Lenti84/VdMot_Controller/hardware/c3_housing_above.png

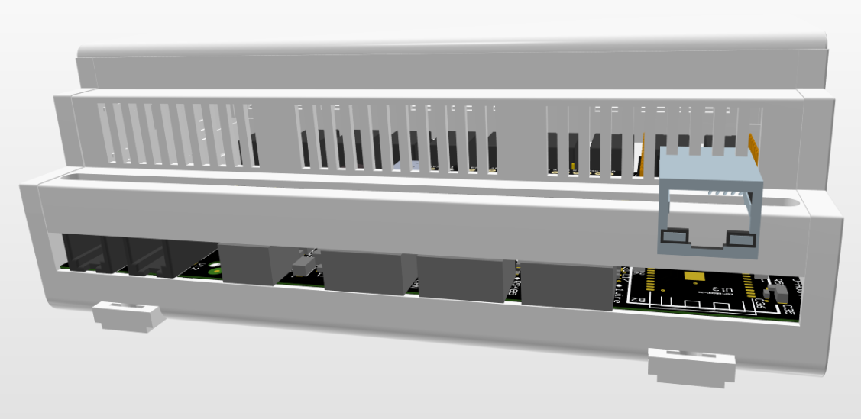
hardware/c3_housing_above.png
