Lenti84/VdMot_Controller/hardware/c3_housing_bottom.png

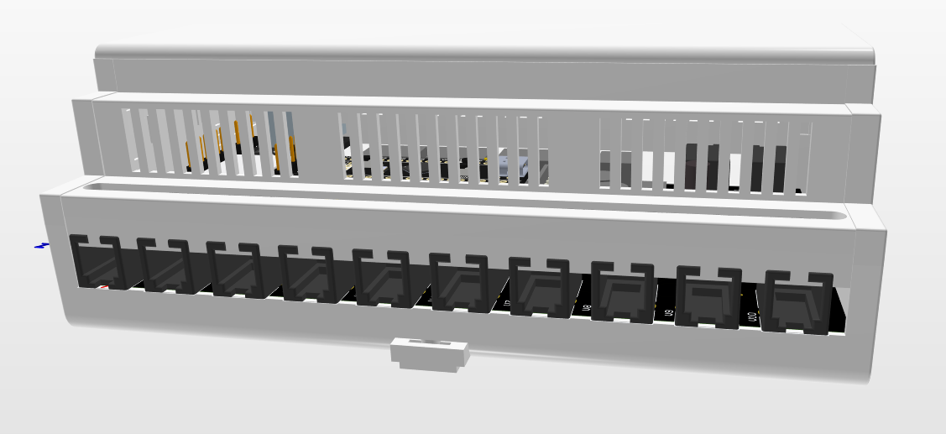
hardware/c3_housing_bottom.png
