Lenti84/VdMot_Controller/software_esp32/media/main.png

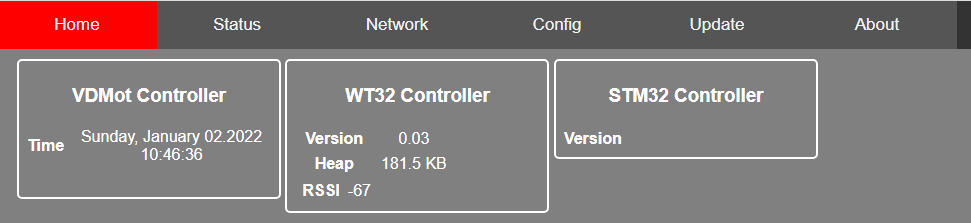
software_esp32/media/main.png
