Lenti84/VdMot_Controller/software_esp32/web_pages_source/h/window_close.png

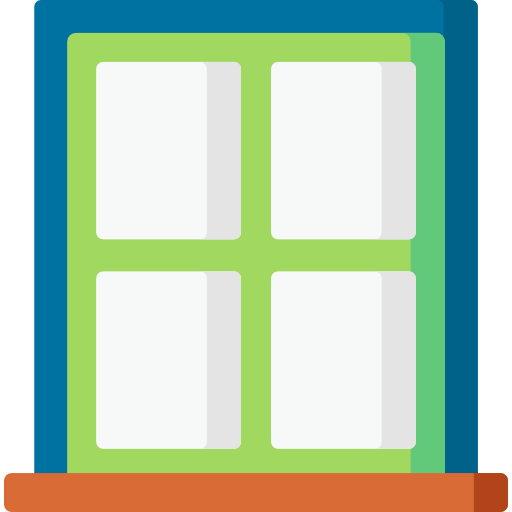
software_esp32/web_pages_source/h/window_close.png
