Lenti84/VdMot_Controller/software_stm32/ChangeLog.md

# Changelog
All notable changes to this project will be documented in this file.

## [Unreleased] - Development

### Breaking Changed

### Changed

### Fixed

### Removed

## [1.3.7]
### Fixed
- Config :      fix bug valve 12 set tIdx1 and tIdx2 was not saved

## [1.3.6]
### Changed
- rework motor end detection (filtering of motor current, no soft PWM for motor turn on anymore)

## [1.3.4]
### Changed
- faster motor end detection
### Added
- min. counts in eeprom
- calibration retries if counts less than min. counts in config

## [1.3.3]
### Added
- get chip id

## [1.3.2]
### Changed
- led heartbeat : change frequency 3s off / 100ms on

## [1.3.1]
### fixed
- next calibration : movements set to min. 50

## [1.3.0]
### Fixed
- calibration move numbers was not set from eeprom
- calibration function was not correct
### Added
- send calibration state to WTH32

## [1.2.2]
### Add
- send valve movements, open counts, close counts, dead counts with cmd APP_PRE_GETVLVDATA

## [1.1.0]
### Changed
- new command : APP_PRE_EEPSTATE : gets the state of eeprom (1 = ready, 0 = write pending)
- disable motDebug also in DEV to prevent handling UART in interrupt routines
- set default motor low / high to 17 (1.7) 

## [1.0.9]
### Fixed
- UART : max read length for UART buffer is limited to 990 now, not unlimited anymore
- valves : valve_loop() is now called via timer interrupt, this hopefully ensures correct motor drive and stopping during high system loads

## [1.0.8]
### Changed
- Softreset timing changed

## [1.0.7] 
### Added
- new STM32 commands

### Fixed
- fixed problems with configuration of 1-wire sensors (matching to valves)
