Lenti84/VdMot_Controller/(threads)

Thread 1 (2021-04-09):

Great Project

xal88, 2021-04-09:
Hallo,
habe  von deinem  Projekt im FHEM Forum gelesen.
Das wäre genau, was ich mir für meine Deckenklimatisierung als Steuerung wünsche.
Die ist nicht so träge wie eine Fußbodenheizung und braucht ordentliche Regelung, nicht nur 0/1.
Daten der Wärmepumpe, VL/RL und Thermostate habe ich schon in MQTT.
I2C fur HTU21D ( Humidity/Temperature -> Taupunkt im Verteiler )  würd ich am ESP dazubauen... ( die Onewire DHT22 sind Mist bei 100% Feuchte )...
Wenn du Prototypen/Kleinserie machst,  beteilige ich mich gerne an den Kosten und würd 1 zum testen  und ggf. 3 Stk für Echt nehmen
danke+lg
Alf

Lenti84, 2022-01-04:
Info: hinsichtlich Bausatz bitte immer mal wieder im FHEM Forum vorbeisehen: https://forum.fhem.de/index.php/topic,103699.0.html

xal88, 2022-01-07:
Hallo,
wegen Bausatz hab ich dir eine PM im FHEM Forum gesendt.
Wie sieht es aus mit feature requests für die nächste Serie? Mich würde ein Anschluss für einen Durchflussmesser ( interrupt/Hall ) interessieren, weiterverarbeitung dann über MQTT :-)
lg Alf

Lenti84, 2022-01-11:
Ziel für die nächste Revision ist quasi nichts zu ändern. Kann dir deshalb leider nichts versprechen.

Im aktuellen Release gibt es aber sogar noch ungenutzte Pins, die auf eine Stiftleiste herausgeführt sind.
Über X15:Pin7 (INT) lässt sich sicher ein externer Schalter anschließen. PullUp wäre auch vorhanden.
Softwareseitig müsste geklärt werden, ob der Pin PB8 für externe Interrupts genutzt werden kann.

Beste Grüße
Andreas

xal88, 2022-01-12:
Danke, alles klar. Ich glaub da nehm ich lieber einen IO vom ESP32 - ist auch einfacher für die SW-Erweiterung.
Mit dem STM32 kenn ich mich nicht aus...

Closed 2022-01-12.

Thread 2 (2021-09-06):

C-sample Hardware Issues and Change Requests

Lenti84, 2021-09-06:
I'm planning to design an updated version of the hardware. Next step of hardware will be called C-sample.
Therefore i want to collect known issues and possible change requests.

**currently known issues**
- B4: footprint for dc-dc converter: crossed secondary side pinout for gnd and vout
- V3: false assembly of NPN bipolar instead of PNP type
- X15, 21: hole diameter to small
- X1...X12: connection to MEBP_4-4S wrong: interchange pin 1 with pin 2
- no holes for case screws

**change requests**
- current consumption of L293 is 50 mA each, should be lowered, maybe U1, U3, U8 should be shut down during idle
- voltage devider at net "Sense" to match voltage levels better from opamp to STM32
- bypass capacitor for ESP8266
- replace relay K1 by analog switch
- support STM32F401 blackpill boards instead of STM32F103 bluepill
- maybe switch from ESP8266 to ESP32 or WT32-ETH01
- ....

Please feel free to comment your suggestions so maybe i can consider implementing them.

nstadigs, 2021-10-12:
Hi! Thanks for this great project!

I have 13 valves to control. Would it be possible to squeeze in control for an extra connector (or two, to make the number even)? Or maybe add support for an extension board? :grimacing:
I know this might be a big request, but I had to ask :)

Lenti84, 2022-01-04:
c-sample revision of hardware implemented --> closed

Closed 2022-01-04.

Thread 3 (2021-10-15):

Increase number of valves to control

Lenti84, 2021-10-15:
Hi! Thanks for this great project!

I have 13 valves to control. Would it be possible to squeeze in control for an extra connector (or two, to make the number even)? Or maybe add support for an extension board? :grimacing:
I know this might be a big request, but I had to ask :)

_Originally posted by @nstadigs in https://github.com/Lenti84/VdMot_Controller/issues/2#issuecomment-940762894_

Closed 2022-01-04.

Thread 4 (2021-10-15):

Correction function for DS18B20 temperature sensors

Lenti84, 2021-10-15:
Great to see some updates :-)
What I would like to have is an option to enter calibration values for the Onewire temperature sensors.
My temperature range is 15-32 deg Celsius ( cooling/heating )
If I have a bunch of DS18B20, I can see values +/- 1,5K. No need to meet the exact temparature, but all sensors should have the same base temperature, even when a little bit wrong.
Simple linear regression formula ( y= kx+d) with a way to enter the k,d values per sensor would help - otherwise I  would do that in the MQTT server.
Gold star solution to have an auto-calibration mode. Run once when the whole system is OFF and its cold ( e.g. 15°C), store the values), same when distribution cabinet is hot ( 35°, and all OFF for a while ). Then do the mean values and calc the regresssion.
Cheers Alf

_Originally posted by @xal88 in https://github.com/Lenti84/VdMot_Controller/issues/2#issuecomment-940857581_

Lenti84, 2022-01-04:
Will be implemented in next versions

Closed 2022-01-04.

Thread 5 (2021-10-21):

RJ45 Network

SurfGargano, 2021-10-21:
Is there a RJ45 Network available ?

Lenti84, 2021-10-21:
Next hardware revision (C-sample) will have a WT32-ETH01 board for communication with wifi and ethernet. So yes.

Lenti84, 2022-01-02:
Ethernet via RJ45 is available since c-sample revision.

Closed 2022-01-02.

Thread 9 (2021-12-31):

Why are there 2 MCUs?

unaiur, 2021-12-31:
Great project! It is something I has need searching for a while but I have one question... why is the second MCU required?

ESP32 is quite capable, has 2 "high" speed cores plus a low power coprocessor and plenty of peripherals, like a Hall effect sensor and an   opamp to measure current and a ADC that is fast enough to count revolutions by software.

I am sure you have some reason to use the STM mcu as the core instead. I just would like to know.

Thank you very much!

Lenti84, 2022-01-04:
I wanted to make the VdMot Controller a kind of modular.
STM32 is the core of the system for motor control, valve managing, RS485, 1-wire and optional CAN.
Wifi / Ethernet is only an option and realised via the ESP32 (older hw revision ESP8266).

If you look the other way round the STM32 is a cheap and intelligent port extension for the ESP ;-)
Meanwhile the STM32 it is fully flashable via ESP32 web interface...

unaiur, 2022-01-06:
Ummm, I would like to use the low power RiscV core inside Esp32s2 instead, to reduce the component count and make it simpler (I am a software guy).

Also, I will try to use the 13bit/6Khz ADC in that core to measure the active motor current across a 1ohm resistance and try to identify the back EMF using software implemented low/high pass filters.

xal88, 2022-01-07:
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

Hi,
I think that the project has a good modular HW design for now, with the ESP32 a very common, good available cheap chip.
And you can flash the STM32 from webserver on ESP...
The ESP2S has only 2 13 bit ADCs, so this is no option. And it is a single Core CPU, and the old ESP single cores had problems with interrupts when using WiFi....
But in the end its Andreas design, and he has put a lot of effort into the current design.

Lenti84, 2022-01-11:
I think to remember the motors do approx 8000 counted revolutions in 60s running time. So this should be slow enough for a software appraoch then.

Please keep in mind that with actual hardware concept you will need more pins than the usual ESP32 can offer. Thus you will need a port expander oder something similar.

But at the actual state of the project i cant justify such fundamental changes...

unaiur, 2022-01-12:
The Esp32s2 chip has two cores; a fast core and an ultra low power core
that is always on. Nonetheless, the ultra low power core has more than
enough power to control the motors.

I only plan to drive one motor at a time. I will select the active L298
chip using 8 pins and all 8 L298 will share the same 4 input lines. I will
use another pin to read the motor current: 13 pins in total to manage 16
motors.

The Esp32s2 has more than 20 available pins, so I have plenty of IO
available in case I need an external ADC or the hardware spin counter you
have.

I will keep you updated about my experiment.
I already ordered the pieces. If it works, I would try to build a single
board with all the components instead of 10 different interconnected boards.

Thank you very much!

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

Lenti84, 2022-01-26:
I wish you success! Keep us updated.

Closed 2022-01-26.

Thread 16 (2022-01-19):

ESP32 User Interface - More temperature sensors than valves

xal88, 2022-01-19:
Hello,
Usecase:  8 Valves, 10x Onewire sensor  ( one for each valve, plus one for manifold input and output )

* How will this look like in the status page ?

* Config page needs a mapping from Onewire_ID to Name and valve
   STM32 command list ist talking of 36 possible Temperature sensors
  ``` stsnx x y:    |   set first 1-wire sensor index y to valve x    |     x=0...11, y=0...35```

   And why are there 2 commands [ stsnx | stsny ], as there is only one 1-wire bus?

Thanks, and keep up your great work
regards

Lenti84, 2022-01-26:
Hi xal88,

this can look like following picture, but with more entries for each item:
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

Config page can now connect sensors to valves and sensor count was corrected.

There are two commands. One for first temp sensor assigned to valve x and one for second temp sensor assigned to valve x. Temp sensors are all connected to the same 1-wire bus.

Closed 2022-02-08.

Thread 23 (2022-02-12):

Information how to order

wendy2702, 2022-02-12:
Hi,

can you provide some information on how to order and costs?

Lenti84, 2022-02-13:
I recently put the board on tindie:
https://www.tindie.com/products/lenti/vdmot_controller/

Please have a view for scope of delivery, order information and costs.

Lenti84, 2022-04-15:
Hello everybody! Boards are now available via Tindie.

dreitakter, 2022-11-27:
The THT Parts are Not available in the Store.
I want to buy two complete Kits. Will this be possible soon or are These the Last parts that you sell?

Lenti84, 2022-11-27:
New/more THT parts will be available at the end of next week.

dreitakter, 2022-11-27:
Nice. Remind me when the parts are available. Thank you :)

Lenti84, 2022-12-07:
Last few parts for 2022 available at Tindie.
New parts will probably be available from january 23.

uplight-dev, 2023-01-06:
I'm not sure but is Tindie the only option to build this board(i.e. closed source)?
Or can I print this board myself to pcbway.com or similar?

Thanks!

Lenti84, 2023-01-07:
At the moment there are non plans to fully publish hardware sources (Gerber...).
But the full schematic, some description and BOM you can already find in GitHub.
As the project was not created in EasyEda, I will not port it.
Kind regards

Lenti84, 2023-01-20:
New boards, THT parts, BlackPill Boards and some WT32-ETH01 boards are back in stock at Tindie.

Check out https://www.tindie.com/products/lenti/vdmot_controller/
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

Lenti84, 2023-03-20:
Moved information to: https://github.com/Lenti84/VdMot_Controller/wiki/FAQ/

Closed 2023-03-20.

Thread 31 (2022-06-07):

ESP32 compile fails, please provide all BINs

xal88, 2022-06-07:
Hello,
asembled the kits last weekend, but could not compile via VSC Platformio. (C++ errors )

Could you please add the additional needed BIN-files for flashing the ESP32, so that I can use esptool.py without compiling?
(or did you pack all the files into your firmware.bin, so I could upload to address 0x1000 ?)

e.g.
```
esptool.py --chip esp32 --port COM4 --before default_reset --after hard_reset write_flash -z --flash_mode dio --flash_freq 40m /
            --flash_size detect /
            0x1000 bootloader_dio_40m.bin  /
            0x8000 partitions.bin /
            0xe000 boot_app0.bin /
            0x10000 firmware.bin
```

Erasing is working so far, so the system looks OK..
```
esptool.py --port COM4 erase_flash
    esptool.py v2.8
    Serial port COM4
    Connecting......
    Detecting chip type... ESP32
    Chip is ESP32D0WDQ5 (revision 1)
    Features: WiFi, BT, Dual Core, 240MHz, VRef calibration in efuse, Coding Scheme None
    Crystal is 40MHz
    MAC: 8c:ce:4e:94:82:dc
    Uploading stub...
    Running stub...
    Stub running...
    Erasing flash (this may take a while)...
    Chip erase completed successfully in 14.0s
```

Thanks for your help
Alfred

[202206071941_VSCcompile.log](https://github.com/Lenti84/VdMot_Controller/files/8855383/202206071941_VSCcompile.log)

xal88, 2022-06-07:
fixing resolution to int in helper.cpp at least makes it to compile and run...
```
String ConvBinUnits(size_t bytes, byte resolution)
{
  if  (bytes < 1024) {
    return String(bytes) + " B";
  }
  else if (bytes < 1024 * 1024) {
    return String(bytes / 1024.0,  int(resolution)) + " KB";
  }
  else if (bytes < (1024 * 1024 * 1024)) {
    return String(bytes / 1024.0 / 1024.0, int(resolution)) + " MB";
  }
  else return "";
}
```

Lenti84, 2022-06-07:
I added information for flashing ESP32 to https://github.com/Lenti84/VdMot_Controller/blob/master/assembly_kit/installation.md.
Bin files can be found at https://github.com/Lenti84/VdMot_Controller/tree/master/software_esp32

Firmware fix will be added soon to developer branch.

xal88, 2022-06-08:
could upload the provided .bin-files with ESP_Tools. VdMot is working now.
Would be great if you place **partitions.bin** in the same location ( had to take it from my VSC Platformio files )

The STm upload instructions should close with something like
* 11 Wait for upload finishes
* 12 remove X20 connection
* 13 ( reboot?)

Closed 2022-06-08.

Thread 32 (2022-06-07):

Webpage STM firmware - empty list after upload

xal88, 2022-06-07:
Hello,
when using the /stmupdate webpage, I can upload the file from my Computer.
File "STM32_C2_firmware.bin" is uploaded:
```
file has arguments : 1
file has argument stm
filename : /stm/STM32_C2_firmware.bin
upload finished
```
When trying to delete the file, the webpage is accessing
```
"remove(): /STM32_C2_firmware.bin"
```
and fails. The list ***Please select one file:*** stays empty, and no update for the STM32 can be selected.

Kind regards
Alfred
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

xal88, 2022-06-08:
this is working now with the new uploded binary 1.02

Closed 2022-06-08.

Thread 35 (2022-06-08):

How to set valve position target from remote

xal88, 2022-06-08:
Hello,
have 1 valve and 12 DS18B20 running now.
Data is forwarded to MQTT, and json can be queried by http get.

### How do I set the target valve position from remote?

* json command
how to  execute "/cmd"  with the stm *stgtp x y* ?
* MQTT changing the value setting /VdMot/valves/F01/target to 60 on the mosquitto server:
This crashes the MQTT client, temperatures are continuing updating, valve does not.
````
[E][WiFiClient.cpp:395] write(): fail on fd 54, errno: 104, "Connection reset by peer"
Reconnecting MQTT...
[E][WiFiClient.cpp:485] flush(): fail on fd 55, errno: 104, "Connection reset by peer"
Reconnecting MQTT...
[E][WiFiClient.cpp:395] write(): fail on fd 56, errno: 104, "Connection reset by peer"
Reconnecting MQTT...
[E][WiFiClient.cpp:485] flush(): fail on fd 57, errno: 104, "Connection reset by peer"
Reconnecting MQTT...
[E][WiFiClient.cpp:395] write(): fail on fd 58, errno: 104, "Connection reset by peer"
Reconnecting MQTT...
[E][WiFiClient.cpp:395] write(): fail on fd 59, errno: 104, "Connection reset by peer"
Reconnecting MQTT...
[E][WiFiClient.cpp:395] write(): fail on fd 60, errno: 104, "Connection reset by peer"
valve position has changed : 0 = 50
Reconnecting MQTT...
[E][WiFiClient.cpp:395] write(): fail on fd 61, errno: 104, "Connection reset by peer"
Reconnecting MQTT...
````

kind regards
Alfred

xal88, 2022-06-08:
and could you please remove the leading ***/*** in the mqtt path?
Gives an ugly empty structure...

thanks
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

xal88, 2022-06-09:
for MQTT I disabled the checkbox "Publish Target", but this did not change behavior.
After a "/config/Restore FactoryDefault settings" and giving different names for valve and sensor now this is working. I can set the target via MQTT.

For JSON I did a detailed reading of software.md (again), but the examples and instructions for JSON are only about reading values, and saving configs.  "/cmd2 is about triggering actions.
Could you provide an example how to set a target value?

xal88, 2022-06-09:
Update MQTT:
When setting /config/MQTT interval(ms) to a larger value ( tried 60000 for updates every minute ), looks like the subscribe times out, and gives the "104" error
Have not seen any keepalive setting in the code.
10000 ( =10s) works fine.

Closed 2022-10-14.

Thread 36 (2022-06-10):

Temperatur data of sensors with No. > 12 not published

xal88, 2022-06-10:
Have 14 sensors connected.

Only sensors with number <= 12 are published, if they are not asigned to a valve.
 ( same for GUI status, JSON /temps and MQTT /VdMot/temps/. )

 Plus the GUI sensor numbering in "/status/Temperature" and in "/config/Temperature sensor"  have different numbers for the same sensor :-(

Sensors with Numbers > 12 can be asigned to valves, and shows up correctly there.

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

### change proposal ###
I would opt that the /temps publishes ***ALL*** temperature values, not only the not asigned sensors. It is very hard to know for an external home automation system which sensor has which function. Plus the asigned sensor data vanishes, if the sensor is not there at boot, the not asigned sensors are found again at later time.
Kind regards
Alfred

xal88, 2022-06-12:
### update
checked with a sensor chain of 25 sensors.
The sensor chain was tested on an ESP32 on USB poer, DATA direct to PIN, with 4k7 pullup.
100 scans -> 100% detection rate, 100 reads per sensor -> 100% sucess rate

Looks like only the last sensor is not displayed in /Temperature

xal88, 2022-06-23:
After checking each sensor with single tests, I found  that the VdMot 1-wire is not working with all sensors.
Some are not detected  at scan, other detected, but no data, some get data if ID manually entered into GUI.
I will open an new issue for that.

For this issue, could you please add to the documentation, that only sensors are displayed that are found by scan ( less the asigned sensors ). Manually entered sensors are ignored in the output.
Furthermore please explain the function of the "active" tickbox in the /Config GUI. I cant see any changes after ticking this.

Closed 2022-10-14.

Thread 37 (2022-06-23):

1-Wire not seeing all DS18B20

xal88, 2022-06-23:
Some sensors are not detected by scan, others detected but no data.
GUI/config scan gives different results to the scans when booting.
Some sensor delivers data, if manually eintered ID in GUI/config

All sensors are tested and working with ESP PIN and 4k7 Ohm resistor.
Sensor answer is on the bus, but not picked up to i2c?

### Signaling on oszilloscope comparing ESP and VdMot looks ok.
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

### Logic compare "-22"  sensor detected, but no data,
ESP test sample OK
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
VdMot
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

### Logic compare "a9" sensor not detected
ESP Test sample OK
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
VdMot test
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

Lenti84, 2022-06-25:
If you compare the oscilloscope shots from ESP and STM you can recognize, that the voltage level with STM32 is not perfectly correct.
This is a flaw in the STM32 version of arduino 1-wire lib. But for my config it is working fine for currently 10 sensors.

I have tested a fix some time ago. I think it was in OneWire_direct_gpio.h
Instead of a PushPull output
`#define DIRECT_MODE_OUTPUT(base, pin)   pin_function((PinName)pin, STM_PIN_DATA(STM_MODE_OUTPUT_PP, GPIO_NOPULL, 0))`
a change to OpenDrain changed the voltage level problem
`#define DIRECT_MODE_OUTPUT(base, pin)   pin_function((PinName)pin, STM_PIN_DATA(STM_MODE_OUTPUT_OD, GPIO_NOPULL, 0))`

Maybe give it a try if this changes something.
I think i will integrate that in one of the next releases...

SurfGargano, 2022-11-12:
I have checked with 15 sensors and the modification in V1.05 of stm software: changing from push-pull to open drain.
It works.

xal88, 2022-11-12:
Thanks. Tried to compile the stm-1.05 with VSC/platformio, result is only 52 kB, old one was 198kB.
With esp32_1.02 and esp32_1.04 the file is growing from  1012->1128 kB.
Can this be right, could you maybe upload the stm firmware 1.05?

SurfGargano, 2022-11-13:
yes, 52 kB for stm 1.0.5 is correct The old one was about 48 kB
the esp file is 1106 kB with V1.0.5
I have uploaded the stm bin files in the bin directory in developer branch in my repo.
https://github.com/SurfGargano/VdMot_Controller/tree/developer/software_stm32/bin/v1.0.5

xal88, 2022-11-13:
WTH32 is at 1.05. OTA worked.
Tried to update the STM32 from 1.02 to 1.05.
Upload of the file ok, but after selecting file, and clicking "Update STM32 now" the progress bar goes to 5%, and then "error".
Self comiled firmware.bin or development branch same issue.
What am I doing wrong?

SurfGargano, 2022-11-13:
Pls try following : Format the spiffs by clicking the Format Button in Config section of the wth32. Upload stm bin file again and start the update of stm.Am 13.11.22, 21:14 schrieb Alf ***@***.***>:

  WTH32 is at 1.05. OTA worked. Tried to update the STM32 from 1.02 to 1.05. Upload of the file ok, but after selecting file, and clicking "Update STM32 now" the progress bar goes to 5%, and then "error". Self comiled firmware.bin or development branch same issue. What am I doing wrong?
  —Reply to this email directly, view it on GitHub, or unsubscribe.You are receiving this because you commented.Message ID: ***@***.***>

xal88, 2022-11-14:
Tried on 2 different VdMot boards, firefox or chrome, with WT32 on 1.05.
"/config/Format FS" gives no status update, just reboot. Uploaded Files are gone afterwards.
"update/ST32" gives 5%, than error and reboot.
Syslog atomic shows no useful messages, only the ones about the valve positions.
What else can I do - Blackpill update via external serial?

SurfGargano, 2022-11-14:
After Format the file info on the config page should be invisible. Is the stm still working?What does the serial debug of wt32 says?Am 14.11.22, 12:12 schrieb Alf ***@***.***>:

  Tried on 2 different VdMot boards, firefox or chrome, with WT32 on 1.05. "/config/Format FS" gives no status update, just reboot. Uploaded Files are gone afterwards. "update/ST32" gives 5%, than error and reboot. Syslog atomic shows no useful messages, only the ones about the valve positions. What else can I do - Blackpill update via external serial?
  —Reply to this email directly, view it on GitHub, or unsubscribe.You are receiving this because you commented.Message ID: ***@***.***>

Lenti84, 2022-11-14:
Have you tried initial flash with Pressung boot0 button in BlackPill Board?

https://github.com/Lenti84/VdMot_Controller/blob/master/assembly_kit/installation.md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

xal88, 2022-11-14:
update to 1.05_Dev initial flash did work, thanks for your help.
Connected 32 senors ( all I have ), found all - even the cheap chinese problematic ones.
Will close the issue.

Closed 2022-11-14.

Thread 39 (2022-10-15):

ESP32: STM32 Update list no files with V1.0.3

SurfGargano, 2022-10-15:
Some has changed in SPIFFS 2.0. Handling Slashes doesn't wok anymore. The filenames are stored without pathname.
So the V1.03 doesn't list the filenames.
This is fixed in V1.04. All files will be listed.
In next version spiffs will be changed to littlefs, because spiffs is deprecated.

SurfGargano, 2022-11-12:
Fixed in V1.04

Closed 2022-11-12.

Thread 45 (2022-11-11):

Multiple controllers for one room

zillawilli, 2022-11-11:
Hello

I have the following problem.

In my case, the kitchen is quite large, so the installer has installed 4 loops of floor heating.
Two are short, as these are to heat only a narrow edge to the outside wall.
The other two loops are long and heat the rest of the kitchen.
Each loop has its own valve.

As I understand it, only the control of one heating circuit per room is possible, right?

Would it be possible to group several circuits of a room together?

I would imagine this to be the case:
The inlet temperature must be measured with a single sensor.
Now, in order to theoretically determine the individual lengths of the combined heating circuits, a reference measurement must be made.

For this purpose, the temperature and the time until a certain temperature is reached is measured at the return of each circuit. The longest heating circuit requires the most time, the shortest accordingly less.
Based on this determined time, the longest heating circuit is now determined to the master and its return temperature is used as the setpoint for the other circuits. At the master, for example, the valve is 100% open, the other circuits correspondingly less.
If now the master must be opened more than 100%, a message is needed because of too low inlet temperature.
If now the valve with the smallest opening would have to be closed by the control, a message with too high inlet temperature is needed.

What do you say to this? Would something like this be possible?

greetings
William

SurfGargano, 2022-11-11:
If you have several loops of floor heating in one room , you have to make a hydraulic adjustment. That is important.

You can group the valves together in the control section, if you use the on-board valve controller.
But only one thermometer is used.

I have 3 loops of floor heating in living area, dining area and kitchen in one room. It works.

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

xal88, 2022-11-11:
Hi,
VdMot is flexible with assigning sensors to multiple circuits. And your control strategy is completely in your hands.
Without knowing the general setup ( what heat source, pump type and flow... ) its difficult to advise.
I would go with a static machanical hydraulic balance setup for your 4 kitchen valves, no need for motorvalves there.
Treat them as one circuit and control via heating system
BR Alfred

zillawilli, 2022-11-15:
Hello

Thank you for your responses, which have inspired me to think further.

The procedure for rooms with multiple heating circuits, in my case with four circuits, would now be as follows:

I measure the return temperature over time for all circuits.
Now all valves are opened completely and the flow reducers are also set to 100%.
After a time of 30 minutes the log files are read out and examined in a program.
Depending on the length of the heating circuit, a certain return temperature will be set.
The circuit with the longest pipe has the lowest temperature. The shortest has the highest.
Now the flows are reduced until all have the same return temperature as the longest heating circuit. But the valves are all still 100% open.
That is what I understand by hydraulic balancing.
Only now each valve is controlled individually, so that the return temperatures are all the same.

kind regards
William

Hallo

Danke für eure Antworten, die mich zum weiteren Nachdenken angeregt haben.

Der Ablauf bei Räumen mit mehreren Heizkreisen, in meinem Fall mit vier Kreisen, wäre nun folgend:

Ich messe bei allen Kreisen die Rücklauftemperatur über die Zeit.
Nun werden alle Ventile komplett geöffnet und die Durchflussminderer ebenso auf 100% gestellt.
Nach Ablauf einer Zeit von 30min werden die Logdateien ausgelesen und in einem Programm begutachtet.
Je nach Länge des Heizkreises wird sich eine bestimmte Rücklauftemperatur einstellen.
Der Kreis mit dem längsten Rohr hat die niedrigste Temperatur. Der kürzeste die höchste.
Nun werden die Durchflüsse so lange reduziert, bis alle die gleiche Rücklauftemperatur wie der längste Heizkreis aufweisen. Die Ventile sind aber alle noch zu 100% geöffnet.
Das ist, was ich unter einem hydraulischen Abgleich verstehe.
Nun erst wird jedes Ventil einzeln angesteuert, so daß die Rücklauftemperaturen alle gleich sind.

freundliche Grüße
William

Lenti84, 2023-03-20:
Moved information to: https://github.com/Lenti84/VdMot_Controller/wiki/FAQ

Closed 2023-03-20.

Thread 50 (2022-11-27):

Cable length to actors

dreitakter, 2022-11-27:
Hi.
Do you have any Idea which cable length is possible between the Controller Board and the actors?

SurfGargano, 2022-12-19:
I have 10 meters from controller to 2 actors installed. It works without problems. I used shielded KNX kable ( 4x 0.8 mm²).

Lenti84, 2023-03-20:
Moved information to: https://github.com/Lenti84/VdMot_Controller/wiki/FAQ

Closed 2023-03-20.

Thread 53 (2022-12-26):

ESP32 Software Ver. 1.05 no longer accepts changes.

SteffenB71, 2022-12-26:
ESP32 Software Ver. 1.05 no longer accepts changes. I can no longer add valves or change the station name. The old settings are always there again after save config.
Already deleted the ESP and flashed it again, but still no change. Remedy has version 1.02 because everything is normal.
Got the C2 board.

Steffen

Lenti84, 2022-12-29:
Had a look at it. With V1.05 the setting the station name is fine. Also detecting valves and naming them.
I switched between 1.02 and 1.05. Both seem to work correctly.

But i discovered a flaw when using some more 1-wire sensors.
Linking to the valves is only possible for some of the first valves. The last ones will never be linked to any 1-wire sensor.

A fix will be available soon. Had to rework the communication between STM32 and ESP32 a bit. Also reset behaviour.

Maybe you can check the behaviour with next release, as there are some other changes regarding config of controller.

SteffenB71, 2022-12-30:
Hello
I've even flashed a new ESP now, but it still appears the same. It does not save any new settings. Where are all the settings saved, that even a new ESP has the same Venoman.

Steffen

Lenti84, 2022-12-30:
Hmm, most of the settings are saved into the flash of the ESP32/WT32. For example the station name is stored there. But 1-wire settings are saved into the serial EEPROM connected to the STM32.

Does in your setup some settings exist, which will be stored correctly? Can you give a short list?

At the moment I have not really an idea. But i will look for a solution...
Maybe using a newer firmware version will help. I will soon publish version 1.07. Please try with this version and report.

best regards

Lenti84, 2023-01-04:
Please try newest firmware: https://github.com/Lenti84/VdMot_Controller/releases/tag/v1.0.7

SteffenB71, 2023-01-05:
Hi
With version 1.07 everything can be set and saved again. Thanks for the support. I have to update the STM chip as in the instructions or because the ESP can be updated online without having to go to the circuit board.
Steffen

Lenti84, 2023-01-07:
Dont know if I understand right.
But you can flash both Controllers via the web interface. No need to go to the circuit board.
For STM32 just make sure X20 is jumpered and you have selected "normal Partition".

Glad to hear it ist working again.

Best regards

SteffenB71, 2023-01-07:
Hi
That was exactly my question. When flashing the STM32 I have to set the jumper X20 and press the Boot0 button after the start:
1. Short jumper X20 - this allows the ESP32 to Reset STM32 and start the Bootload sequence
2. Power up VdMot Controller
3. Open VdMot Controller website and goto "Update"
4. Click on "Update STM32"
5. Choose the STM32 firmware file to upload
6. Click "Upload STM32 file"
7. Choose Option "boot partition" for initial flashing
8. After Upload choose correct file in filelist
9. Press BOOT0 Button at BlackPill Board until flashing progress is >15%
10. Click "Upload STM32 now"

Now write I should set to "normal partition". So you set the "Boot0 partition" only the very first time.
thanks

Lenti84, 2023-01-30:
Updated https://github.com/Lenti84/VdMot_Controller/blob/master/assembly_kit/installation.md.
Now there is distinction between regular and inital flashing of STM32.

Closed 2023-01-30.

Thread 54 (2023-01-01):

problems with the mqtt conversation

Dobi62, 2023-01-01:
Hello
Between Christmas and New Years I soldered my board together and installed the latest software.
Mqtt is running and I get all values   in FHEM but can't send any. When I send values, no matter what, I see them being sent, but the values   do not arrive in the VdMot. This applies to sending from FHEM as well as from the MQTT Explorer.
These are similar errors as xal88 had in june 22.
What are the temp1 and temp2 fields in the Status tab for?
Are these placeholders for should and actual value?
How can I set this?
Is there anything to consider? Is there an explanation of the software on the internet?
I am thankful for every help.

Lenti84, 2023-01-02:
Please have a look at the software documentation at: https://github.com/Lenti84/VdMot_Controller/blob/developer/software.md
Please check, if setting the checkbox "Target" under "Protocoll/Publish" makes any difference.

For further debugging you can use a Syslog server installed to your PC. I'm using "Visual Syslog Server 1.6.3".
With a syslog server you can view a lot of debugging info of the controller.
For example a received MQTT message for a valve target would be showen as: "_Message: found topic WZSued/target : 16_"
Please setup the syslog server at the config tab, section "Network", at the bottom.

And here is an example piece of code how i have set up my controller under FHEM:
```
define mqtt MQTT 127.0.0.1:1883

define VdMot_Valve_1 MQTT_DEVICE
attr VdMot_Valve_1 IODev mqtt
attr VdMot_Valve_1 devStateStyle style=color:blue;;font-weight:bold;;text-align:right
attr VdMot_Valve_1 room MQTT
attr VdMot_Valve_1 stateFormat Ist: actual Status: state Strom: meancurrent Temp: temp1 Temp2: temp2
attr VdMot_Valve_1 subscribeReading_actual /VdMotFBH/valves/TestV/actual
attr VdMot_Valve_1 subscribeReading_meancurrent /VdMotFBH/valves/TestV/meancur
attr VdMot_Valve_1 subscribeReading_state /VdMotFBH/valves/TestV/state
attr VdMot_Valve_1 subscribeReading_temp1 /VdMotFBH/valves/TestV/temp1
attr VdMot_Valve_1 subscribeReading_temp2 /VdMotFBH/valves/TestV/temp2

define Heizung_Bad_Slider2 dummy
attr Heizung_Bad_Slider2 room MQTT
attr Heizung_Bad_Slider2 setList state:slider,0.0,1.0,100.0
attr Heizung_Bad_Slider2 webCmd state

define Heizung_Bad_SliderNotify2 notify Heizung_Bad_Slider2:* { \
my $sliderwert = \
ReadingsVal("Heizung_Bad_Slider2","state","on");; \
fhem ("set mqtt publish /VdMotFBH/valves/TestV/target $sliderwert");;
}
```

Hope this helps to find the problem.

Dobi62, 2023-01-02:
Thanks for the answer.
That with the syslog definitely has to be stored somewhere. Also thanks for the fhem definitions, but I switched everything to mqtt2 about 1.5 years ago. But that's not the problem either.
After I set everything to zero, named everything again and then rebooted the system, I can at least open and close the valves. The whole thing even though the topic target is not transferred at all. It is not possible to enter temp1 and temp2.
They stay at -50.

That would be enough for regulation using Fhem. But now, in the heating season, it wouldn't be bad if VdMot could quickly take over control.
Somehow I also have in my head to have read that this is possible.
But therefor you have to be able to transfer the target value and actual value. But which values   do I have to set and how?
I cannot set temp1 and temp2.

Set MQTT2_FHEM_Server public VdMot/valves/Kueche/target 65  works and sets the kitchen valve to 65%
Set MQTT2_FHEM_Server public VdMot/valves/Kueche/temp1 22 doesn't work and no reaction in the syslog.

anyone have any ideas

I do not anymore

Lenti84, 2023-01-02:
Temp1 and temp2 can't be set via MQTT. They are only published to broker according to the setup on config page for every valve.
To every of the 12 valves, max. 2 of the 1-wire sensors can be linked to. For example for measuring return flow temperature or floor temperature. The temperature of this 2 sensors will then be published via MQTT under the subtopic of the valve. So you do not have to worry about which 1-wire sensors belongs to which valve when controlling over MQTT.

If you want to use the integrated controller (tab "control"), you can set the actual and target value by MQTT via following topics  as documented under: https://github.com/Lenti84/VdMot_Controller/blob/developer/software.md, section _MQTT Interface WTH32_

topic | direction | description
-- | -- | --
maintopic/valves/valvesubtopic/tValue | subscription | actual temperature value for integrated valve position control
maintopic/valves/valvesubtopic/tTarget | subscription | temperature setpoint for integrated valve position control

With this MQTT values the integrated PI controller will calculate the needed valve position.

Is this what you want to do?

SurfGargano, 2023-01-04:
Using fhem please uncheck the 'Target' checkbox in config/protocol/publish

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

Dobi62, 2023-01-04:
Thanks for all the info.
As I said, closing and opening the valves now works wonderfully. Not with setting an actual temperature and the target temperature. They should appear under Control/Value or Control/Target. Or?
So I'll put the whole thing aside for now and take care of it again in the summer. In any case, there is no time to try it out during the heating period.
It would be nice if a few examples were described somewhere.

Closed 2023-04-28.

Thread 55 (2023-01-03):

ESP32 with Lan

Elluminatus, 2023-01-03:
Hi I‘m wondering if there could be a esp32 with Lan possible on the board? Thank you for your help

Greetings Thomas

Elluminatus, 2023-01-03:
Oh I saw that the C Sample has a Lan Port available

SurfGargano, 2023-01-04:
The esp32 we used is the WT32 - ETH01. Thie module has wifi and eth on board.

Elluminatus, 2023-01-04:
Thank you very much. I send you some questions via Tindie, maybe you can contact me.

Gesendet: Mittwoch, 4. Januar 2023 15:56
An: Lenti84/VdMot_Controller ***@***.***>
Cc: Elluminatus ***@***.***>; Author ***@***.***>
Betreff: Re: [Lenti84/VdMot_Controller] ESP32 with Lan (Issue #55)

The esp32 we used is the WT32 - ETH01. Thie module has wifi and eth on board.

—
Reply to this email directly,  <https://github.com/Lenti84/VdMot_Controller/issues/55#issuecomment-1371031254> view it on GitHub, or  <https://github.com/notifications/unsubscribe-auth/AGZ5E5P3HHKTVQFIWDE77HLWQWFO3ANCNFSM6AAAAAATQFMYYQ> unsubscribe.
You are receiving this because you authored the thread.  <https://github.com/notifications/beacon/AGZ5E5NWEQXAMVO4CSZACETWQWFO3A5CNFSM6AAAAAATQFMYYSWGG33NNVSW45C7OR4XAZNMJFZXG5LFINXW23LFNZ2KUY3PNVWWK3TUL5UWJTSRXBDNM.gif> Message ID: < ***@***.***> ***@***.***>

Lenti84, 2023-01-12:
Your welcome. See my answers at Tindie. Kind regards.

Closed 2023-01-30.

Thread 59 (2023-01-30):

Flash ESP32

bluephoenix28, 2023-01-30:
Hi,
I am running Linux and want to flash the ESP32 with the esptool. To what adresses do I need to flash the precompiled binaries bootloader_dio_40m.bin and boot_app0.bin?

Lenti84, 2023-01-30:
Did you have a look at https://github.com/Lenti84/VdMot_Controller/blob/master/assembly_kit/installation.md ?
See section _Initial ESP32 / WT32 Flash via Flash Download Tool_.

bluephoenix28, 2023-01-30:
Sorry, I missed that out. Now things are running, thx.
For those who are also using Linux, I paste here how to flash the black pill and how to flash the ESP32.

---------------------------------------------------------------------------------
Flash the black pill with dfu-util, not connected to the Vdmot board

1) Remove the USB cable
2) Press and Hold the buttons NRST and BOOT0
3) Connect the USB-C cable
4) Release the NRST button
5) Wait 1 second
6) Release the BOOT0

Check that the device is found by Linux
$ dmesg

[ 4416.393784] usb 1-4: new full-speed USB device number 12 using xhci_hcd
[ 4416.646928] usb 1-4: New USB device found, idVendor=0483, idProduct=df11, bcdDevice=22.00
[ 4416.646930] usb 1-4: New USB device strings: Mfr=1, Product=2, SerialNumber=3
[ 4416.646930] usb 1-4: Product: STM32  BOOTLOADER
[ 4416.646931] usb 1-4: Manufacturer: STMicroelectronics
[ 4416.646932] usb 1-4: SerialNumber: 3454367C3430

Check that the device is found by dfu-util
$ sudo dfu-util -l
dfu-util 0.9

Copyright 2005-2009 Weston Schmidt, Harald Welte and OpenMoko Inc.
Copyright 2010-2016 Tormod Volden and Stefan Schmidt
This program is Free Software and has ABSOLUTELY NO WARRANTY
Please report bugs to http://sourceforge.net/p/dfu-util/tickets/

Found DFU: [0483:df11] ver=2200, devnum=30, cfg=1, intf=0, path="1-4", alt=3, name="@Device Feature/0xFFFF0000/01*004 e", serial="348236533430"
Found DFU: [0483:df11] ver=2200, devnum=30, cfg=1, intf=0, path="1-4", alt=2, name="@OTP Memory /0x1FFF7800/01*512 e,01*016 e", serial="348236533430"
Found DFU: [0483:df11] ver=2200, devnum=30, cfg=1, intf=0, path="1-4", alt=1, name="@Option Bytes  /0x1FFFC000/01*016 e", serial="348236533430"
Found DFU: [0483:df11] ver=2200, devnum=30, cfg=1, intf=0, path="1-4", alt=0, name="@Internal Flash  /0x08000000/04*016Kg,01*064Kg,03*128Kg", serial="348236533430"

Flash the black pill with the F411 chip
$ sudo dfu-util -d 0483:df11 -a 0 -s 0x08000000:leave -D firmware_F411ce_C2.bin

------------------------------------------------------------------------------------------------

Flash the ESP32 with the esptool (Python script) and an FTDI (USB2UART) converter, not connected to the Vdmot board

esptool --chip esp32 --port /dev/ttyUSB0 --baud 115200 --before default_reset --after hard_reset write_flash -z --flash_mode dout --flash_freq 40m --flash_size detect 0x1000 ./VdMot_Controller-master/software_esp32/bootloader_dio_40m.bin 0x8000 ./VdMot_Controller-master/software_esp32/ESP32_partitions.bin 0xe000 ./VdMot_Controller-master/software_esp32/boot_app0.bin 0x10000 ./VdMot_Controller-master/software_esp32/ESP32_firmware.bin

Closed 2023-01-30.

Thread 61 (2023-02-03):

Config and Control sections

bluephoenix28, 2023-02-03:
Could please explain the meaning of some of the fields in the Control and in the Config section?

**Control page**:
- What does Xp, Offset, Ti, Ts mean? I guess Ti and Ts are the parameters of the PI controller, but the rest...?
- What is the difference between dynamic ki and static ki?
- How can I determine the Active zone? Do I need to extract the current values for, as in your measurements for the two different valves?
- What does happen in the manual heat control mode? Is Xp the dedicated position for that?

**Config page**:
- What do the Characteristic values in the Motor section mean?

SurfGargano, 2023-02-08:
Xp is the constant part of the proportional value (kp = 100/ Xp)
Offset is a constant temperature offset , that is added to the measured temperature value
Ti is the integral value of the I – part
Ts is the samplig time in seconds, that starts the next calculation.

Dynamic ki means that the I – part will be calulated with the proportional value  (kp*e, e = new difference from target-temp value)
Dynamic is more quick when the difference is greater.
Static ki means that the I-part will be calcuated with a constant ki – value.
HeatControl:
Manual :
The Pi- Controller is disabled, no Calculation will be executed . You can control the valves by yourself. (setting the target position in the status page or via mqtt)
On :
The Pi- Controller is enabled,
Off :
The Pi_Controller is disabled and the valves goes to the park position. Useful in summer.

Determinate the active zone is not trivial. With 100 % valve position you may have a relaxed position of the valve. You now decrease the valve postion until the valve is solid.

Characteristic values in the Motor section:
Low, High : Detection for end low position of the motor. This is calulated by the mean current (mA) oft he motor multiplied with the low/high value.
e.g Low value = 2.0
The motor draws electricity normally 20mA. So the endposition is detected when he draws
20* 2.0 = 40 mA.
The same for high value, the other endposition.

Closed 2023-02-09.

Thread 62 (2023-02-14):

isr calls callback right when isr_target reached but motor might still spin

QuadCorei8085, 2023-02-14:
I don't have your board or debugged the code just went through the schematic and the codebase.

Assuming I issue a few steps of open/close to the motor 1000-100000x would'nt this approach lose the correct position after a while?

I'm assuming the rotor counter works to a certain speed (amplitude gets lower) so at lower speed this loses the steps which I believe negligable (?) effect if motors are operated in ON/OFF mannger.

But also the ISR quits counting right when reaching the target, any DC motor in my experience will still rotate in freewheeling mode (don't know how much here we are talking about but the error will be accumulated). Now i'm certain it wont be simmetrical in both ways so this counting up/down will eventually cause a drift error in the step following.
Would'nt it be more precise to wait till the ISR/tacho impulses "ramp down"? Once target is reached the counting continues for 100-500ms you would have more accurate position tracking.

If I saw it correctly the opening and closing states detect endpositions thus sooner or later this would be noticed.

Lenti84, 2023-02-16:
If you don't have one, get one ! ;-) Just kidding...

You are right, moving the motor very often will give worse accuracy.
This fact is handled by two things:
1. You can configure the controller to do a calibration cycle depending one the weekday. Max. is 1 cycle each day.
2. You can define the count of movements of the motor, until a new calibration cycle is performed automatically.
This helps to keep accuracy up.
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

Additionally the normal usecase is to use the controller for valves, which are controlled by an overlying temperature controller. This will compensate small deviations between target and real position.

Motor is operated only on/off. No linear regulation. So BackEMF is most of the time at a high level and triggering the counter.

I never measured the time or the signals of the motor in the moment it is turned off. But I would also think there is some movement even the controller has shut off the current. So behaviour should be asymmetric, yes.
And it is additionally asymmetric, because in closing direction the spring in the valve helps closing, but in opening direction the motor has to push against the spring.

I will put the idea with counting until the signals are lost after motor turn off on my list. Maybe this will be part of the software in further versions. Thanks for your suggestion.

Info: for the typical VdMot valve the counter counts around 7500 pulses for a full movement of the motor. This value is measured each calibration cycle and then used to calculate from % movement to counts.

QuadCorei8085, 2023-02-16:
Oh nice wasn't aware of this featuer, well thought through.
I already have a thermostat running on esp32 just checking the motvd option as it is tempting to have a settable min flow rate to keep the floor semi warm and have a faster reaction time for the heating.
I think i will use an ina219 and just rely on current measurement, i don't need exact position as the min flow will regulate on pipe temp and for heating i think the valves will be opened fully, or maybe  regulated by +/- steps based simply on time.
The rotor counting seems too complicated (compared to the simple current based start/end position finding + time based steps) and somehow I feel (regardless how awesome it looks) it looses the point in my case where the pump can not pressurize all 7 loops and based on how many of them are open the flowrate will fluctuate.

Closed 2023-02-16.

Thread 63 (2023-02-18):

question - vdmot currennt graph

QuadCorei8085, 2023-02-18:
I'm only opening an issue because discussions are not enabled.
I ordered 2 vdmot to play around and tried one of them on my distributor.
I'm not familiar with various distributor or valve types, mine is open (full flow) when the needle is not pressed in (default). The wax valves are pushing them in in cold phase and when heated up the wax expands and releases the pressure.

So my issue is that in my case I can not really identify anything from current measurements. (vdmot top=fully retracted)
Here is a valve closed (vdmot at bottom going top) -> opening sequence:
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

The case of the valve is fully opened (vdmot starts from top position) -> close:
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

If I see it correctly in you case the vdmot push pin has a play/gap so you have a freewheeling ~18mA phase, then a contact period, and a definitive section where the pin is pushed all the way in.
I guess you also can't tell when the flow starts/stops just from end positions of the motor?
I also found that there is a huge "hysteresis" between opening and closing when microstepping the motor with 20-50ms impulses.

Also funny how much smoother your current measurement is, I used the PPK2 from nordic. You can literally see the commutation:
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

Lenti84, 2023-02-18:
Did you had a look at https://github.com/Lenti84/VdMot_Controller/blob/master/system/actuators.md ?
There you will find my measurements from the beginning of the project.

The water flow normally can not be determined by the current consumption of the valve motor.
Maybe only if you have enormous pump pressure and the valve needle must be pushed against that force. But i dont think this is realistic.

Actual software only can detect endpoints of the valve needle by drastic increase in current consumption.
Additionally the commutations are counted to derive a position from 0...100% between the two endpoints.

Some idea i have in mind is to detect the moment, where the valve motor (vdmot) hits or leaves the valve needle (around 2600) and the point, where the needle compresses the rubber seal inside the valve (around 6300).
Both points can be observed in the current curves from https://github.com/Lenti84/VdMot_Controller/blob/master/system/actuators.md.
Both points would give a new 0...100% range for valve movement, which is nearer at the truly arising flow.
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

QuadCorei8085, 2023-02-19:
Yes I saw your measurements that is why I asked the question.
I believe mine looks like the motor always have a contact with the needle hence there is no ~15mA region in my measurements.
Also the rise at both ends looks different in my case especially when the vdmot hits its own end position.
In my case the current rises quite quickly, and rises much slower when compressing the valve.

What I meant is the actual valve authority (0-100% flow) is a much narrower band than the motor current given end-points. And there is a huge deadzone in my case on both ends. Finding the end position (vdmot fully extended - valve fully closed) is relatively easy but how much I need to step back is not trivial, as I will not know when the water starts to flow or stops.

I wonder how the homematic and other systems handle this.
It simply sounds illogical to me just to measure the endpoints of the motor.
Somehow that also needs to be calibrated or measured via other methods what is the flow.
Or is the flow in your case 0-100% in the calibrated range?

SurfGargano, 2023-02-19:
Pls see also https://github.com/Lenti84/VdMot_Controller/issues/61

0-100% is calculated in the calibrated range.

Closed 2023-02-23.

Thread 69 (2023-02-21):

3d stl file

bluephoenix28, 2023-02-21:
Hi,
I am currently working on a housing to be 3D-printed and it would be helpful to have a 3D file of the assembled PCB. Is it possible to provide a stl file or some other format, I can import into Freecad?

Lenti84, 2023-02-21:
Would a step .stp file help? This is supported by my toolchain for sure. FreeCAD can read step.

bluephoenix28, 2023-02-21:
Hi, yes step ist totally fine! Thanks.

Lenti84, 2023-02-23:
Please have a look at https://github.com/Lenti84/VdMot_Controller/blob/master/hardware/c3-sample_3D.rar

Please consider measure tolerances of piggyback boards and connectors.

bluephoenix28, 2023-02-23:
Perfect

Closed 2023-02-23.

Thread 72 (2023-02-26):

Description and function of the input fields

zillawilli, 2023-02-26:
Hello togetherness

Is there a description regarding the function of each input field please?

Hallo Miteinander

Gibt es eine Beschreibung bezüglich der Funktion der einzelnen Eingabefelder bitte?

Thank you
willi

Lenti84, 2023-03-02:
Hi, I have started to use the wiki right now. Hope i can fill it in the next time.

https://github.com/Lenti84/VdMot_Controller/wiki

Closed 2023-03-20.

Thread 73 (2023-02-27):

Linked valves not synchronously parked when control is disabled

elektronikworkshop, 2023-02-27:
Hi Lenti,

I just set up my system and it will produce most probably some more bug reports than this, because it's huge and comes with different corner cases. But that's good - it will lead to a more reliable system. And if I have some spare time I can contribute to the development as well. That all said, lets get to the first bug report:

I've configured my system such that I can check the status of my two circulation pumps. One pump drives three VdMots and the other two. When I detect that one of the pumps is disabled (during the night) I disable the regulation by the corresponding VdMot. This is to prevent a) noise and b) unnecessary wear of the valves.

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

When I got it up and running I discovered that only the main valve gets parked when the controller is disabled. All the linked valves stay in their original position. I'm showing here only one controller, but the other behaves the same:

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

I would assume that this is not the desired behavior. Desired/expected behavior would be in my understanding, that all valves move to the parked position.

Regards!
EW

SurfGargano, 2023-03-03:
Is fixed in 1.1

Closed 2023-04-28.

Thread 74 (2023-02-27):

Option for not parking the valves when regulation is disabled

elektronikworkshop, 2023-02-27:
This is a feature request, so feel free to flag it accordingly.

This is related to #73 : It would be desirable having an option to leave all valves at their current position when disabling temperature regulation (i.e. `maintopic/common/heatControl` set to `2` (Off)). This avoids unnecessary travel and therefore noise and wear of the valves.

This could be a boolean flag/check box in the UI.

Thanks and regards
EW

elektronikworkshop, 2023-02-27:
I probably found a work around (not having tested it for long so far): Instead of setting it to `2` (Off) you can set it to `0` (Manual). This seems to leave the current valve positions alone. This would be acceptable for me so feel free to close this issue.

elektronikworkshop, 2023-02-28:
This seems to be a viable option for me - so I close the issue.

Closed 2023-02-28.

Thread 75 (2023-02-27):

VdMot WT32 crashes repeatedly

elektronikworkshop, 2023-02-27:
Same behavior with 1.0.7 and 1.0.8 - here's the backtrace:

```
[...]
pop gvlon 255
pop gvlst
Reconnecting MQTT...

Stack smashing protect failure!

abort() was called at PC 0x400ef5d4 on core 1

Backtrace: 0x40082fe1:0x3ffb1fc0 0x4008d33d:0x3ffb1fe0 0x40091f8d:0x3ffb2000 0x400ef5d4:0x3ffb2080 0x400d91b5:0x3ffb20a0 0x400d950f:0x3ffb2150 0x4015855b:0x3ffb2170 0x400de261:0x3ffb2190 0x400d9982:0x3ffb21d0 0x400d7eb6:0x3ffb21f0 0x400d8336:0x3ffb2210 0x400deb9b:0x3ffb2230 0x400de8fa:0x3ffb2250 0x400d8d26:0x3ffb2270 0x400e8d61:0x3ffb2290

ELF file SHA256: 0000000000000000

Rebooting...
VdMot_Controller
Start Config
SPIFFS booted
get file : STM32_C2_firmware.bin
Interface type 0
Setup Eth 0
Server started 0

ETH Started
Setup Wifi 0
Interface type 0
Setup Eth 1
Server started 0
Setup Wifi 1
[...]
```

It runs for some seconds and crashes again most probably on "Reconnecting MQTT". This device runs on WiFi.

I had the same problem yesterday evening. It may be an coincidence or not but it seems only to happen in the evening/night on this device - so perhaps it's related to some date/time code. If I'd have to name a time: I have discovered it around 22:00. But take this last paragraph with a big grain of salt.

Of course the status page goes nuts:

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

Looks like a severe case of memory corruption or an insane memory leak which reaches the stack after some seconds.

elektronikworkshop, 2023-02-28:
Just had another device doing this. It was even worse - it over drove my valves until they clicked (I'm an engineer myself and I don't like it if stuff gets tortured - arrrgh), so it seems that perhaps the STM32 crashes or is in a bad state as well. It exhibited the same symptoms on the status page as well. This device runs on WiFi too, but I'm not sure if that's a contributor... I'm just trying to collect data

SteffenB71, 2023-02-28:
Hello
Can also confirm that the 1.08 also leads to this strange behavior of the actuators for me. Back to 1.07 and everything works again.
Steffen

elektronikworkshop, 2023-02-28:
I had those crashes with 1.0.7 and  1.0.8.
I just discovered that one crash was so bad that it even popped one of the motors of its valve. So the STM32 must have been in a desolate state that it was deadlocked and not monitoring any current.

I will keep observing. I have three on ethernet and two on wifi. So a good test farm.

Lenti84, 2023-02-28:
Thats a weird behaviour... Hmmm

I remember problems with WiFi an MQTT in older versions. ESP32 crashed while trying to connect to the broker. Reason was around wifi setup command WiFi.mode(WIFI_MODE_STA); .
Can you narrow down, if it happens only on ETH or Wifi or on both equally?

I have my two controllers connected to mosquitto via ETH. Running fine with mostly latest software since 25d...

Status page looks very strange. But I have little idea why the STM32 drives the valve into end stops without stopping.
Normally STM32 controls valves independently from ESP32. But maybe it gets corrupted too.

There is a command, which sets the threshold of the current comparator for end stop detection and tehrefore motor stop. If this command is send unintentionally with wrong values STM32 will forcefully drive motor beyond end stops.

Or maybe STM32 gets busy by communication overhead on UART interface and cant stop due to overload. No idea if this can happen in reality. But valve motor control loop runs at same speed of communication loop.

Can you please try to use an older version of the software? 1.0.5 for example?

Software 1.0.8 has a changed reset mechanism, which leed to problems during development, but was fixed at the end. At least it seemed so. Flag -DforceHardReset in ESP32 source will switch behavior back to old STM32 reset handling.

There is also a debug interface. If you setup an SysLog server, you can log several messages of the ESP32 during runtime. I'm using visual syslog server 1.6.3 for example. Maybe this helps to collect more data.

elektronikworkshop, 2023-02-28:
Hi Lenti,

thanks for commenting on this issue. Such stuff happening in the field is like Murphy's birthday party.

Yeah, I'm currently waiting for more data. The two devices on which this happened are on WiFi. I had another device on ethernet with borderline behavior but I'm pretty confident that this was due to driving it with a to weak of a power supply and causing brown outs :) That's not possible with the two problematic ones which are powered by beefy upcycled router power supplies.

Yes, for some apocalyptic motor overdrive the STM has to be dead. No idea what caused it (some ideas though of course - you are pointing in the same direction). This shows that some kind of watchdog and/or high priority code would be a good idea. A mechanism which guarantees that the current monitoring never stops (ADC or timer interrupt with the interrupt priorities set correctly, so that it can't be choked by the UART for instance - in contrast to what would be the case in a traditional main loop) or at least cuts the power to the drivers in case some abnormal condition (e.g. when the watchdog barked) has been detected.

I will keep the 1.0.8 running to check if I can see a pattern. If it occurs again I will switch to ethernet and check if I can reproduce it on ethernet as well.

I have several projects running on WiFi connecting to MQTT brokers and providing telnet interfaces and more - on both ESP8266 and ESP32 and I never had problems with producing stack corruptions on MQTT (re-)connects. If I can reproduce a pattern which points to the networking code, I will audit it - if I'm not too busy. Same for syslogging...

Regards
EW

P.S. I have some other (hopefully good but for sure always constructive) ideas for VdMot, but I will address them in dedicated tickets.

Lenti84, 2023-02-28:
To help debugging I have extended the code a little.
- ESP32: added Uptime counter, this value is published via mqtt topic /common/uptime, maybe this helps to see when system crashes
- STM32: max read length for UART buffer is limited to 990 now, not unlimited anymore, can help against erroneous data floods
- STM32: valve_loop() is now called via timer interrupt, this hopefully ensures correct motor drive and stopping during high system loads

Please see: https://github.com/Lenti84/VdMot_Controller/commit/05eb9992e0b95821455918e9bf9bfc8b0c74547e
Also uploaded some binaries.

I will have a look at the other tickets a little later. But meanwhile thanks for your suggestions.

elektronikworkshop, 2023-02-28:
That's great, thanks!

And there can't be enough guard rails to keep the STM safe. I thought about it just some minutes ago: A huge load of commands can easily be produced by an ESP32 going bonkers by booting, crashing, booting, crashing, ... within seconds. During each boot the STM gets a bag load of queries which then quickly would overwhelm the MCU. I'm not familiar with the code base - so I don't know for instance if the ESP resets the STM on each boot or if the STM continues to run. Latter would render the theory more plausible though.

Don't worry about the other tickets - it's just to get them off my ToDo-lists and others can think about them and perhaps develop even better ideas.

elektronikworkshop, 2023-02-28:
Yet another thought: given the STM continues to run: this would confront the ESP after a crash-reboot with all the traffic generated by the STM - which could then end up in a vicious cycle. But again: this is based on a free running STM. Synchronous boot and reset is for sure preferable as it makes a complex system much more predictable and cuts millions of corner cases...

elektronikworkshop, 2023-03-01:
Tonight around 1:00am adds one more data point to night time crash list. The ESP didn't seem to have entered the crash-reboot-loop this time - at least I wasn't able to see it on the serial when I arrived at the crash site. The serial was completely silent but it was set up correctly despite the hurry because it later logged the brown out when I finally pulled the plug.

But before pulling it I tried something different: I reset the STM manually via the NRST button. This stopped the madness and the system seemed to have recovered. I unplugged it anyways for the sake of better sleep without worrying too much about my actuators.

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

And I have two more interesting samples:

#### 1)
This morning I found that two other devices crashed.

The interesting thing is: they crashed at around the same time (8:00 am). This could point to problems with some date/time/ntp code. There's nothing special happening at 8:00 am from my side AFAIK. The switch of the two wifi devices from "on" to "manual" happens at 8:00 pm and the other way round at 9:00 am (some minutes ago).

Both are on 1.0.8. _but one is on ethernet_ (!), and the other on wifi. So the data situation for the pure wifi theory gets thinner.

Both seemed to have recovered without entering the loop of death.

To keep stuff documented: On the ethernet devices I actively disabled the wifi in the configuration. The wifi devices are on "auto" (in case something goes horribly wrong and I have to bootstrap them via ethernet).

#### 2)
And a controller on ethernet with the combination of ESP@1.0.7 and STM@1.0.5_C2 seems to run since almost four days now. The strange firmware combination seems to stem from my flashing experiments a week ago when I had a 1.0.5_C2 lying around during the assembly for testing my DFU flashing setup. I forgot about it but discovered it this morning.

elektronikworkshop, 2023-03-01:
Oh, it's so annoying. Exactly at 22:00 one device crashed again. It's on 1.0.8, here's the output when it's in the loop of death - nothing new though.

```
pop gvers
pop gmotc
application setup start position finished
pop gtlnm
pop gonec 255
pop gvlon 255
pop gvlst
Reconnecting MQTT...

Stack smashing protect failure!

abort() was called at PC 0x400ef5d4 on core 1

Backtrace: 0x40082fe1:0x3ffb1fc0 0x4008d33d:0x3ffb1fe0 0x40091f8d:0x3ffb2000 0x400ef5d4:0x3ffb2080 0x400d91b5:0x3ffb20a0 0x400d950f:0x3ffb2150 0x4015855b:0x3ffb2170 0x400de261:0x3ffb2190 0x400d9982:0x3ffb21d0 0x400d7eb6:0x3ffb21f0 0x400d8336:0x3ffb2210 0x400deb9b:0x3ffb2230 0x400de8fa:0x3ffb2250 0x400d8d26:0x3ffb2270 0x400e8d61:0x3ffb2290

ELF file SHA256: 0000000000000000

Rebooting...
VdMot_Controller
Start Config
SPIFFS booted
get file : STM32_C2_firmware.bin
Interface type 0
Setup Eth 0
Server started 0

ETH Started
Setup Wifi 0
Interface type 0
Setup Eth 1
Server started 0
Setup Wifi 1
192.168.1.63
application setup finished
Start services
push gvers
push gmotc
push gtlnm
push gonec 255
push gvlon 255
push gvlst
pop gvers
pop gmotc
application setup start position finished
pop gtlnm
pop gonec 255
pop gvlon 255
pop gvlst
Reconnecting MQTT...

Stack smashing protect failure!

abort() was called at PC 0x400ef5d4 on core 1

Backtrace: 0x40082fe1:0x3ffb1fc0 0x4008d33d:0x3ffb1fe0 0x40091f8d:0x3ffb2000 0x400ef5d4:0x3ffb2080 0x400d91b5:0x3ffb20a0 0x400d950f:0x3ffb2150 0x4015855b:0x3ffb2170 0x400de261:0x3ffb2190 0x400d9982:0x3ffb21d0 0x400d7eb6:0x3ffb21f0 0x400d8336:0x3ffb2210 0x400deb9b:0x3ffb2230 0x400de8fa:0x3ffb2250 0x400d8d26:0x3ffb2270 0x400e8d61:0x3ffb2290

ELF file SHA256: 0000000000000000

Rebooting...
VdMot_Controller
Start Config
SPIFFS booted
get file : STM32_C2_firmware.bin
Interface type 0
Setup Eth 0
Server started 0

ETH Started
Setup Wifi 0
Interface type 0
Setup Eth 1
Server started 0
Setup Wifi 1
192.168.1.63
application setup finished
Start services
push gvers
push gmotc
push gtlnm
push gonec 255
push gvlon 255
push gvlst
Reconnecting MQTT...

Brownout detector was triggered

VdMot_Controller
Start Config
SPIFFS booted
get file : STM32_C2_firmware.bin
Interface type 0
Setup Eth 0
Server started 0

ETH Started
Setup Wifi 0
Interface type 0
Setup Eth 1
Server started 0
Setup Wifi 1
192.168.1.63
application setup finished
Start services
push gvers
push gmotc
push gtlnm
push gonec 255
push gvlon 255
push gvlst

abort() was called at PC 0x400ef6a5 on core 0

Backtrace: 0x40082fe1:0x3ffbe9cc |<-CORRUPTED

ELF file SHA256: 0000000000000000

Rebooting...
VdMot_Controller
Start Config
SPIFFS booted
get file : STM32_C2_firmware.bin
Interface type 0
Setup Eth 0
Server started 0
```
I'm not 100% sure if the brown out log corresponds to my un- and re-plugging the power because it was so annoying how VdMot tortured my actuators. Excuse me - I really had a bad day and this just gave me the rest.

But the timing of 8:00 and 22:00 can point to some MQTT subscription stuff. Because at 22:00 and 8:00 I switch to and from night time temperature reduction. I do that by adding the reduction to the temperature sensor data. I just logged it and this is what gets TXed:
```
indoor/ba2/og/plan-sura/temperature : msg.payload : number
19.810000000000002
```
The funny rounding is some artifact from Node-Red - I don't change it now because any MQTT client must be able to handle any message the broker delivers - even invalid data.

Perhaps this payload overflows a buffer in the subscription callback routine of `<blabla>/tValue`? Let's check...

### There we go:

My bet is on https://github.com/Lenti84/VdMot_Controller/blob/dcdbeada24d6e19d4e978b64fdf78c6a4e9407f2/software_esp32/src/mqtt.cpp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

You don't protect memcpy's target
https://github.com/Lenti84/VdMot_Controller/blob/dcdbeada24d6e19d4e978b64fdf78c6a4e9407f2/software_esp32/src/mqtt.cpp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
against arbitrarily long payloads. I refrain from commenting ... let's stay constructive :)

This is the poster boy of software security (and stability). It's perfect for corrupting not only the stack - It would be a piece of cake to inject and run code on the VdMot by using the tValue MQTT payload.

Ok, how to fix it? Apart from being so stingy with the `value` buffer size (I would at least give it 32, it's on the stack anyways so who cares?), I suggest something like the following (illustrative):

```c++
memcpy_s(value,
         sizeof(value) - 1,  // keep zero termination intact
         payload,
         length);
```
Or if you'd like to stick with `memcpy`:
```c++
memcpy(value,
       payload,
       std::min(sizeof(value) - 1, length));
```

Ok, get this comment out - I will edit if there's something to amend.

@SurfGargano owes something to me. At least 10 liters of beer:
https://github.com/Lenti84/VdMot_Controller/blame/544de769b9e40b6fc1b11078ff790ce9bc06b8cc/software_esp32/src/mqtt.cpp

And on top of that he has a homework assignment: someone should review the whole code base for buffer overrun flaws like this one. Search for use of similar style functions like `strcpy`: zero termination is never guaranteed, i.e. always use the ' safer' counterparts like `strncpy`  etc.. And educate yourself about safe coding... Ok, that's enough pedagogy - but after finding such an annoying bug I have a lot of pedagogy credits :)

elektronikworkshop, 2023-03-01:
I will provide a pull request tomorrow - I'd like to cash in the credits of this bug fix :)

This excludes the homework assignment of course.

elektronikworkshop, 2023-03-01:
The improvements and safeguards on the STM remain valid though. This bug perfectly highlighted the previously discussed shortcomings, which you @Lenti84 already addressed partly. I hope I don't have to remind you of race conditions when exchanging data between main loop and interrupt routines. Better safe than sorry...

elektronikworkshop, 2023-03-01:
https://github.com/Lenti84/VdMot_Controller/blob/dcdbeada24d6e19d4e978b64fdf78c6a4e9407f2/software_esp32/src/mqtt.cpp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

therefore

```c++
uint16_t beer_in_l_to_ew = 10;
beer_to_ew *= 2;
```

Lenti84, 2023-03-02:
Great finding!
Thanks for your contribution in finding and fixing.

I merged your pull request, but to the developer branch.

You can find the updated ESP binary under https://github.com/Lenti84/VdMot_Controller/blob/developer/releases/1.0.9_Dev/ESP32_firmware.bin
It is running at my system at the moment. Also MQTT reception works. At least for valid data.

Further shortcomings will be adressed in the next time.

elektronikworkshop, 2023-03-02:
You're welcome!

I just installed the 1.0.9_dev release and deployed some torture message generation:
```javascript
var ntr = flow.get("night_time_reduction");
if (ntr > 0) {
    var t = parseFloat(msg.payload) + ntr;
    msg.payload = t + 0.00000000007;
}
return msg;
```
aka
```
20.630000000069998
```
And the system is still running ... :relieved: ... It runs the STM 1.0.9_Dev_C2 as well.

I will close this issue as I'm pretty confident that the root cause of this particular symptom is fixed (i.e. the stack corruption). It's not said that there are other unbound copies or alike coming to haunt us in the future. Perhaps it makes sense to open a dedicated "homework" issue to keep this code review on the list. It could safe us from a lot of potential headaches ...

Closed 2023-03-02.

Thread 77 (2023-03-01):

Adjustment indexing with linked valves probably wrong

elektronikworkshop, 2023-03-01:
I just discovered a strange behaviour:

I wanted to lower the current opening percentage of tht valves. control is on, but the temperature is almost there but the valves were still at 50% because this device crashed (I learned though that manual entry doesn't affect the control loop though).

Valve 1 is the main valve, all others are linked (slaves).

When I set now set all the new values to 10, every valve except for 2 (the first slave) got set to the new value. This got me suspicious: When I now change only the first slave it affects the second slave.

There is no way to set the first slave. It looks like the indices are messed up when linked valves are involved.

I tried to capture it in two comprehensible screen shots:
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

SurfGargano, 2023-03-03:
I assume the Heat Control in the control page was not set to Manual ?
This is not the correct way to do this. If you want to set the valves manual, you have to set the Heat Control to manual first.

elektronikworkshop, 2023-03-03:
Hi!

I can not recall it, but usually I have them on manual and vdmot gets its state via MQTT.

If you as UI designer think that this is not allowed, than you should disable this UI option when vdmot is not in manual mode.

Regards
EW

Closed 2023-04-28.

Thread 91 (2023-07-31):

MQTT als JSON ?

TTr0n, 2023-07-31:
Die MQTT Werte, die an den Broker gesendet werden, kommen als reine String Werte an.
Wäre es möglich, eine Option hinzuzufügen, die die Daten als JSON Paket schickt?

LG

SurfGargano, 2023-08-05:
Nein, es sind ja meistens Einzelwerte. Da bringt JSON nichts.
Es ist aber möglich über das JSON-Interface Daten zu schicken oder abzufragen.

TTr0n, 2023-08-05:
Abfragen/Pollen wollte ich vermeiden. Ein Subscript auf das Interface ist wahrscheinlich nicht möglich, oder doch?
Reine Strings sind aber auch nicht so toll bei den MQTT Daten. Ich weiß nicht wie das im IO Broker funktioniert, aber die Einzelwerte als JSON formatiert (und nicht als String) sind mMn auf dem MQTT Server viel besser zu verarbeiten.

SurfGargano, 2023-08-05:
Hatte ich auch nicht vorgehabt. In iobroker , fhem und andere mqtt Broker wird dies als Einzelwerte verarbeitet und dabei bleibt es auch.

Closed 2023-08-05.

Thread 95 (2023-09-22):

Falsche Hardware / Software Zuordnung Ventile RJ45 Buchse

Alfons-Hetler, 2023-09-22:
Wenn man nur ein Stellantrieb auf 1 steckt wird dieser unter Stellantrieb 2 im Browser erkannt.

Hardwareport 1 ist Software Port 2.

V1 - No 2
V2 - No 1
V3 - No 4
V4 - No 3
V5 - No 6
V6 - No 5
V7 - No 8
V8 - No 7
V9 - No 10
V10 - No 9
V11 - No 12
V12 - No 11

Die Ports Zuordnung sind im allgemeinen etwas durcheinander.

Version 1.0.8 Beta und 1.2.2 DEV

Tritt bei beiden auf.

Lenti84, 2023-09-24:
Hi Alfons,

if you have D-H0044-01-05 hardware, please use C2 firmware file (STM32_C2_firmware.bin) for STM32.
Otherwise valves will be exchanged: 1<->2, 3<->4, 5<->6 and so on.

Kind regards

Alfons-Hetler, 2023-09-24:
Thats was my Problem. Thanks now it worked.

Closed 2023-09-24.

Thread 96 (2023-09-22):

Wrong Port speed in Manual/Pictures for flash ESP32

Alfons-Hetler, 2023-09-22:
For flash the ESP32 Board is a wrong speed in the online Manual.
That was the reason why i cant initial flash the Board.
Correct speed setting: 921600
I use a CH340 to flash.

Lenti84, 2023-09-24:
I think there is no right or wrong baudrate for the "flash download tool" as shown in https://github.com/Lenti84/VdMot_Controller/blob/master/assembly_kit/installation.md

I have already used successfully a lot of different baudrates, like:  230400, 460800, 576000 or 921600.

But my experience is also, that sometimes it will not work and after changing the baudrate it does.

Alfons-Hetler, 2023-09-24:
I try it too and it did not worked.
It says: Custom element doesn´t exist: plothy-graph.
I deleted the app and begin from new but the error stay there.

Closed 2023-09-24.

Thread 97 (2023-09-22):

No issue, Option turn off the LED's on the 2 Boards

Alfons-Hetler, 2023-09-22:
Can we add a Option to turn off the LED's in the 2 Boards. The blinking LED is really bad if you dont use the board in a Case.

Alfons-Hetler, 2023-11-12:
Ich schieb das nochmal nach oben ne ;-) Wenns nicht zu viel mühe macht wäre es schön wenn man das mal einarbeiten könnte.

SurfGargano, 2023-12-04:
Led's auf dem WTH sind fest verdrahtet und können nicht abgeschaltet werden. Auf dem STM ist das Blinken in der 1.3.2 geändert worden in ein Blitzen. 3s off / 100ms on

Closed 2023-12-04.

Thread 99 (2023-09-22):

No issue, Only Information: i become a new Board revision, the last is now D-H0044-01-05

Alfons-Hetler, 2023-09-22:
My Board D-H0044-01-05 shipped 20.09.2023.
What is the different to the old Board Design?

Lenti84, 2023-09-24:
D-H0044-01-05 has following changes:
- minor changes in the silk screen for better readabillity
- added reset circuit for ESP32, should improve rare startup problems of ESP32 depending on used power supply

Will add that later to the information in https://github.com/Lenti84/VdMot_Controller/blob/master/hardware/assembly_kit.md

Alfons-Hetler, 2023-09-24:
Thanks.

Closed 2023-09-24.

Thread 100 (2023-09-24):

Receive set temperature and ACTUAL temperature with mqtt - Soll-Temperatur und IST-Temperatur empfangen mit mqtt

zillawilli, 2023-09-24:
Hello togetherness

I have a questions please

Is it possible with the current software to receive the setpoint temperatures of each room via mqtt?
Also the ACTUAL temperatures?

I would install in each roomt an ESP32 as a thermostat which sends the set and actual temperature via mqtt to the software.

greetings
zillawilli

Hallo Miteinander

Ich habe bitte eine Frage

Ist es mit der momentanen Software möglich, die Soll-Temperaturen der einzelnen Räume über mqtt zu empfangen?
Ebenso die IST-Temperaturen?

Ich würde in jedem Raumt einen ESP32 als Thermostat einbauen welcher die Soll- und Ist-Temperatur per mqtt an die Software sendet.

schöne Grüße
zillawilli

SurfGargano, 2023-10-07:
Hi,
Du brauchst einen MQTT Server, der Dir dann alle Soll/Ist Werte sendet. Mehrere Mqtt Verbindungen sind nicht möglich.
Du kannst über JSON Interface mehrere Verbindungen gleichzeitig machen und die Soll / Ist Werte jedes einzelnen Raumes schicken. (also Connecten-Werte schicken-Verbindung schließen) Jedoch weiß ich nicht ob das System bei größerer Anzahl Verbindungen instabil wird.

Closed 2023-10-17.

Thread 103 (2023-10-12):

MQTT Retain ?

TTr0n, 2023-10-12:
Wäre es möglich, die Werte vom Controller als "Retain" zu senden oder zumindest die Option als Schalter zur Verfügung zu stellen?

SurfGargano, 2023-10-12:
OK, wird mit der nächsten Version enthalten sein, konfigurierbar.

TTr0n, 2023-10-12:
Danke, habs gerade eingespielt und werde berichten.
Ist die FW für den STM noch auf Stand 1.2.2 ? Denn da hat sich in der Anzeige nichts geänder, da steht immer noch 1.2.2 vom 09.08.

SurfGargano, 2023-10-12:
Stm 1.2.2 ist die aktuelle Version

TTr0n, 2023-11-01:
Sorry, hab vergessen eine Rückmeldung zu geben.
Sieht so aus, als wenn alles wie erwartet funktioniert!
Vielen Dank!

SurfGargano, 2023-11-01:
Frage : wofür brauchst Du das retain?

Closed 2023-11-01.

Thread 104 (2023-10-19):

Some questions, power usage, wires, KNX

shivan, 2023-10-19:
Since I did not find another way for contact.

1) What's the power consumption in "standby" so when no motor is moved?

2) Do you use all 4 wires of the VDMOT? I read something that two wires are for the motor and the other two can be used for better positioning?

3) Did you also think about a possibility to connect this to KNX? (currently I do not have LAN there, but KNX 😄  )

SurfGargano, 2023-10-21:
Power consumption is about 1.2 W in standby
Only 2 wires are used for the motor, since the motor has only 2 wires connected. I have extended 2 motors with a shielded KNX-cable by 10 m.
You can use Wifi , but the first (Wifi) installation has to be done by cable.

KNX : Andreas will answer.

Lenti84, 2023-10-25:
I am thinking of a KNX Support for a longer time...

I just created a poll / discussion to find out how interessted the community is:
https://github.com/Lenti84/VdMot_Controller/discussions/108

Thread 105 (2023-10-20):

Dev 1.23 no tTarget (MQTT) information on Status Site

Alfons-Hetler, 2023-10-20:
After Update to DEV 1.2.3 i cant see the MQTT Values (tTarget, tValue) on Status Site on DEV 1.2.2 i see without issues.

Alfons-Hetler, 2023-10-20:
We can close it. The problem was the Settings on the Valves (Control Site). Was on Manual after update. I put it back to On/Heating then i see the Values (tTarget, tValue) on Statuspage.

Closed 2023-10-20.

Thread 109 (2023-10-27):

Fensterkontakt per mqtt

Alfons-Hetler, 2023-10-27:
Ein Externer Fensterkontakt per Mqtt der den controller direkt anspricht um das Ventil zuzufahren wäre toll.

Derzeit mache ich es über einen Fensterkontakt der dann das stellsignal auf 0 grad setzt.
Geht, aber nicht schön aufgrund der eingestellten Verzögerung.

Fenster auf: Zwangstellung Ventil 0%, sowie blocken neuer Tempwerte (auch über mqtt)
Fenster zu: Optionen: alten Wert wieder annehnen oder aus bleiben und manuell wieder einschalten.
Wenn man die 2 Optionen wählen könnten wäre das top.

SurfGargano, 2023-10-27:
Zum Testen auf : https://github.com/SurfGargano/VdMot_Controller/tree/developer/releases/1.2.4_Dev
Es werden 2 Mqtt Objekte unter window angelegt :
state : 0 = Fenter geschlossen, 1 = Fenster offen
target : Ventilstellung bei geöffnetem Fenster.
Bei Fenster öffnen wird das Ventil sofort auf den Wert gesetzt, bei Fenster schließen erst mit Aufruf des nächsten Zyklus ( abhängig von Ts)

Closed 2023-11-08.

Thread 110 (2023-11-09):

Uptime Topic MQTT not send or only 1 time at startup

Alfons-Hetler, 2023-11-09:
Uptime wird nicht per MQTT gesendet oder in Abständen die ich nicht nachvollziehen kann.
Am Anfang wird es einmal gesendet dann nicht mehr aktualisiert.

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

SurfGargano, 2023-11-10:
Solved with V1.3.0

Closed 2023-11-10.

Thread 113 (2023-11-12):

[1.3.0_Dev] MQTT tTarget only read after boot?

ei-ke, 2023-11-12:
Moin zusammen,

I recently upgraded from 1.0.7_Beta via 1.2.2_Dev to 1.3.0_Dev.
Not sure when on the way it happened or if I'm the only one affected, but changing tTarget via MQTT after the valve calibration run that happens after booting the device has finished (maybe even earlier) seems not do be noticed by the device.

I can clearly see the changed tTarget (coming from Home Assistant) on my broker but the controller just ignores it. If I'm rebooting if from the webinterface the new tTarget is picked up correctly.

From 18:31:00 to 18:34:00 tTarget for "Bad" should have been 19.0 and not 18.5.

Kindly let me know if you need further informations.

PS: I also tried different `Interval (ms)` and `Publish Interval (s)` values without any success.
Eike

<details>
<summary>
Screenshots and atomic syslog
</summary>

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
[syslog.txt](https://github.com/Lenti84/VdMot_Controller/files/13328740/syslog.txt)

</details>

SurfGargano, 2023-11-12:
The interval (10000  ms) is too long. Recommended and also default is 1000. This interval is the time the controller looks for new incoming data and for possible sending data. You can activate publish on changing to reduce traffic.  (In this case you can set publish interval to 60) For home assistance.
 you should also set separate topics. Pls see the Wiki /mqtt for documentation

ei-ke, 2023-11-12:
Thank you for the hint. Setting the interval to 1000ms fixed the issue. Not sure when I made this mistake.
I'll have a look at the "separate topics" settings tomorrow.

Alfons-Hetler, 2023-11-12:
Komm mal im Telegram Chat dann können wir mal schauen was das Problem ist. Bei mir gehts ohne probleme.

Closed 2023-11-12.

Thread 123 (2024-03-23):

minor observations with 1.3.6 version

harvey637, 2024-03-23:
Hi,
after a problem (blocked valve) I updated to dev_1.3.6 from 10.03.2024 10:11

My system is C3 (no relay) board, 0x423 STM32F401xB/C so I used the C2 variant and the 1.3.6_Dev/STM32_C2_firmware.bin variant.

Reboot, ok

I noticed a small square in the "status" page tab header, possibly intended as a quick ok/error/calibrating Flag?
Inside the status page there is a "gray_window" icon next to each state, will it change? Nothing ever happened to this icon :-)
Is this a preparation for a future windows opened/closed connection? Remember that some logic is inverted with cooling :-)
... found a  switch in the control window .... ok (did not check what will happen than ...)

The "next calibration movements" count in the config page seems to jump with every reboot??? Or only after first reboot - variable initialisation?

very positiv: my bookmark now jumps directly into the status page (perfect without login)

Future wish: use standard date/time formats eg "2024-03-23 23:59:00" IMHO weekday is not soooo important, datetime in one line ....

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

now waiting for calibration ....
cu
Harvey

harvey637, 2024-03-24:
some more feedback:
status icon: with error ther is an red error mark, thats good!
without error: no icon, just the square, where the icon should be :-(

Calibration: when will an automatic calibration start after reboot?
Manual calibration: status show "calibration" for some time, but nothing happens. After some time it goes back to "connected",
no open/close/idle or movment to calculated position (in the next 30 minutes or so ....

cu
Harvey

harvey637, 2024-03-30:
thank you for the calibration info!

some more ideas: after some findings in my graphs (no response to api call) I found out the mqqt status: WDT, which sounds like WatchdogTimer. Sadly no local log an no Info on the reason ...
In the GUI there is not hint about this.
Maybe it is an idea to put the last status in the detailed "status" page, on the right, below calibration?

Some thought on documentation: I guess, the "hour time" in calibration means to recalibrate after xxxx hours? hours=0 to ignore? Is hours a good scale to calibration, better as "days"? ... just thinking ....
cu
Harvey

SurfGargano, 2024-03-30:
hour time means time of the day. If you enter 0 , the calibration starts at midnight of the activated day.

If you set the interval to 60000 ms, the VDMot Controller checks every 60 sec if there are new values on mqtt. This will result in a long time response.
With keep_alive 45 seconds the connection will be closed aftrer 45 seconds after the last transmit, thats why after 2 minutes a reconnect occurs.

Set the  interval to a smaller value ( I have 1000ms, results in a faster repsonse)  and the keep_alive to a greater one. ( I have set to 120 seconds)

best regards Werner

harvey637, 2024-03-31:
Hi SurfGargano
thank you for the answers, I am happy with the interval/keep_alive settings now, ok!

Calibration timing on the homematicIP happend immedeately after reboot, so it was better predictable. (power off, power on, watch for the valves to move for calibration).
With vdmot if I am in front of the valves I have not idea, when the first move will initiate the calibration. But this is my minor problem, may be I have to solve it with browser on vdmit on my mobile :-)))

The info about "hour_time" is ok, but in contrast to the wiki. it says:
h - After choosen hours, all valves are newly calibrated by the controller.
Days - Choose the days, when all valves should be newly calibrated by the controller. Calibration happens at midnight.

Maybe a refresh on that info clarifies settings :-) I guess that hour_time is calibration time for every selected day ....

by the way.....
- how to reset counters (without full reset ...)?
- think about showing the "cr" (calibration retrys?), the "link" and the "controlactive" flags for each valve in extended status?

Now this is only in the json api-call...

happy easter!
cu
Harvey

Closed 2024-08-06.

Thread 129 (2024-10-24):

Aktuelle IP Adresse bitte in MQTT mit aufnehmen

P7aM5qzEddT66lE, 2024-10-24:
Aktuell wird die IP Adresse nicht per MQTT versendet.
Eine Übertragung hätte Vorteile in der Überwachung, ob der entsprechende VdMot.Controller noch am Netz ist und in der Wartung des selbigen.

Danke im voraus,
Günter

SurfGargano, 2024-10-27:
Implemented in 1.4.4

Closed 2024-10-27.

Thread 130 (2024-11-01):

STM32 cannot be flashed !

valig80, 2024-11-01:
Hello,

I am creating this post for asking help regarding the flashing of the STM32 Black Pile.

Today I soldered all the components on a VDMOT board (Revision C3) and as peer software installation instructions I managed to flash the WT32. Then from the GUI I tried to flash the STM32 with latest firmare version 1.4.2 (C2) but I always get an error...

For flashing the STM32 I have the X20 jumper set, and I am keeping the BOOT switch pressed. I get initially the message "STM32 is updating and while keeping BOOT pressed the progress goes till 10% and thereafter it shows Error
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

Since this is my second controlled I tried also following, I've inserted the STM32 into my first controller which is working perfectly, and I tried to flash the STM32 through its GUI.  Also, there the flashing process is the same, it ends with Error.

Are there any possibilities to push the firmware intro the STM32 (through the usb-c or via USB-Serial to PINs) ?
Or since the Chip ID is shown always with 0x0 can it be that the STM32 is faulty (the LEDs, switches are working normally)  ?

Thank you in advance for a fast answer.
Val

SurfGargano, 2024-11-01:
Do you get the Stm32 from Andreas or buy it by your own?

valig80, 2024-11-01:
> Do you got the Stm32 from Andreas or buy it by your own?

I bought the entire assembly kit from Andreas

SurfGargano, 2024-11-01:
It seems that the stm is defective. There are some not functional clones on the market.
https://hackaday.com/2020/10/22/stm32-clones-the-good-the-bad-and-the-ugly/

SurfGargano, 2024-11-01:
Btw, you can try 1.4.3 (wth) . With boot0 flashing the stm  it reduces the baudrate, if an error occurs.

Lenti84, 2024-11-02:
Hi together,
latest orders were shipped with preprogrammed stm32 boards. Programming of board was done via STLink utility. Programmed version ist 1.4.4 as written on the antistatic plastic bag.

Does the LED of your board flashes?
Does it run in standanlone mode via USB cable?

Kind regards
Andreas

valig80, 2024-11-02:
Hi Andreas

Sorry, I did not read what was on the plastic bag and therefore I didn't realize that the STM32 is preprogrammed.

When I connect the STM32 through the USB-C on my connector, I get the red LED (Power) on all the time and the blue LED (C13) flashing fast initially and after 7 seconds it blinks slowly at every 3 seconds.

If the STM32 is plugged in the VdMot controller, I get both LEDs blinking as described above and on the GUI I see following:

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

Today I will get another STM32 chip and an ST-LINK programmer. I plan on doing the following:
1) insert the new STM32 chip in the VdMot controller and try to flash it from GUI
2) Try to flash the old STM32 chip somehow with the ST-Link, but here I don't have the knowledge yet as I only played before with ESP32s

best regards,
Valeriu

valig80, 2024-11-03:
Hello

I am posting some updates. Today I received by Amazon another STM32 and an ST-Link programmer.

Unfortunately, I did not have any luck on making the second VdMot controller to recognize  STM-32 chip.
I tried following:

1) Check if the VdMot controler nr2 (#2) recognizes the STM32 chip from the VdMot nr1 (#1)
Since I have two VdMot controllers, I swapped the STM32 from VdMot #1 into VdMot #2 and the VdMot #2 reconizes the STM32 (#1). Therefore at this point, I assume that the new soldered VdMot #2 controller is not faulty

2) Tried to flash the STM32#2 into VdMot#1, it fails also exactly like when flashing with VdMot#2

3) Inserted the new received STM32 (#3) from Amazon into VdMot#2 and tried to flash it.
The flashing in Boot partition works and the GUI shows the Chip ID but after verification and 100% completion the STM32 remains only with the power LED on and it is not recognized in the GUI. Flashing it again in Normal partition fails

4) Flash of STM32 #2 and STM32 #3 with ST-Link utility
With ST-Link I am able to read both STM32 chips and I am also able to program them. However, when I am inserting the STM32 chips in the VdMot #2 both chips are not recognized in the GUI

5) I flashed different version of software also on WT32 and also on STM32
I tried with version 1.3.7 and also with 1.4.3. BTW Andeas you mentioned that the STM32 was preprogrammed with 1.4.4, where can I find this version ?

At this point I am out of ideas, what else can I try?

valig80, 2024-11-08:
Hello

I managed to solve the issue with the STM32 and now the VdMot controller is fully functional. :)

During the several programming attempts through the controller itself and also through the ST-Link I observed that the unrecognized STM chips were of this type: STM32F401xB/C.
The STM32 chip from the functional controller was an STM32F401xD/E, and therefore I ordered again another STM32 chip from Amazon but this time from another supplier (AZ Delivery)

It arrived, I flashed the firmware_c2 through the ST-Link utility and after plugging the STM in the controller board everything worked perfectly.

Therefore, I assume that only the STM32F401xD/E chips are at the moment usable with the controller.

ralf-e, 2024-11-20:
Hello,

could this be a memory problem?
What is the minimum memory size required for the STM32F01 by VdMot?

STM32F401CEx: 512k Flash and 96k RAM,
xx401CDx: 384k/96k
xx401CCx: 256k/64k
xx401CBx: 128k/64k

SurfGargano, 2024-11-21:
No, the required ram/rom is
RAM:   [=         ]   7.5% (used 4908 bytes from 65536 bytes)
Flash: [==        ]  20.5% (used 53776 bytes from 262144 bytes)

Closed 2024-11-08.

Thread 132 (2024-11-11):

Two ports not working

padarom, 2024-11-11:
I recently ordered and assembled two kits which I intended to use with 11 valves each. The first kit went smoothly, the second one showed me some strange behavior when trying to install and set up all the valves.

Took me a while to isolate the issue, but it turns out that:
- When connecting any valve to X3, the controller thinks all other valves are blocked. The web interface slowly changes all their states to "blocked", even though a second ago they were still functioning
- Same behavior for X4
- Also for X4: When scanning for valves, it shows X2 as connected, even if X4 is the only valve connected to the controller. When only connecting a valve to X2 it operates correctly.

For now I am running it with X3 and X4 disconnected, but I'm wondering about what caused this. Is it somehow obvious if this is a PCB/BluePill/... issue, or does this not make sense for anyone else either? I rechecked all my solder spots to see if I didn't inadvertently connect two pins but they all look fine to me. I also resoldered the connectors for X3 and X4 but the issue persisted.

Thanks for any help or hints!

SurfGargano, 2024-11-11:
pls show a screenshot of Home and Config.

padarom, 2024-11-12:
What I just realized when comparing this controller with the working one: The working one uses version the STM32 firmware version `1.4.0_Dev_C2 build 21.08.2024`. I'm quite sure the faulty one would've had the same version, but I wanted to see if a firmware re-flash would fix the issue and the newest one I could find in the repo was 1.3.7.

Here's the screenshots you asked for:

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

SurfGargano, 2024-11-12:
The config looks fine.
The latest firmware is on my github :
https://github.com/SurfGargano/VdMot_Controller/releases/latest

Funkenschuhster, 2024-12-21:
Had the same issue. Flashing no success. I bought some new from AZ Delivery. It is working fine now.

faerber93, 2025-01-11:
@Funkenschuhster , can you please post a link for the stm32 that you orderd?
I also bought some STM32 modules from AZDelivery (via Amazon) because ports 1 and 2 both seem to control port 1. With the new STM32 modules, ports 1 and 2 work correctly, but the EMF does not function – the motor doesn’t stop and ends up skipping the gears.
I will test the other STM32 modules from AZDelivery later.

Funkenschuhster, 2025-01-13:
I used these:
AZDelivery 3 x STM32F401 Development Board V 3.0 STM32F401CCU6 STM32F4 Development Board 84MHz 64KB SRAM 256KB https://amzn.eu/d/2I6qkih

Check the current factors. If you reset the controllers during startup, the factor may changed to 3.7

Thread 133 (2024-11-28):

External MQTT room sensor

Funkenschuhster, 2024-11-28:
Just ordered two boards to exchange my existing room control. Is there a possibility to add non wired temperature sensors? Sometimes I have an issue with sun radiation heating up my wall thermostat, so I started using battery powered SNZB-02D (display) or SNZB-02 (no display). The sensors are integrated by homeassistant and i like to send the value by MQTT.

Funkenschuhster, 2024-11-28:
Wrong platform for a discussion, sorry.

Closed 2024-11-28.

Thread 136 (2024-12-21):

WT32 Network cannot be changed without STM32 attached.

Funkenschuhster, 2024-12-21:
Case:
Without STM32 connection, it is not possible to save any settings.

Problem:
In case the WT32 is messed up, router, ethernet cable, programmer, laptop has to be arranged in front of the controller to flash/configure.

Recommendation:
Extra save button for network settings.

SurfGargano, 2024-12-28:
Fixed in V1.4.7

Closed 2024-12-28.

Thread 137 (2024-12-21):

Remanence for valve posisition

Funkenschuhster, 2024-12-21:
Case:
In case the controller is reset, all valves start at the same preset level. Then the control will take over.

Problem:
My floor heating takes hours to reset to normal temperature. The comfort of the rooms is disordered for quite some time.

Recommendation:
Add remanence for valve position. After reset, the valve will go to last known position.
Or: Add option to set individual start position for each valve.

SurfGargano, 2024-12-28:
Last position is not possible,  too many write operations to the flash will damage it.

SurfGargano, 2024-12-28:
Closed

Funkenschuhster, 2024-12-31:
What about storing the remanence in the MQTT?

Closed 2024-12-28.

Thread 138 (2024-12-21):

Valve manual override

Funkenschuhster, 2024-12-21:
With my industrial background, I miss one function:

Case:
1. Set a control loop to manual.
2. Change valve manually to some position
3. Set the control loop to automatic.
--> The valve will move to last automatic control position

Suggestion:
If a control loop is in manual mode, the valve can be adjusted.
When the control loop is set to automatic, it will start control from the actual valve position.
--> smooth transition.

SurfGargano, 2024-12-28:
Not possible in control logic.

SurfGargano, 2024-12-28:
Closef

Closed 2024-12-28.
