Lenti84/VdMot_Controller/hardware/schematic_c4-sample_V02.pdf

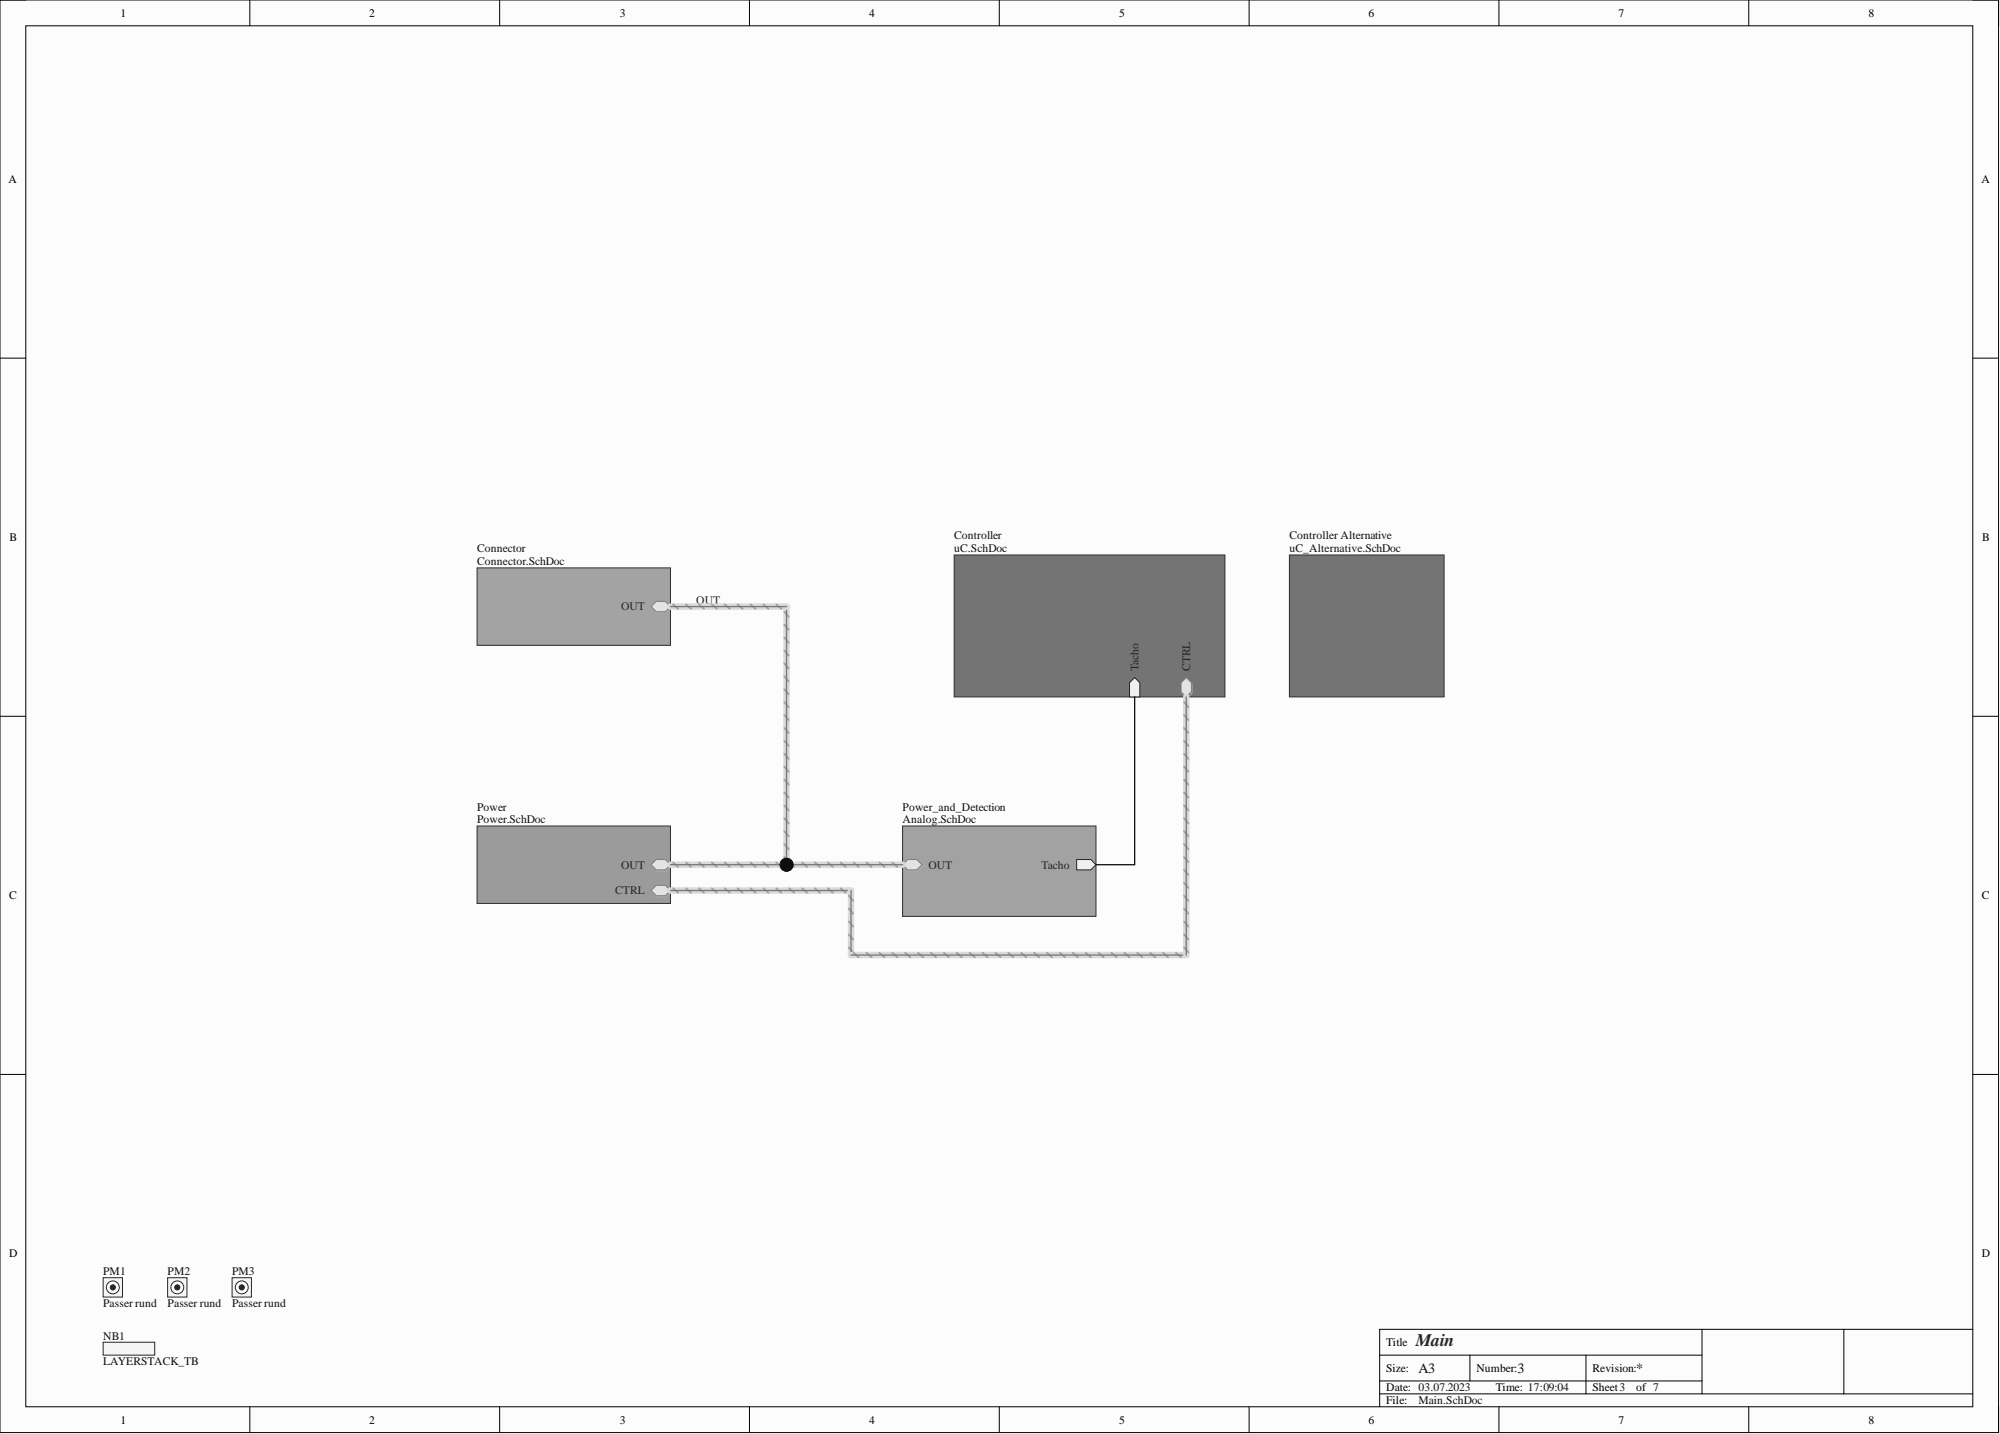
[picture p34: page 1]

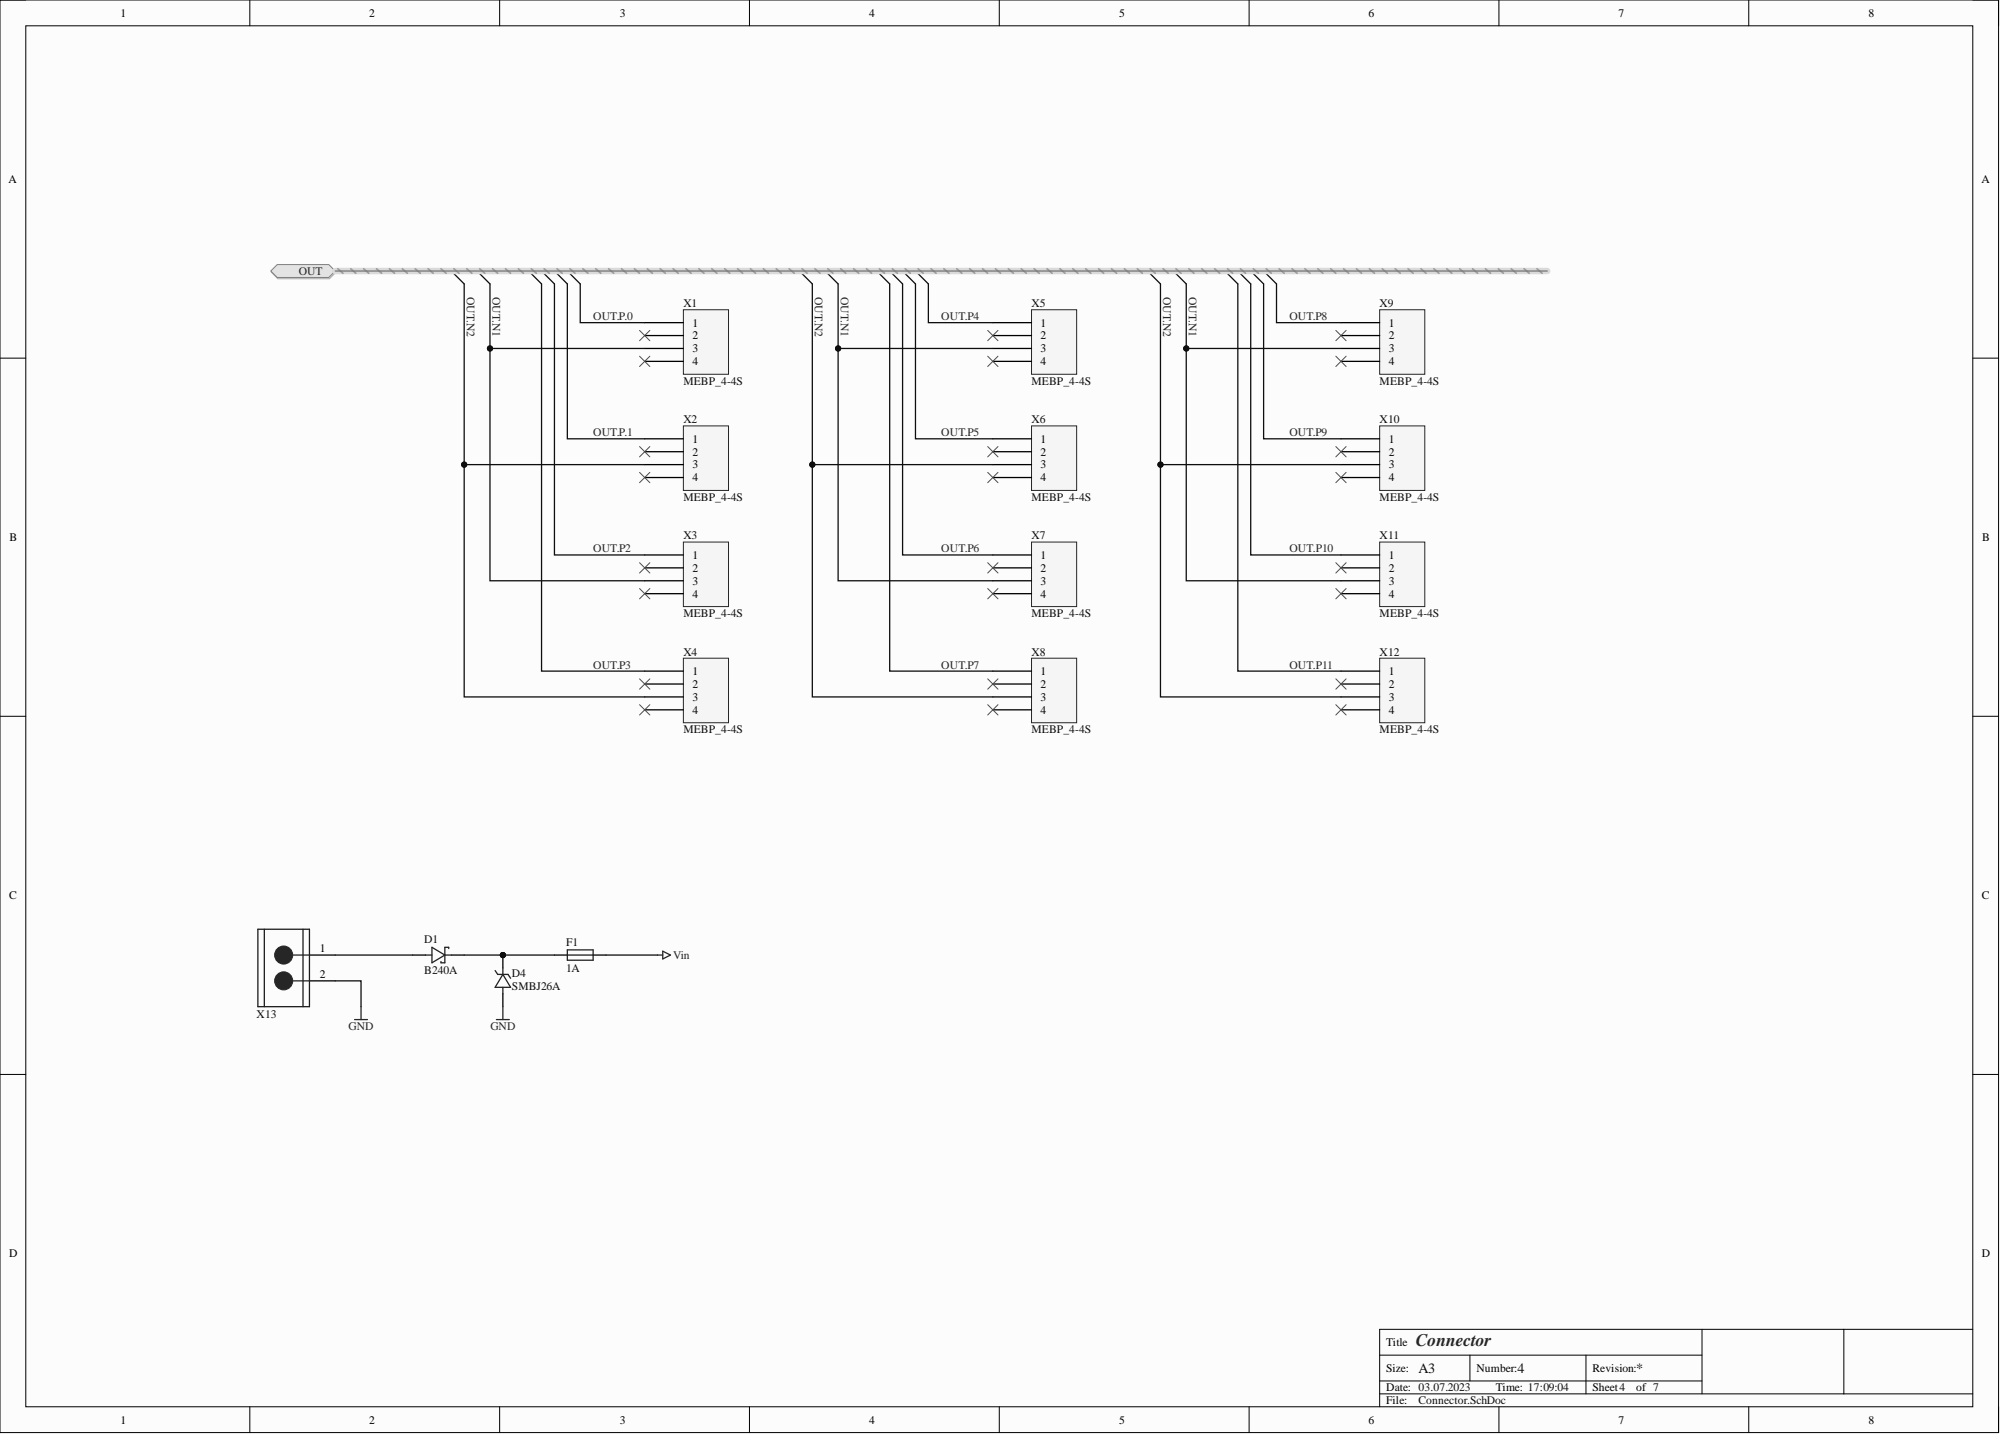
[picture p35: page 2]

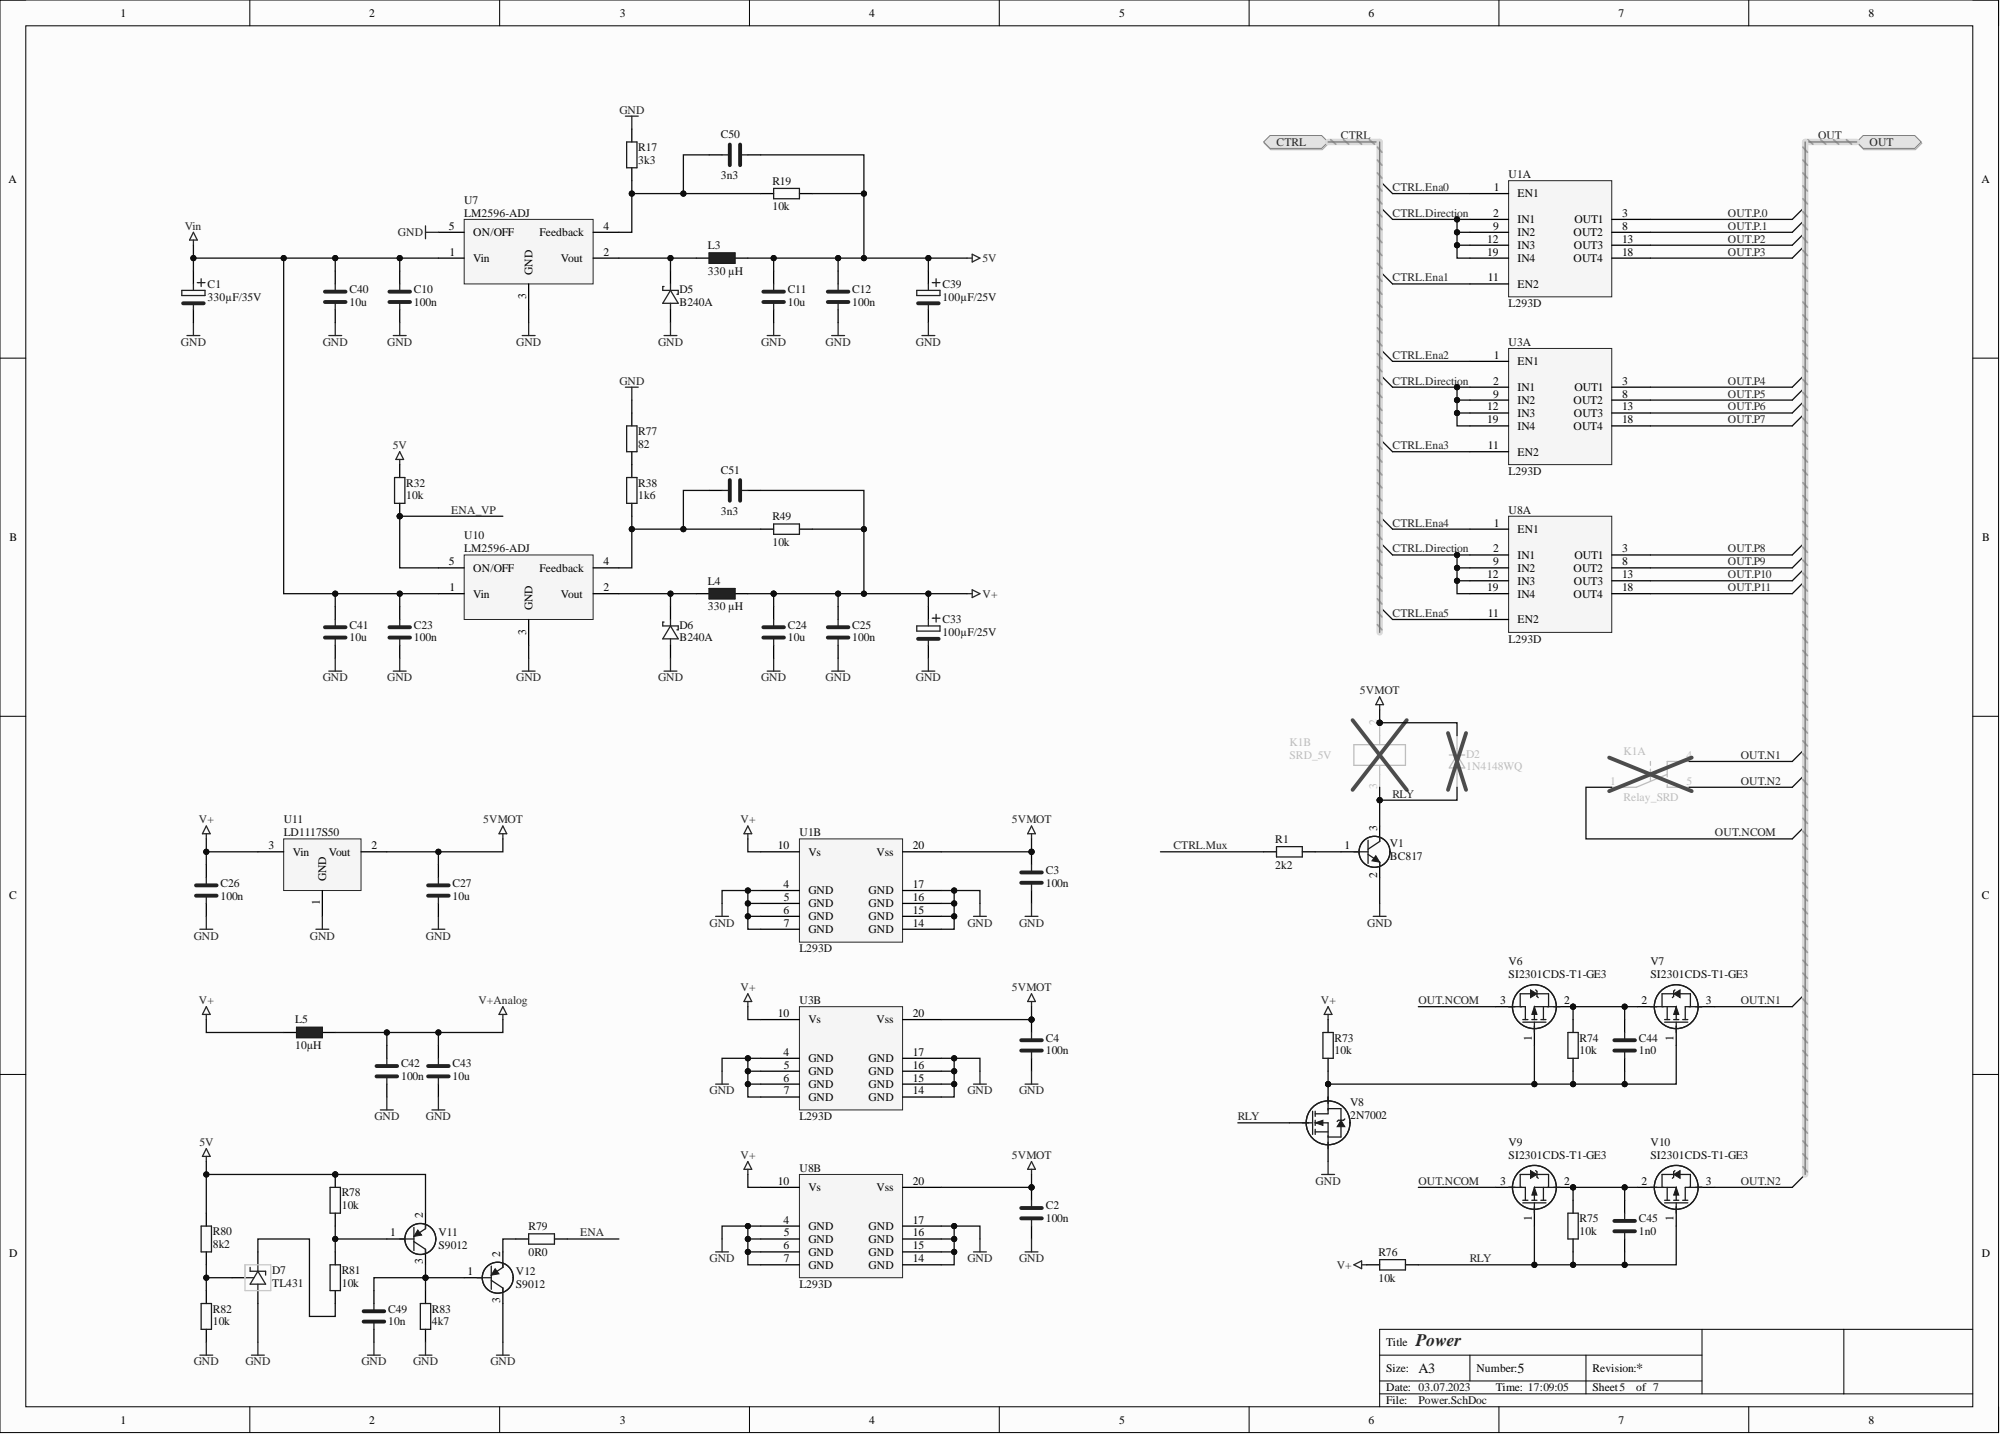
[picture p36: page 3]

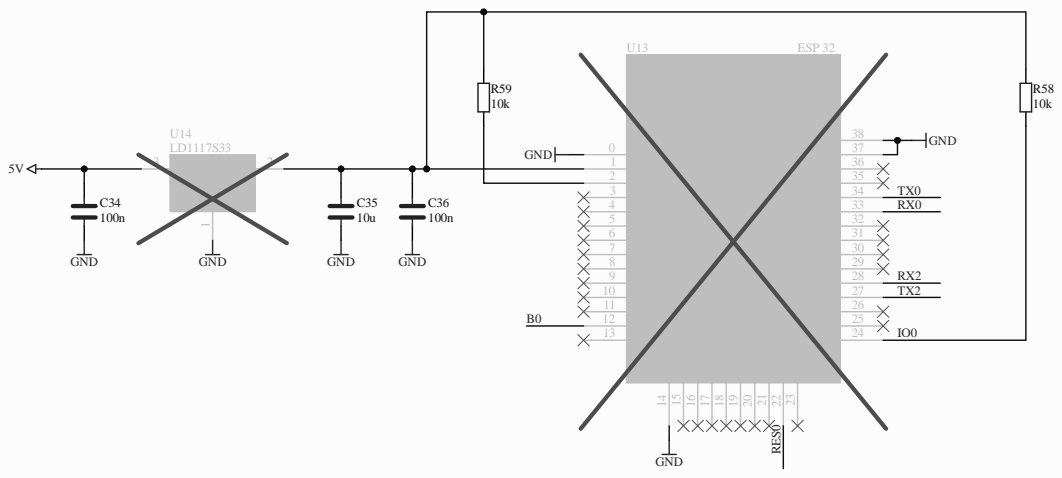
[picture p37: page 4]

U 1 3 ESP 3 2

G N 3 V
2 | E N SE NSOR_ V P SE NSOR_ V N IO 3 4 IO 3 5 IO 3 2 IO 3 3 IO 2 5 IO 2 6 IO 2 7 IO 1 4 IO 1 2 IO 0 | T X 0 RX 0 RX 2 T X 2 IO 0

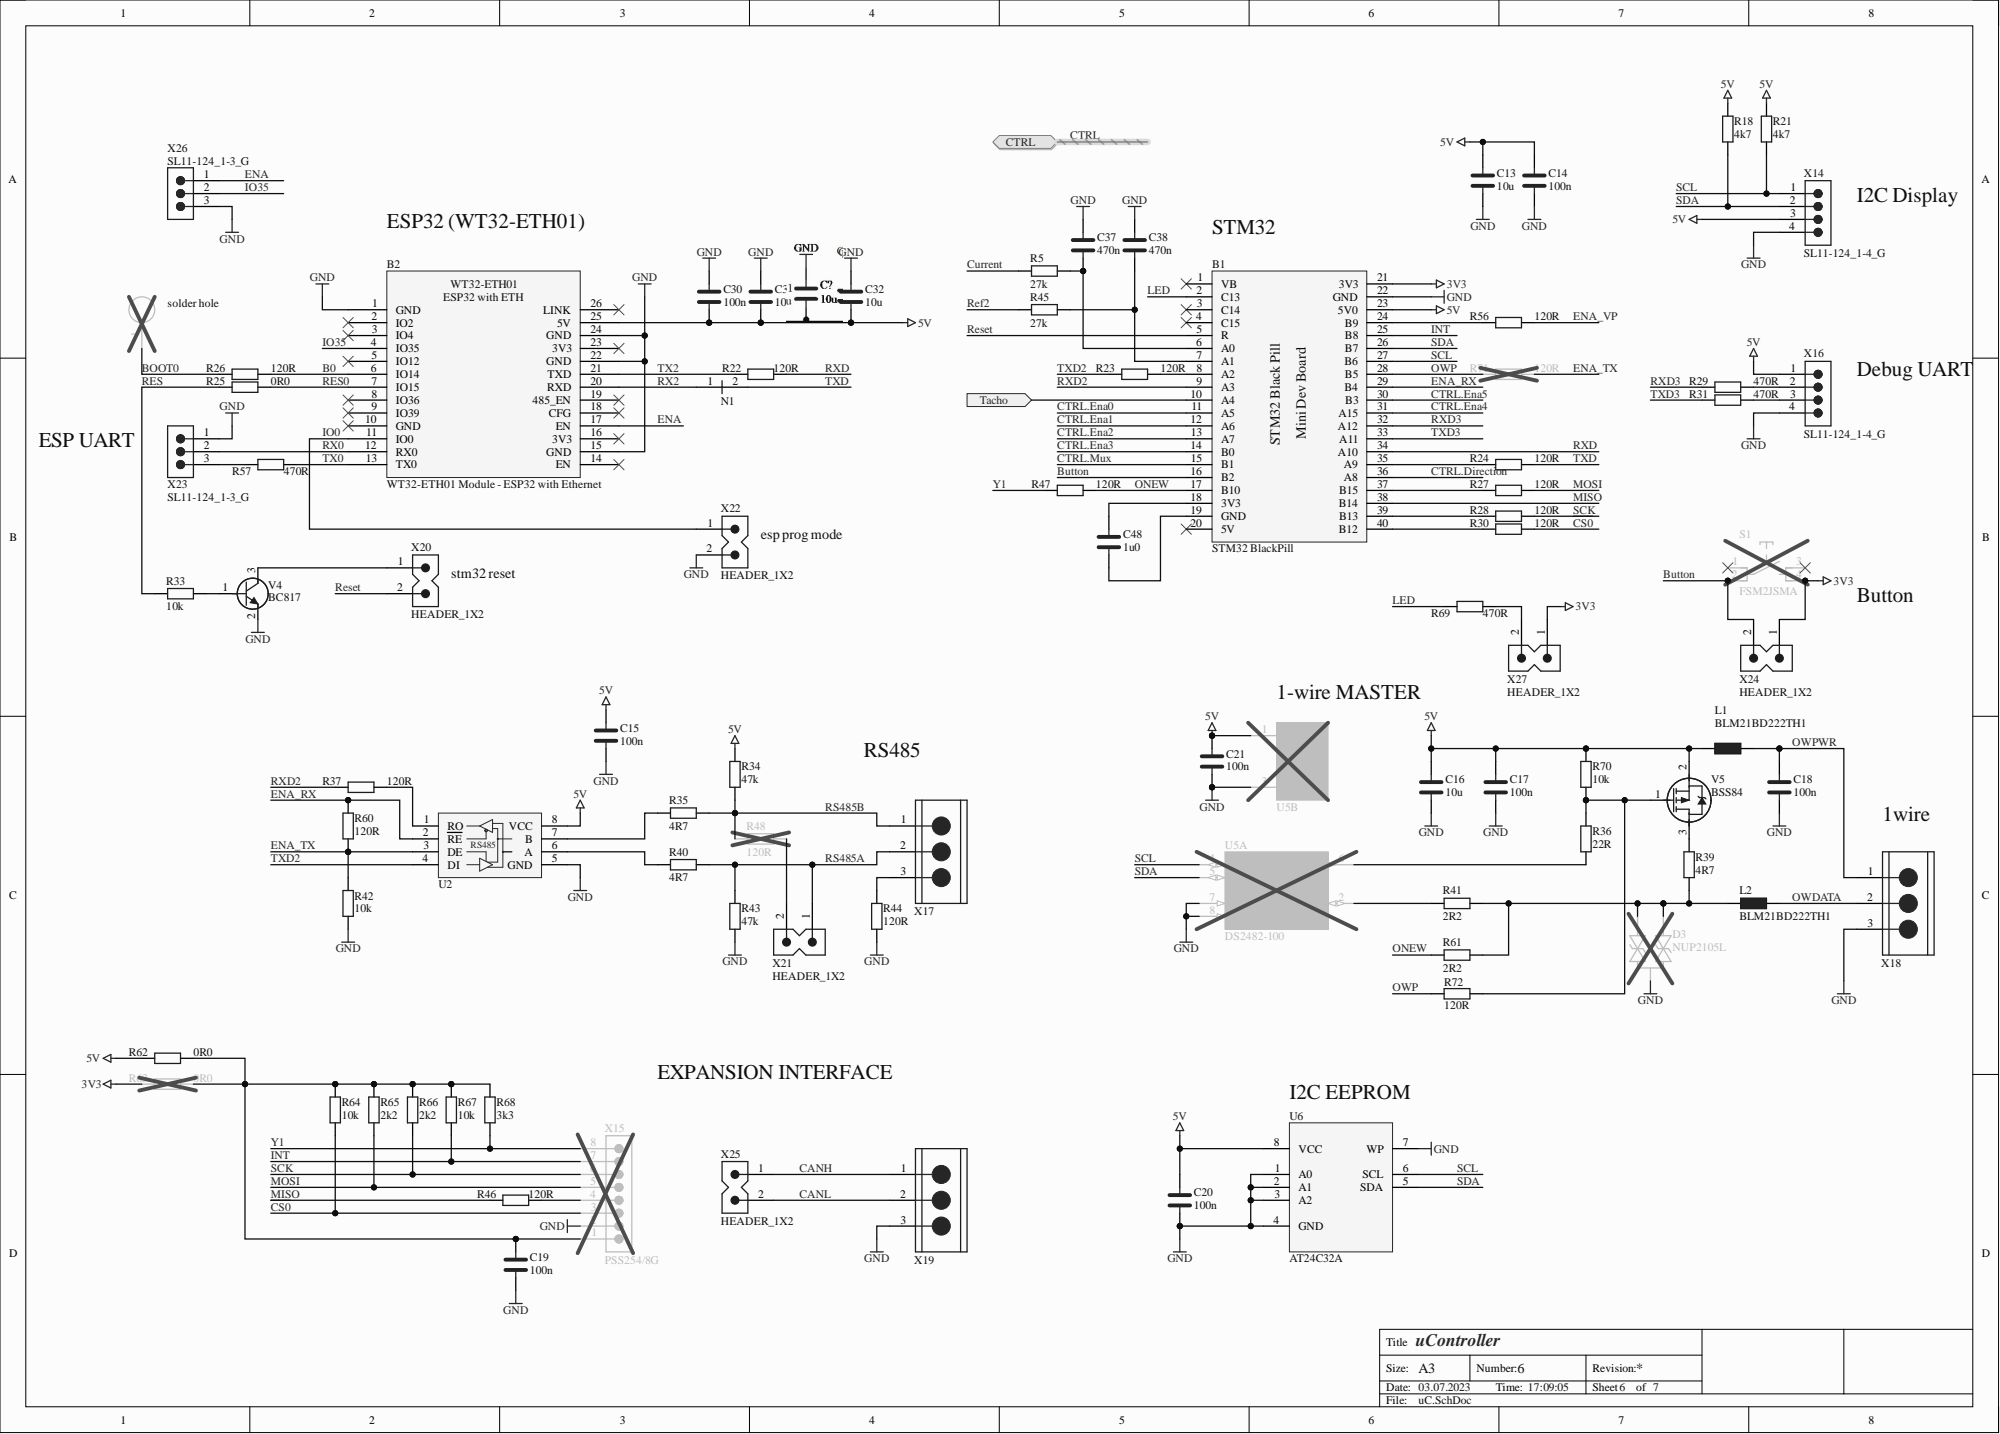
[picture p38: page 5]

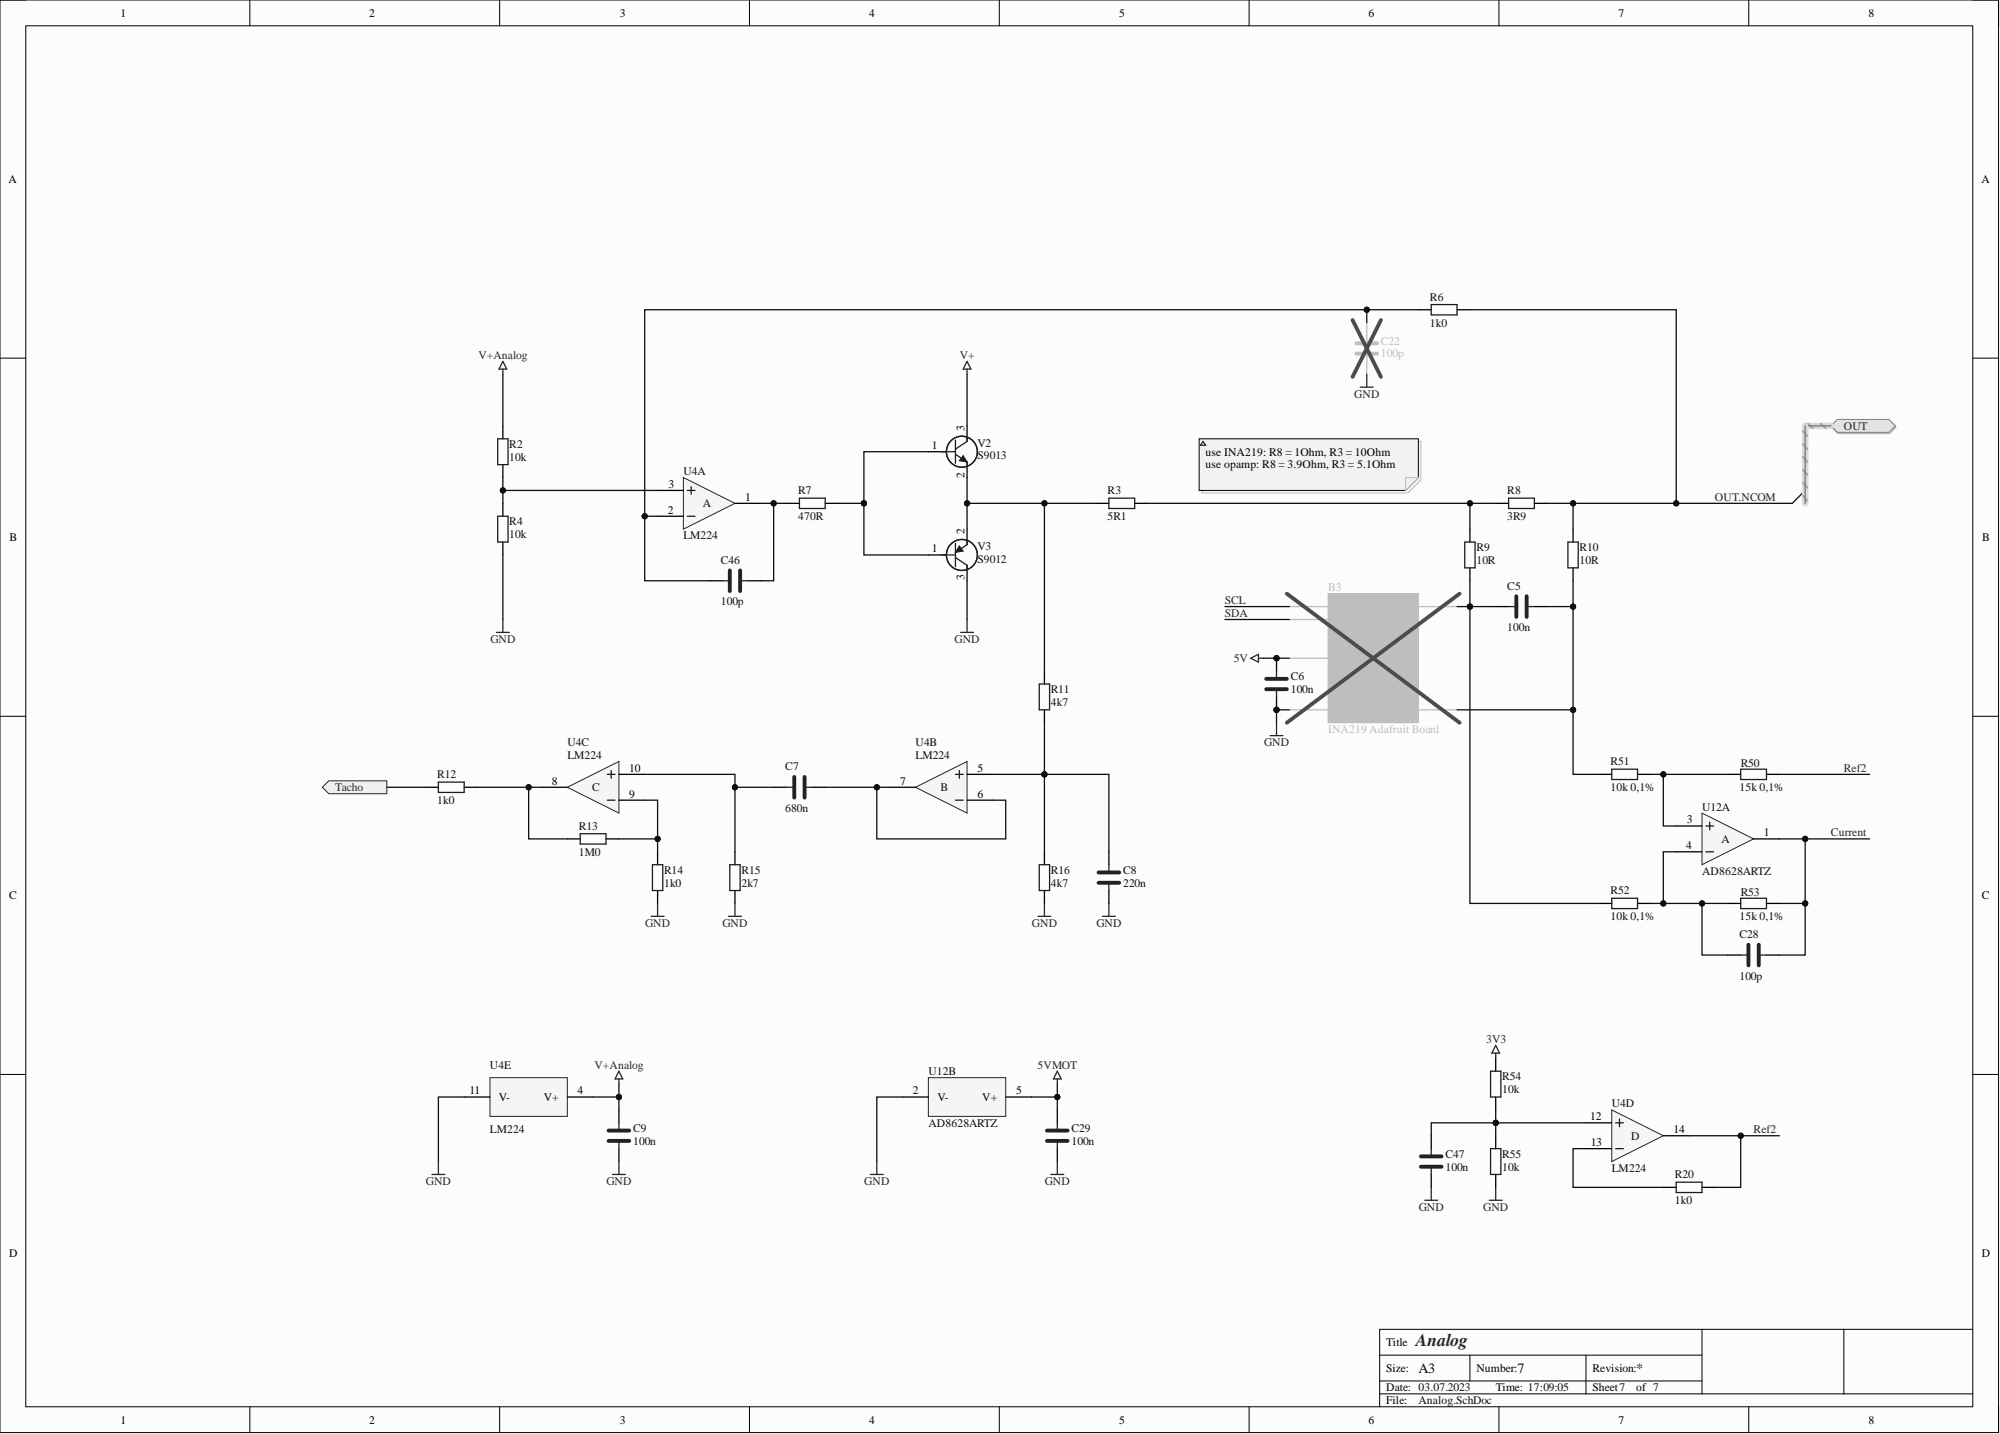
[picture p39: page 6]
