Lenti84/VdMot_Controller/hardware/schematic_c-sample_V02.pdf

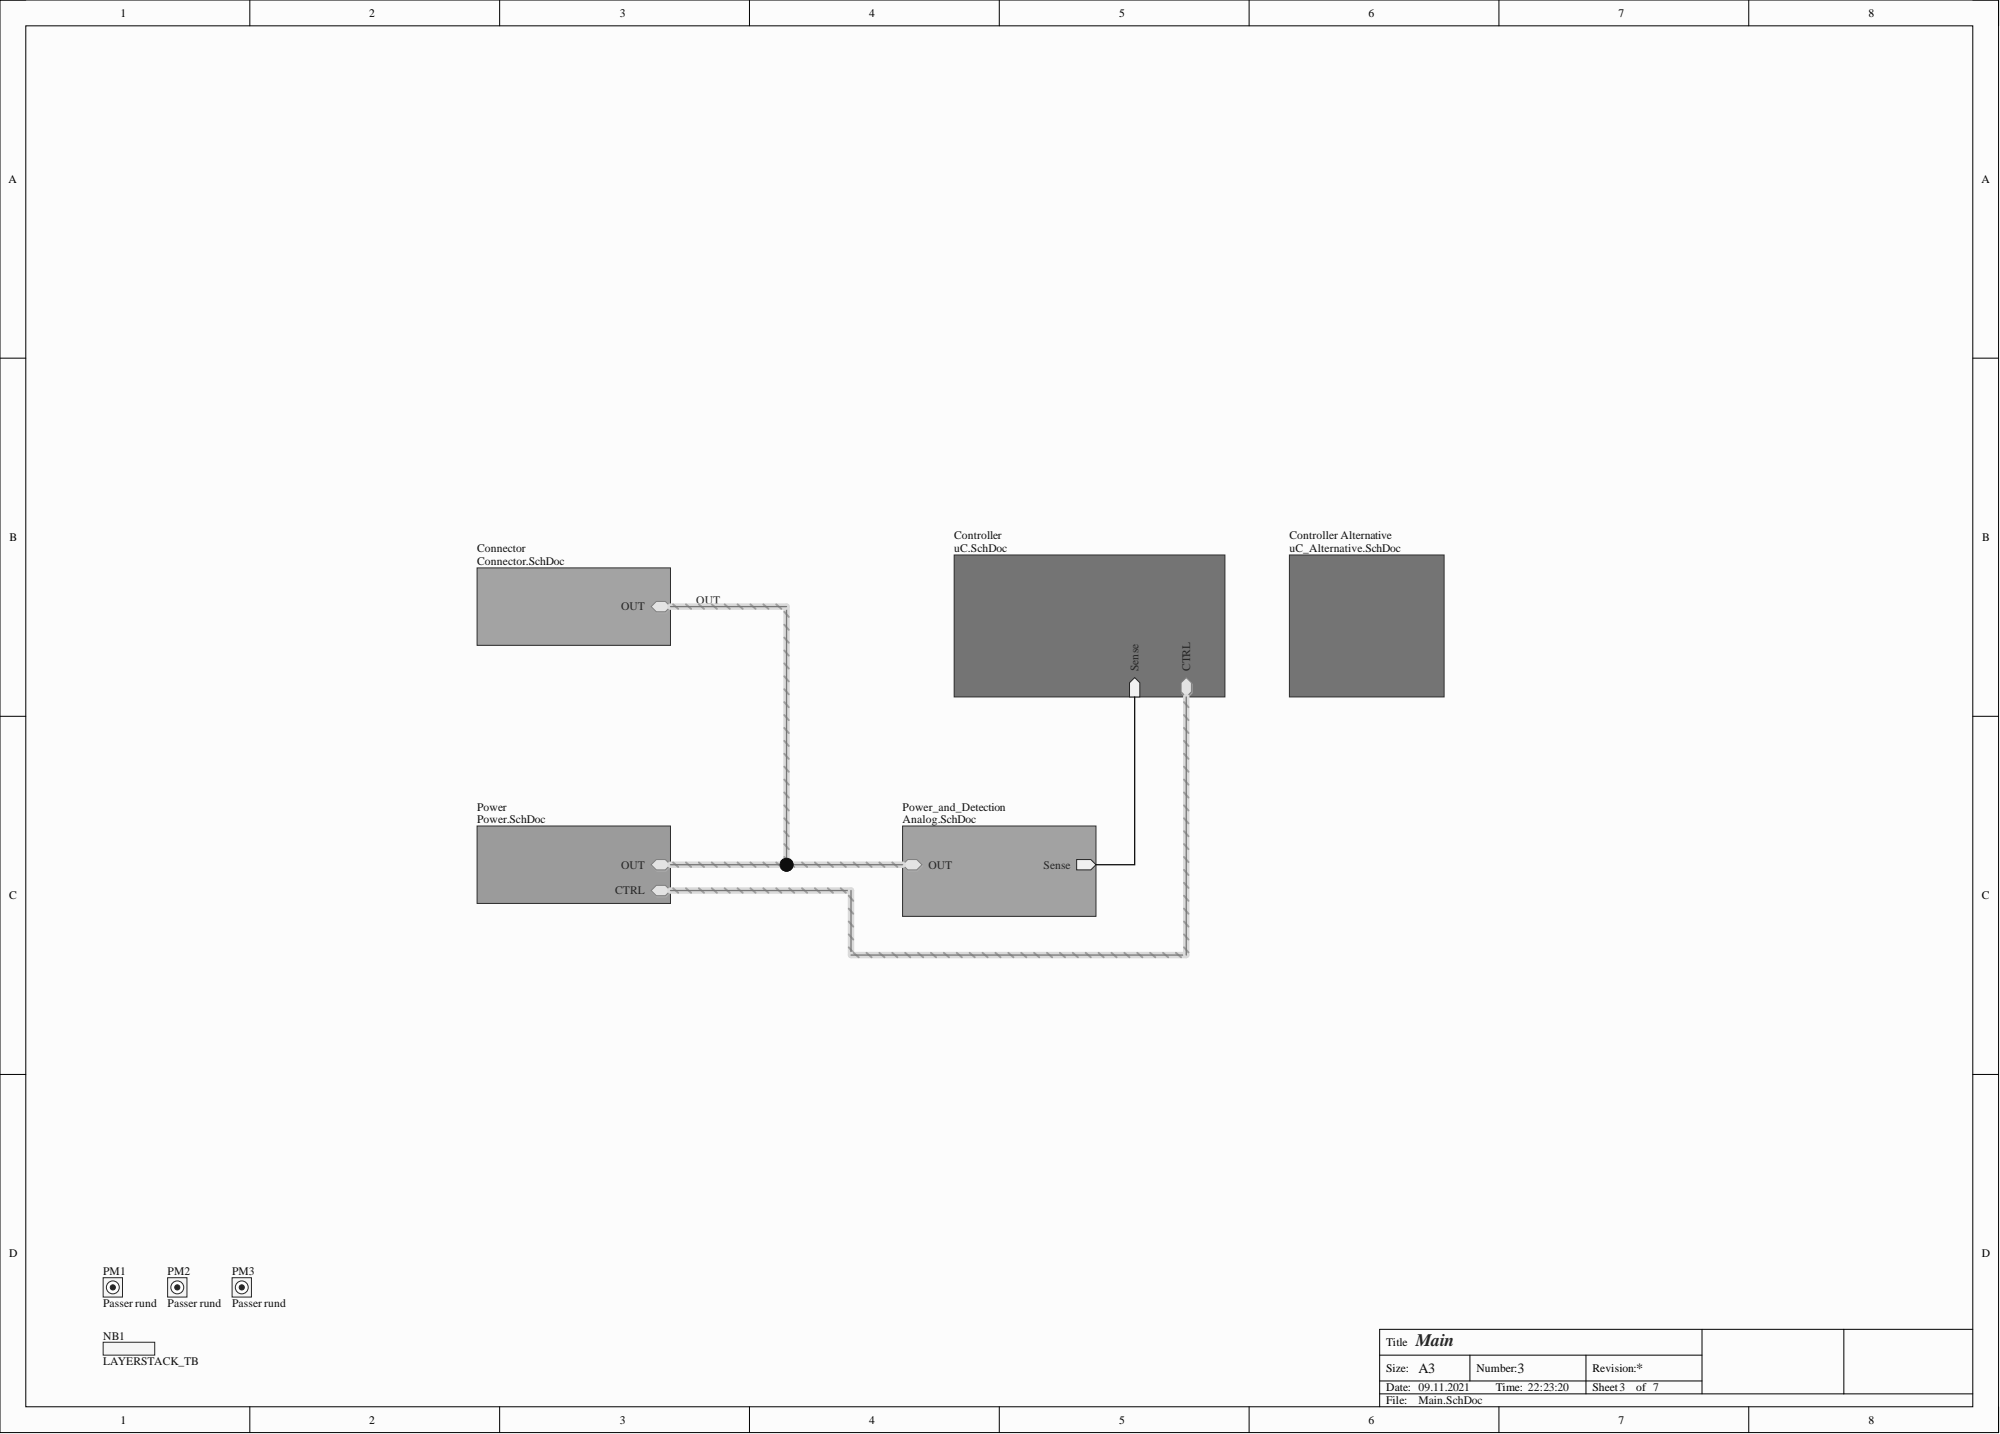
[picture p46: page 1]

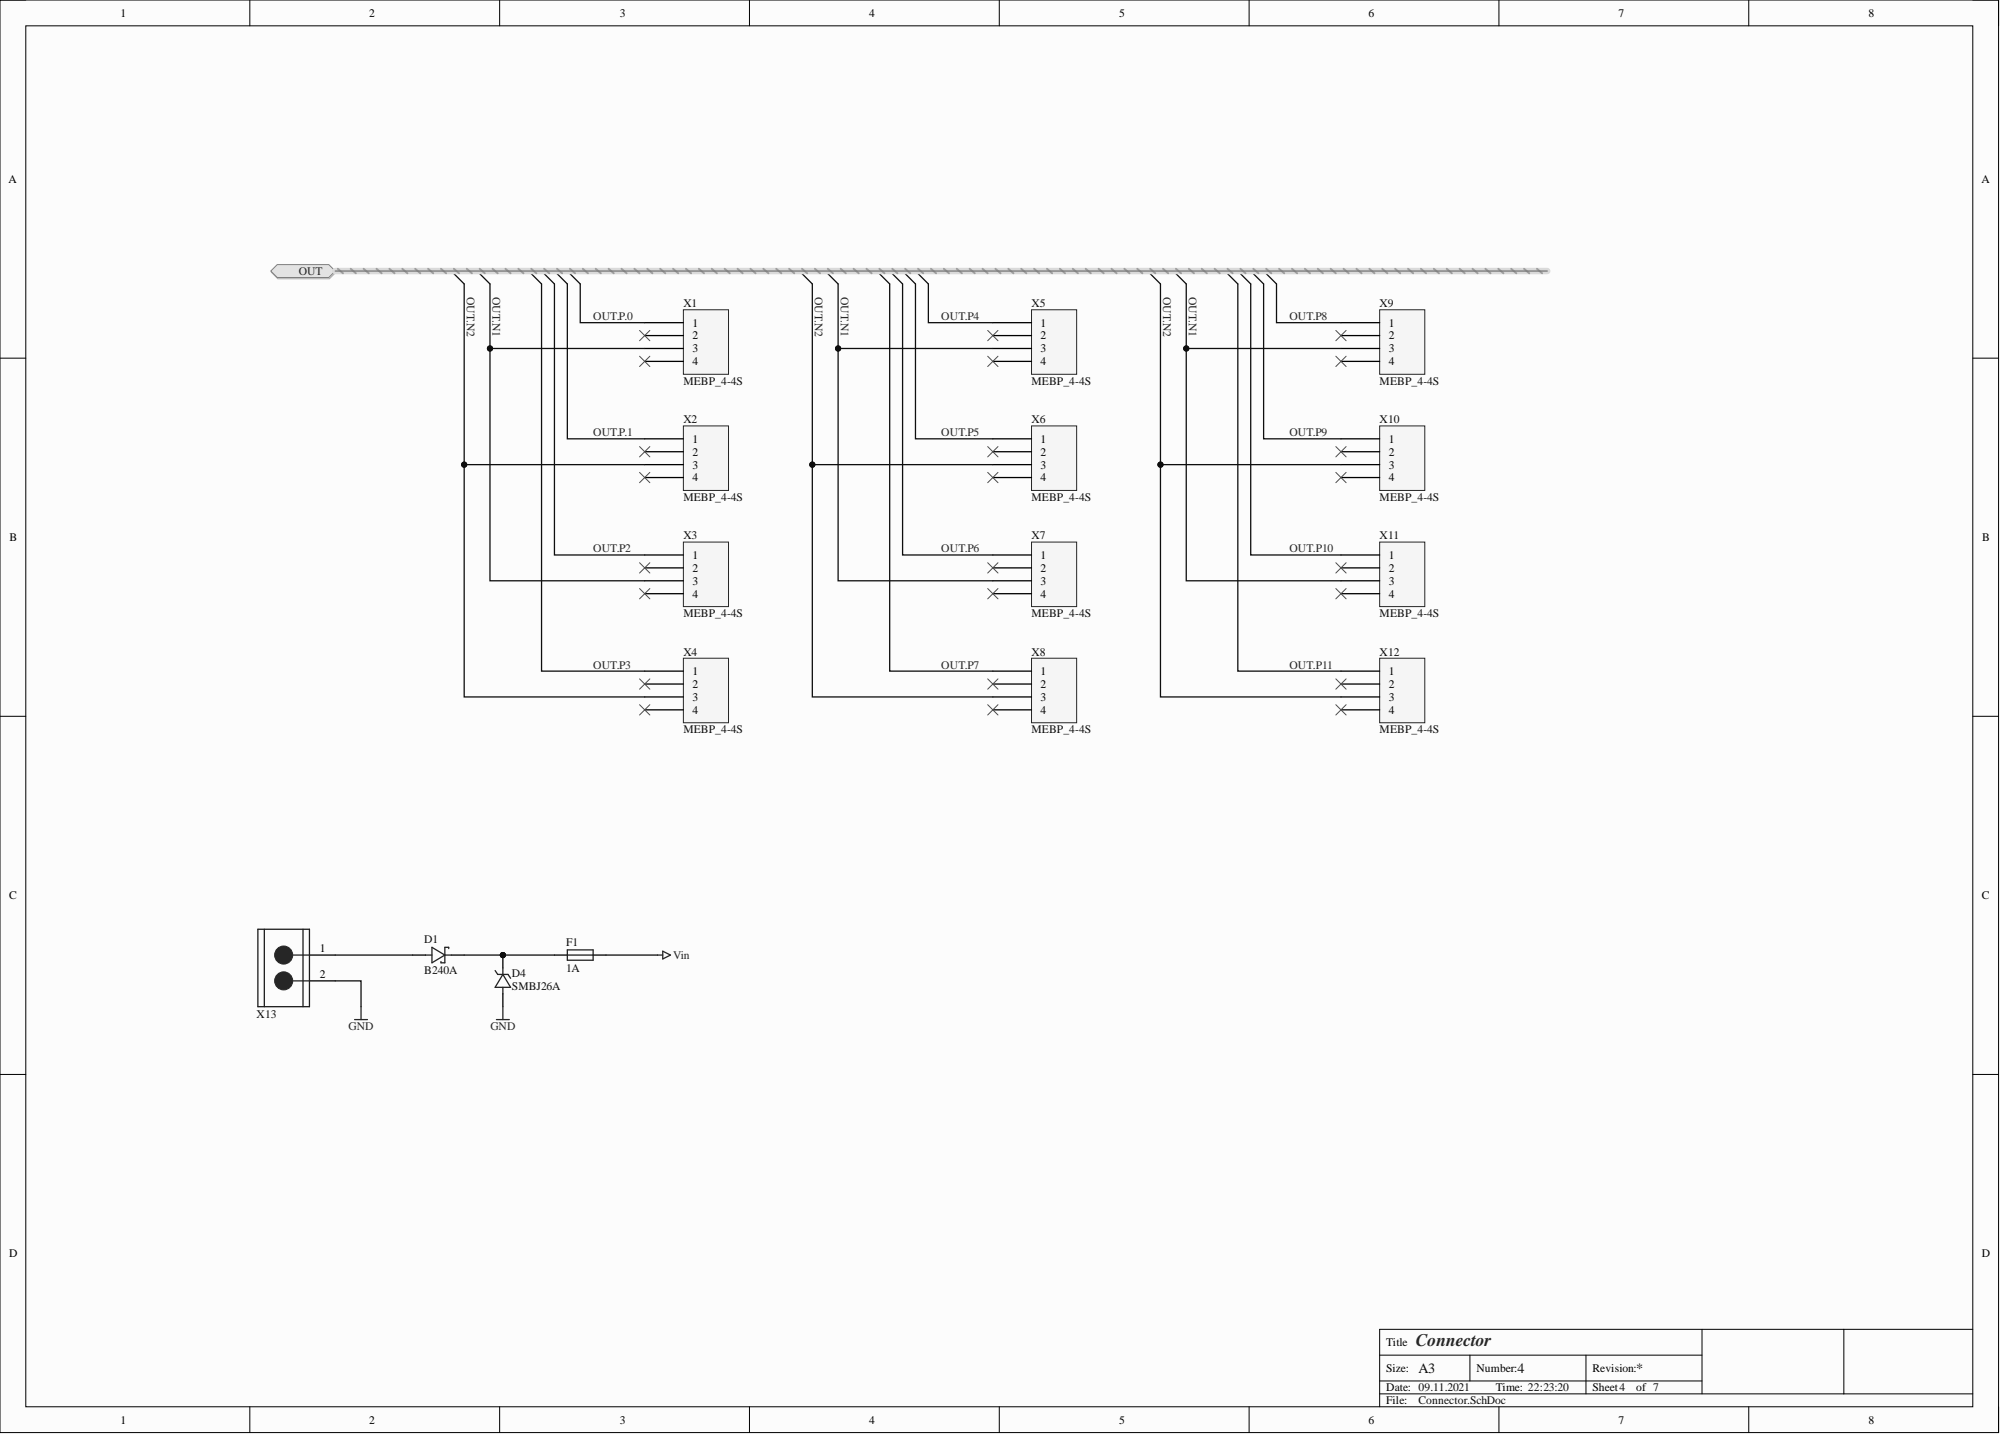
[picture p47: page 2]

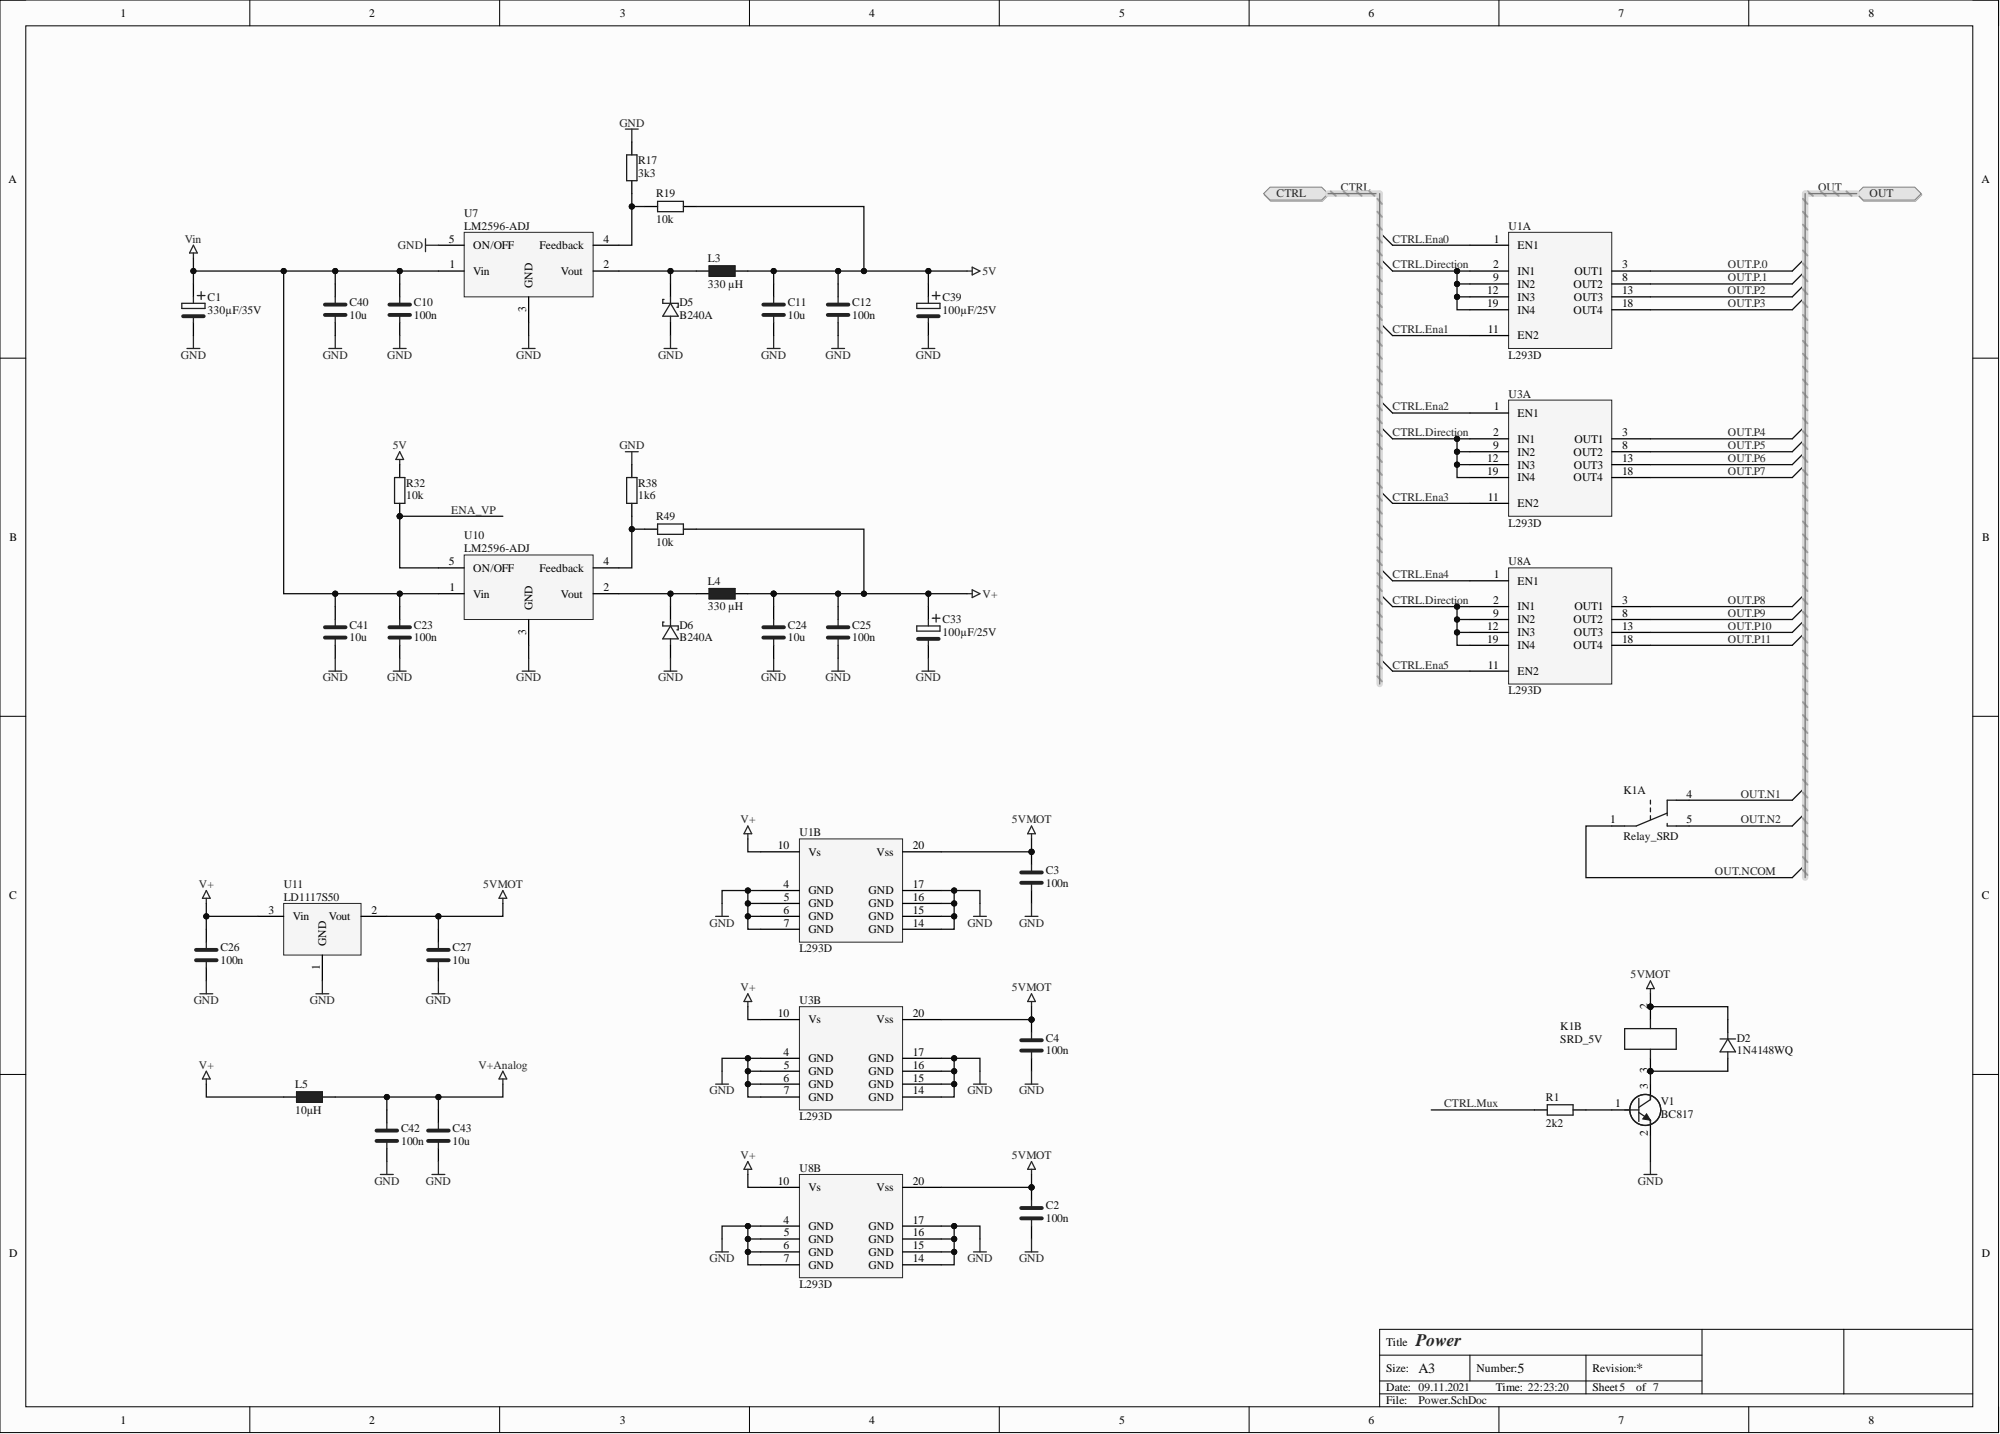
[picture p48: page 3]


U 1 3 ESP 3 2

G N 3 V
2 | E N SE NSOR_ V P SE NSOR_ V N IO 3 4 IO 3 5 IO 3 2 IO 3 3 IO 2 5 IO 2 6 IO 2 7 IO 1 4 IO 1 2 IO 0 | T X 0 RX 0 RX 2 T X 2 IO 0

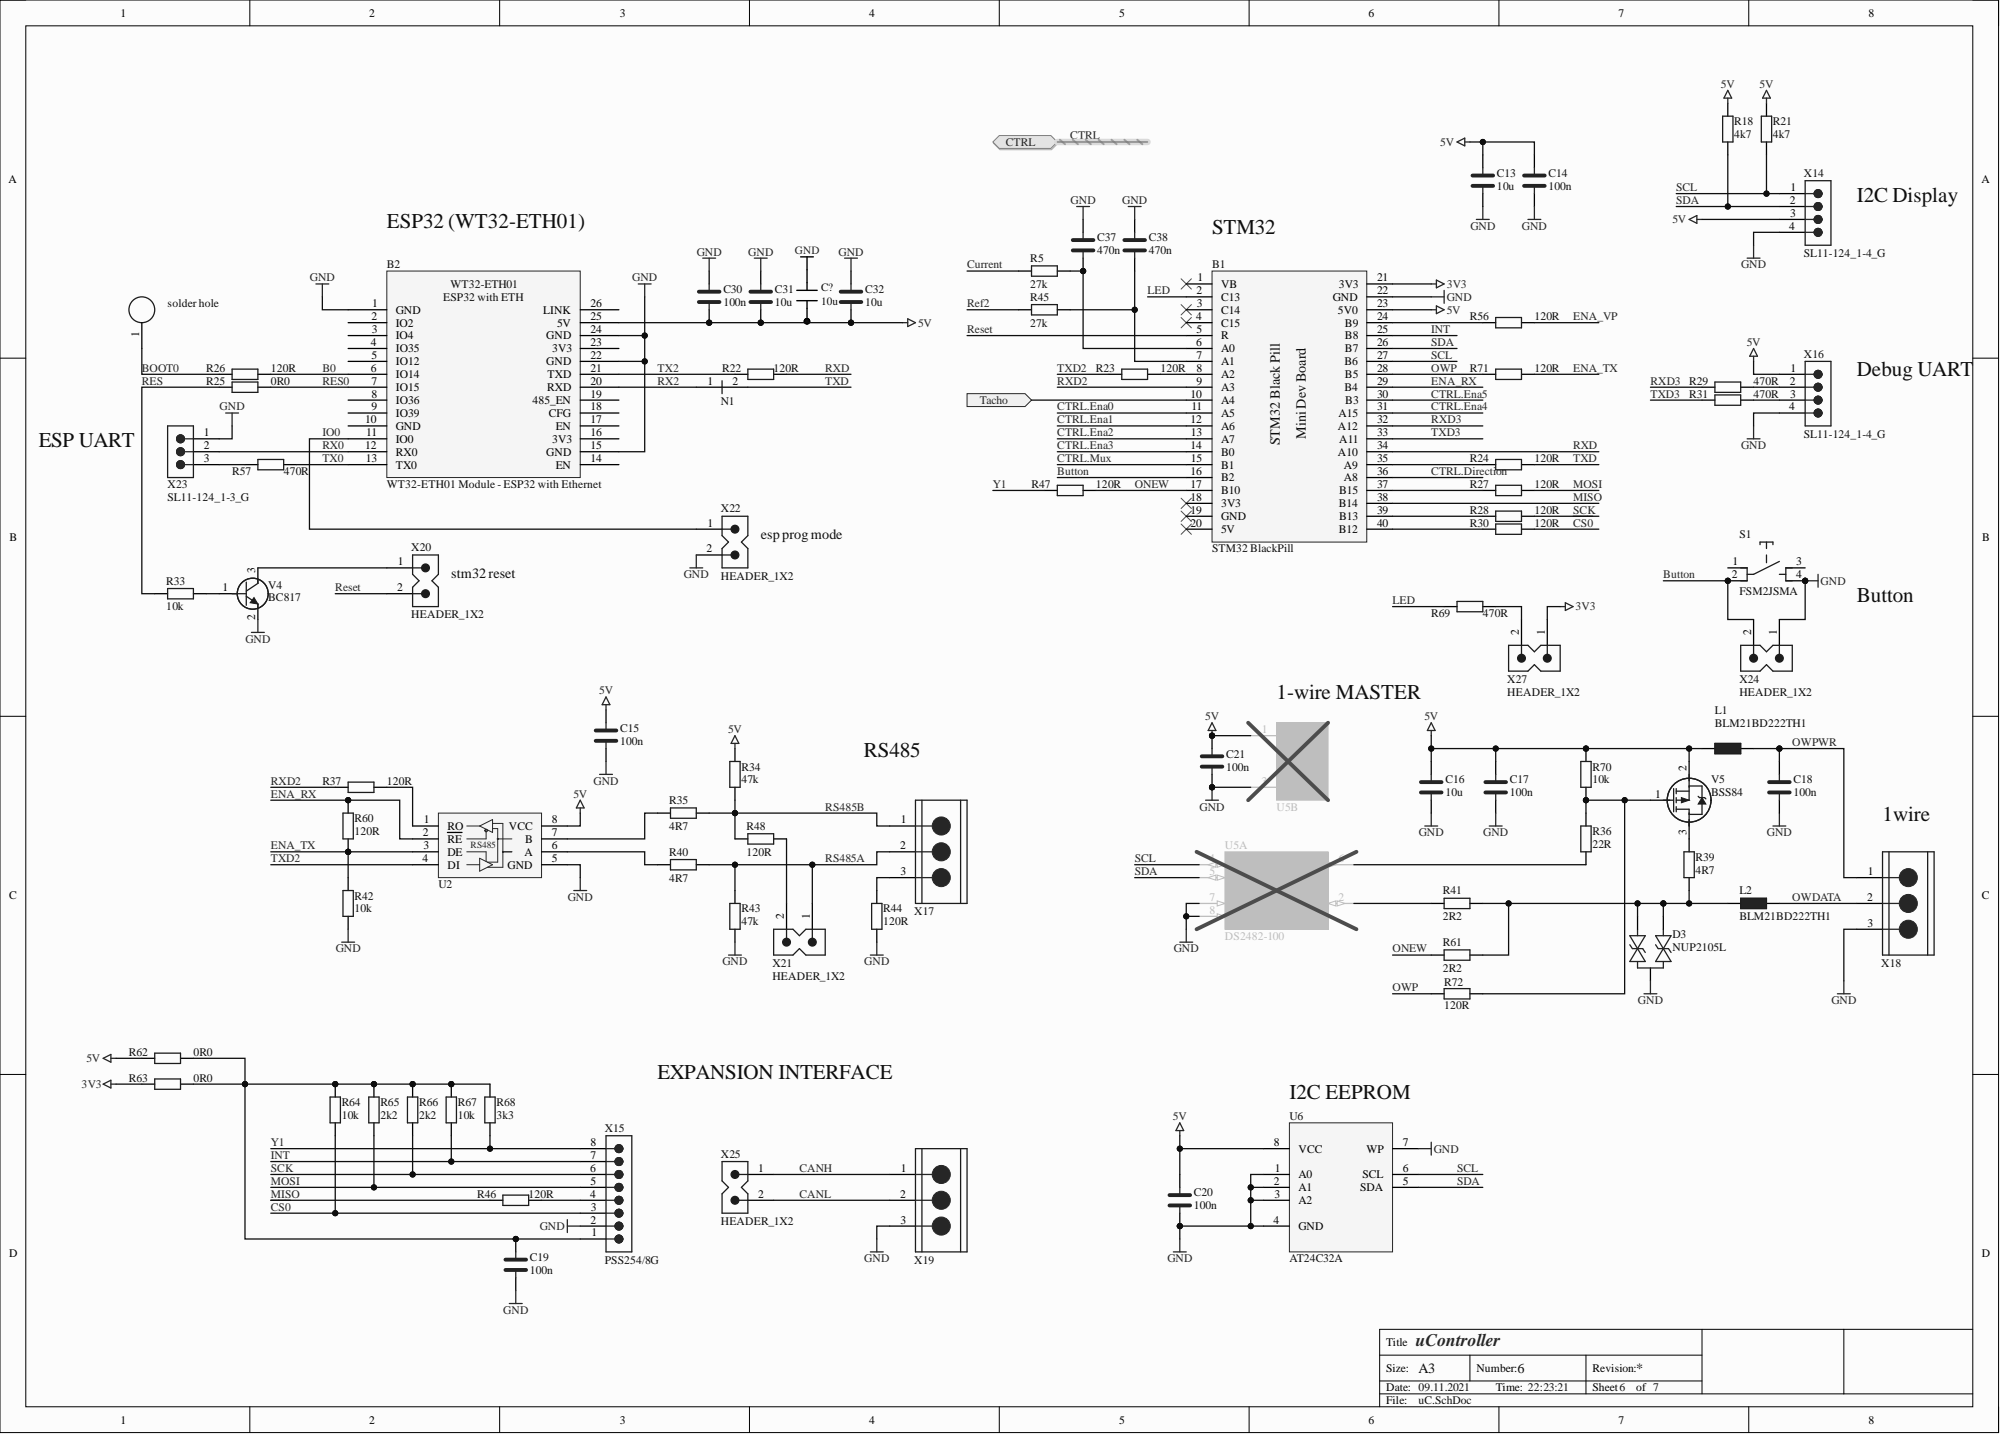
[picture p49: page 5]

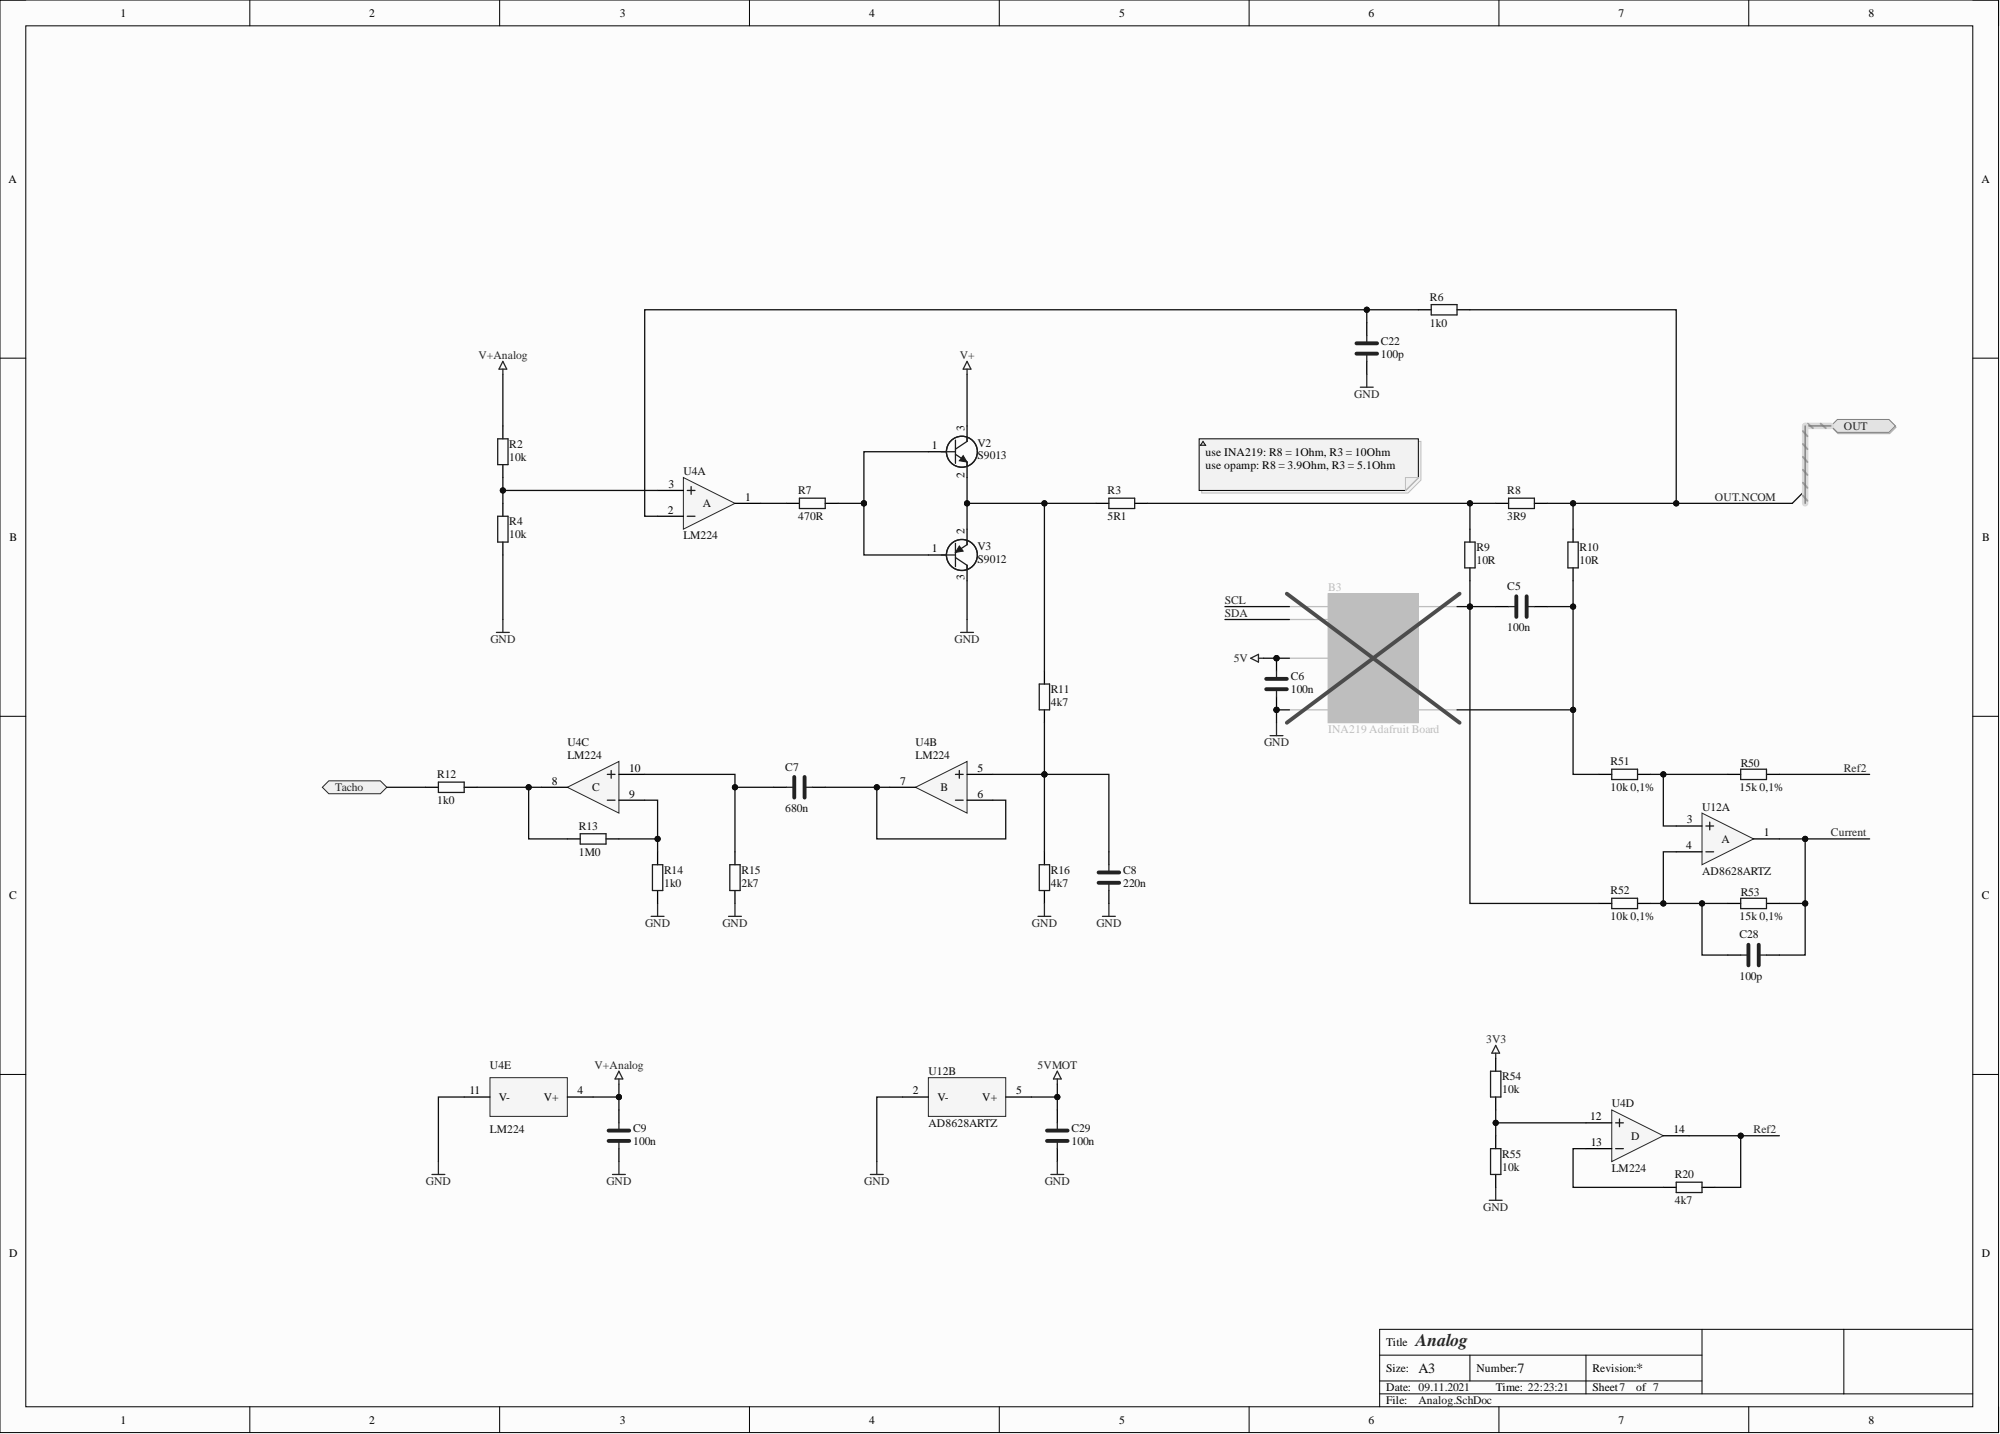
[picture p50: page 6]
