Lenti84/VdMot_Controller/hardware/schematic_b-sample_V02.pdf

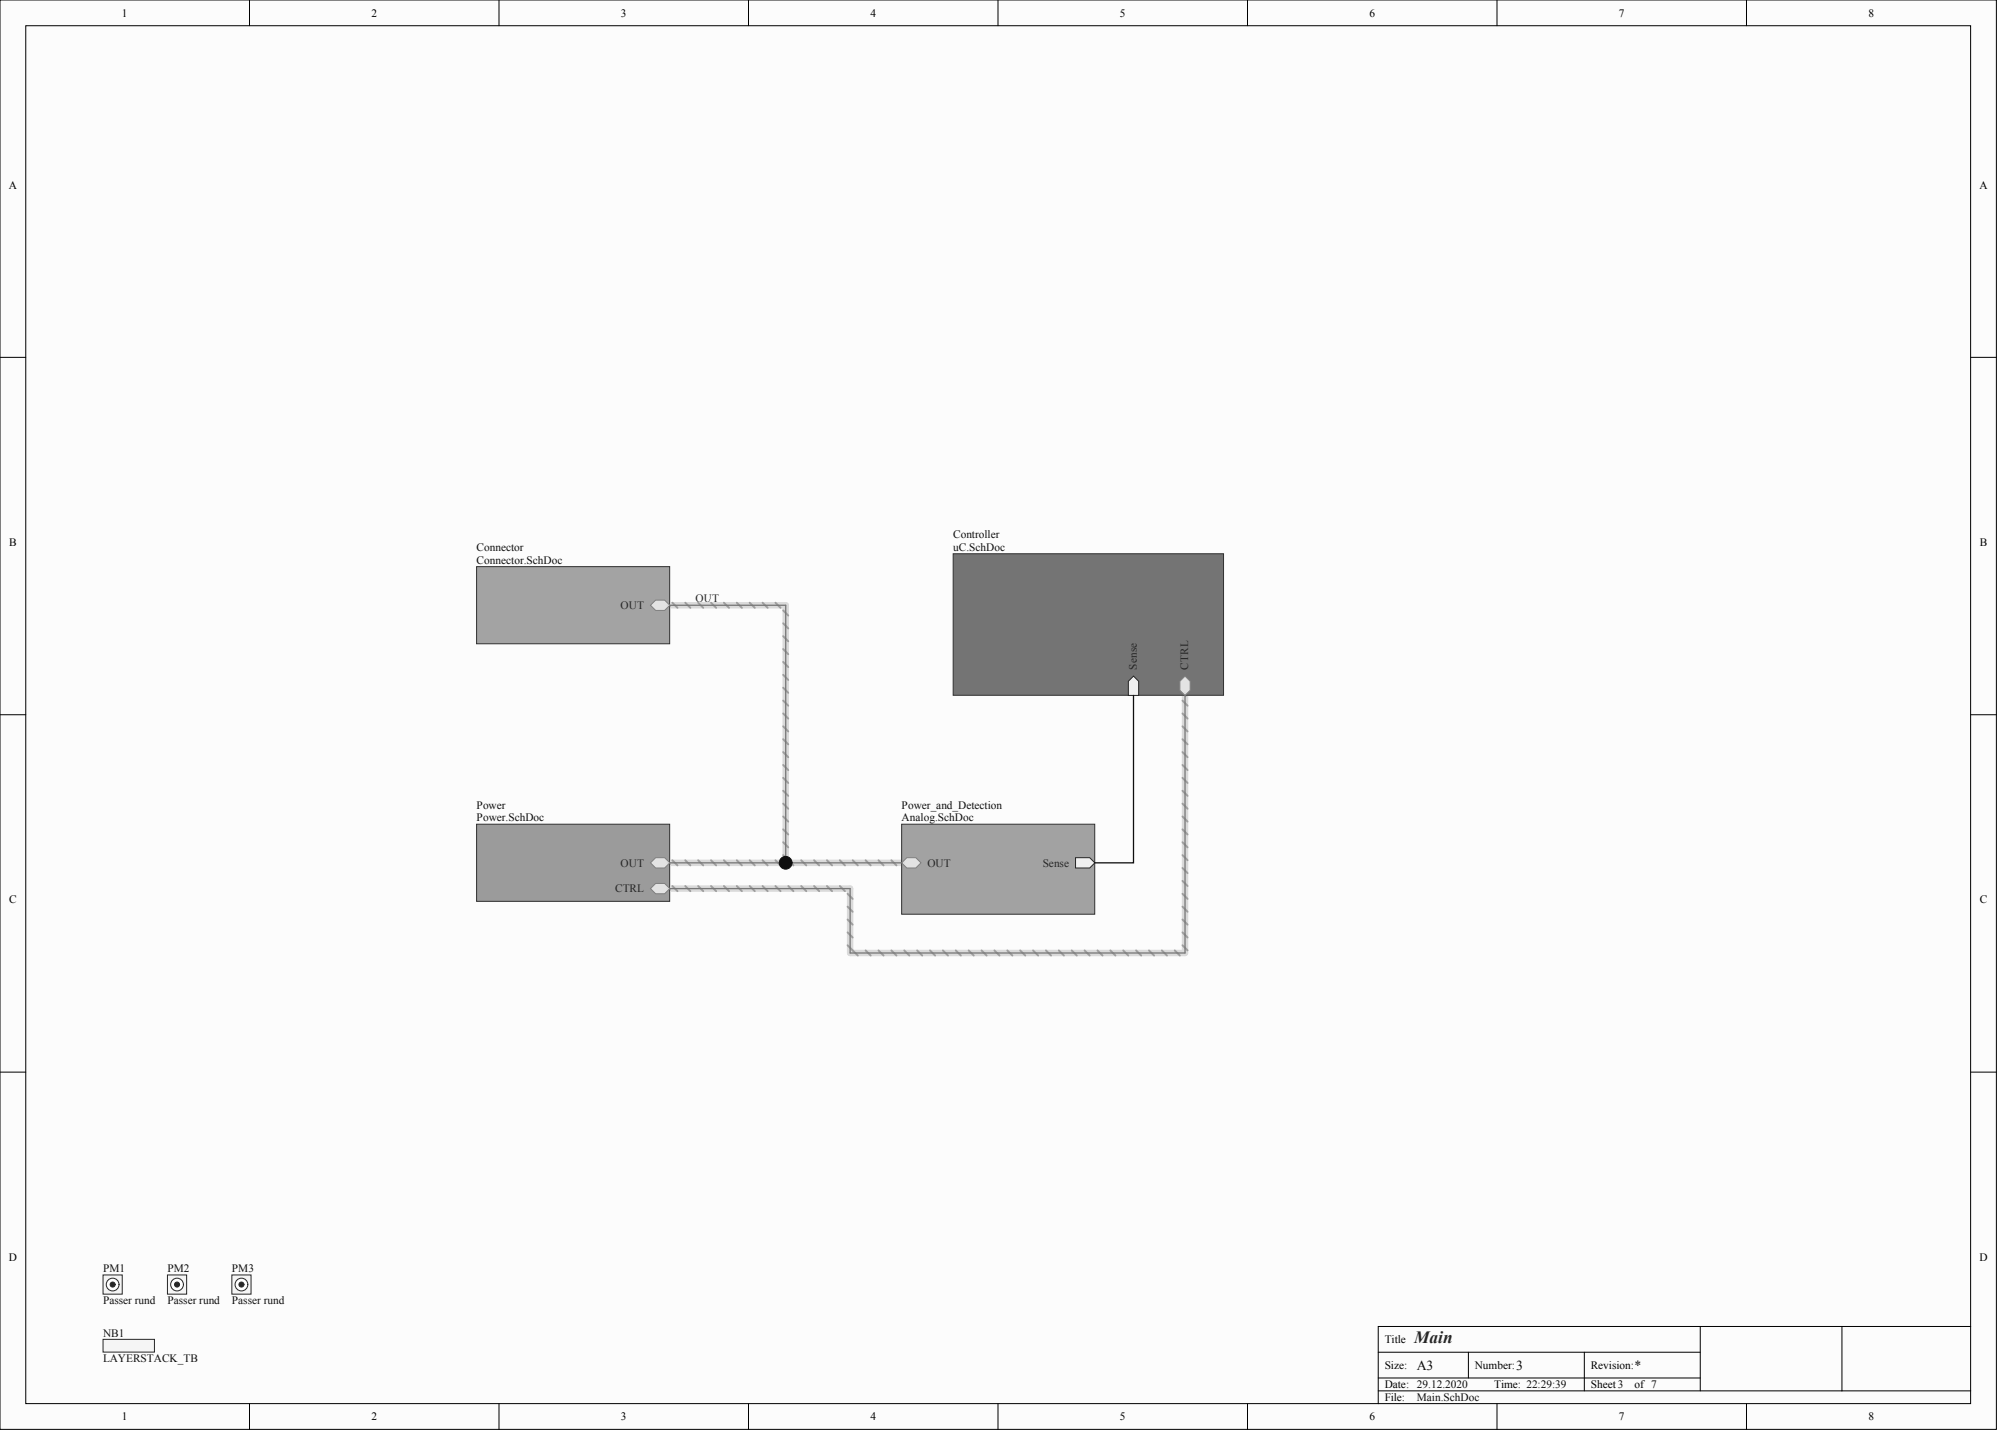
[picture p51: page 1]

Main Title

Size: A3 | Number: | Revision:

Date: 29.12.2020 Time: 22:29:39 | | Sheet of

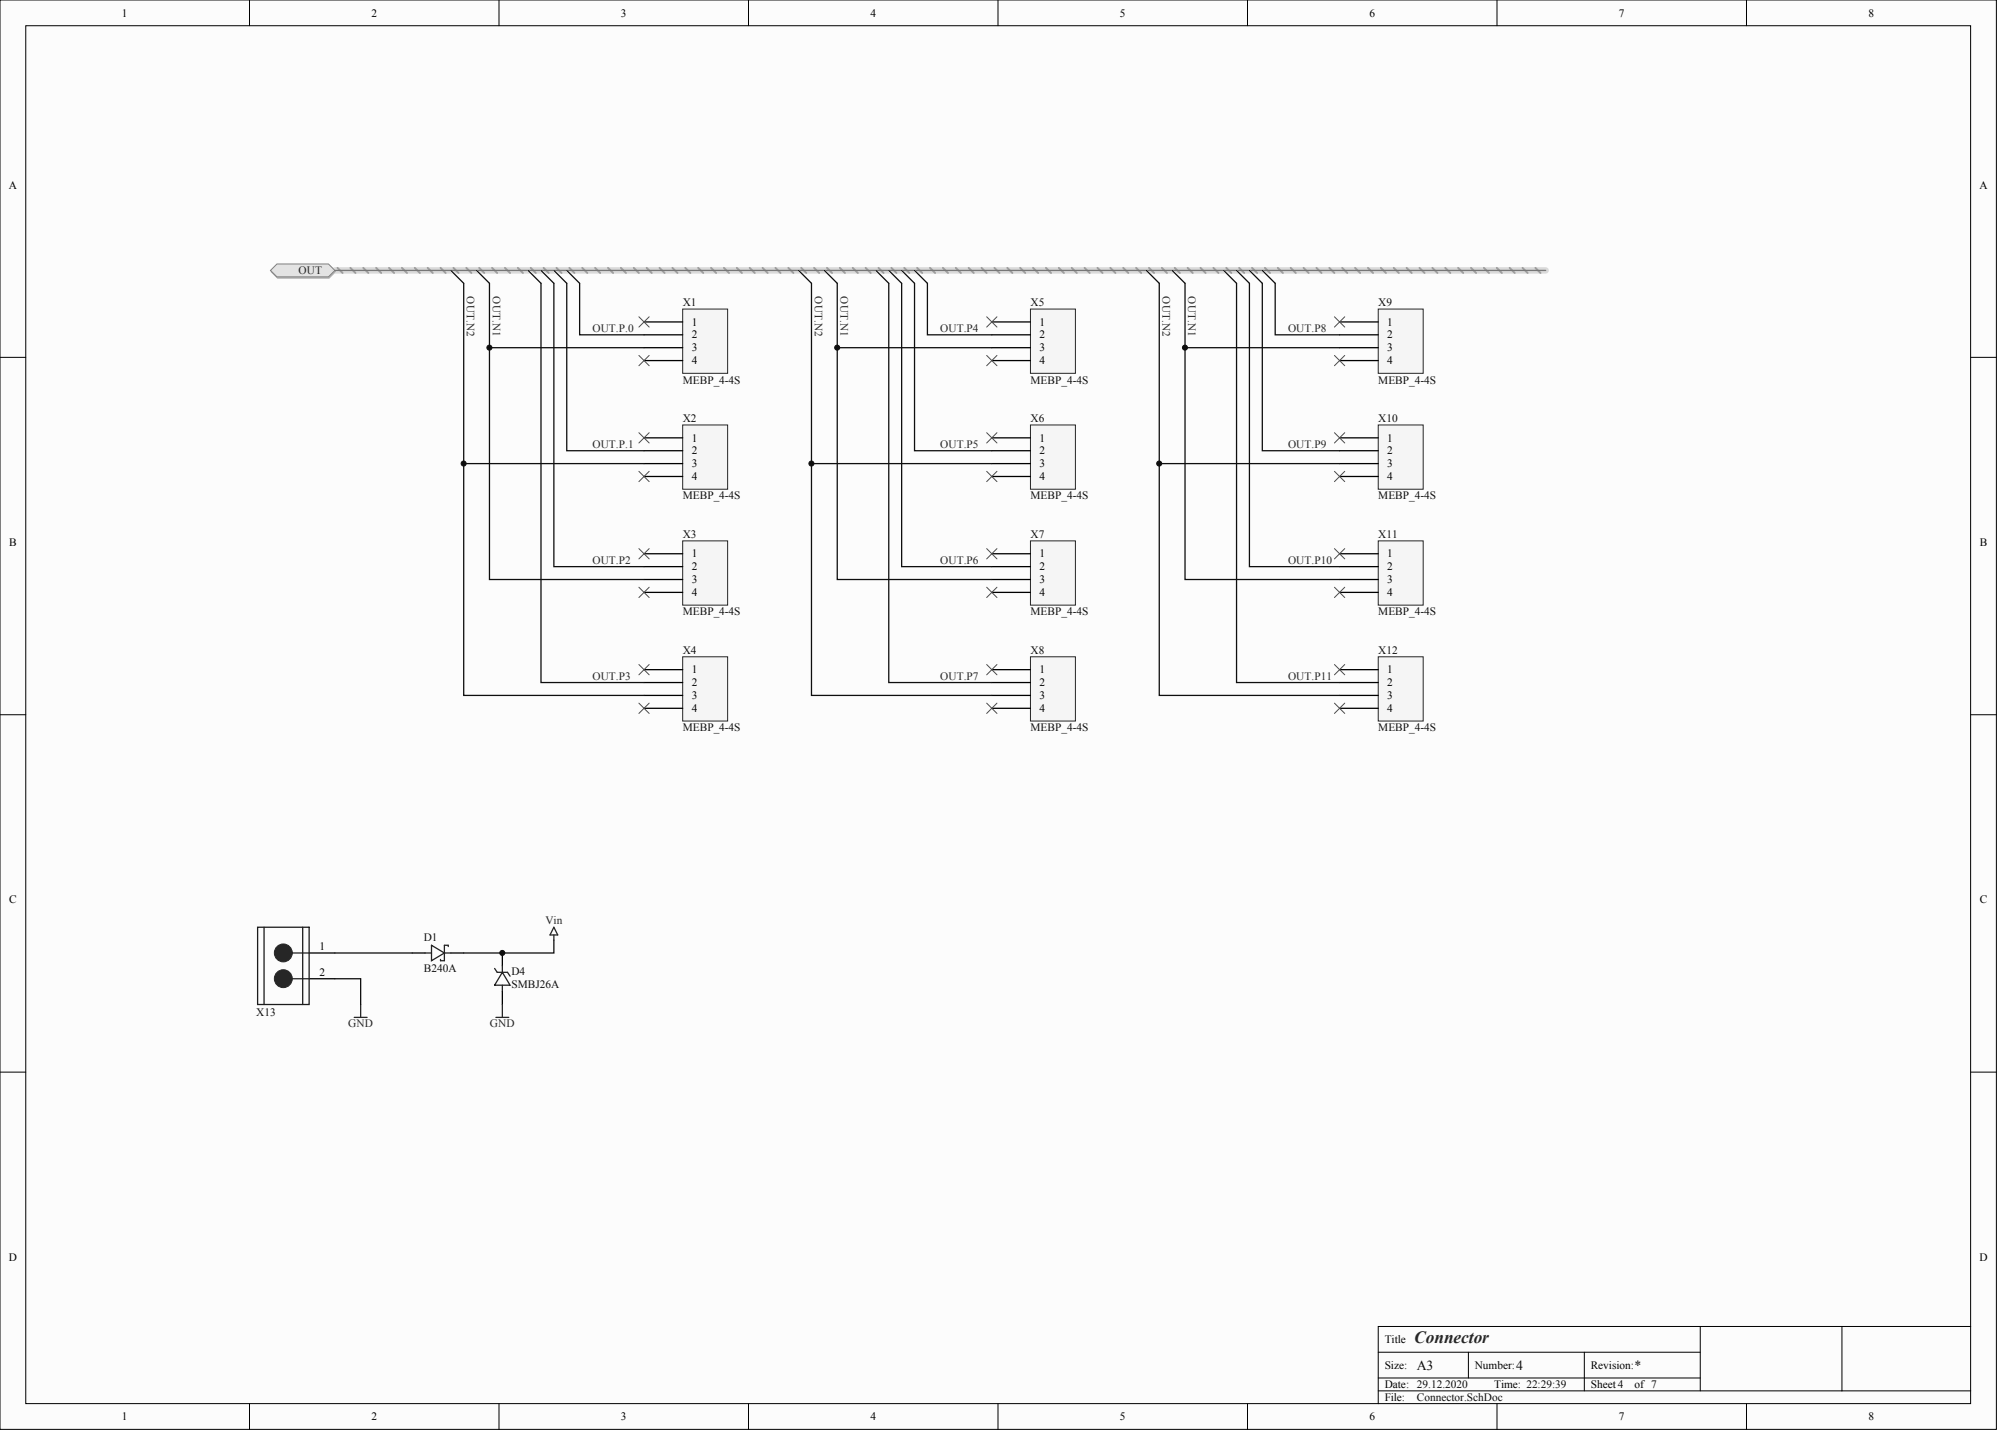
[picture p52: page 2]

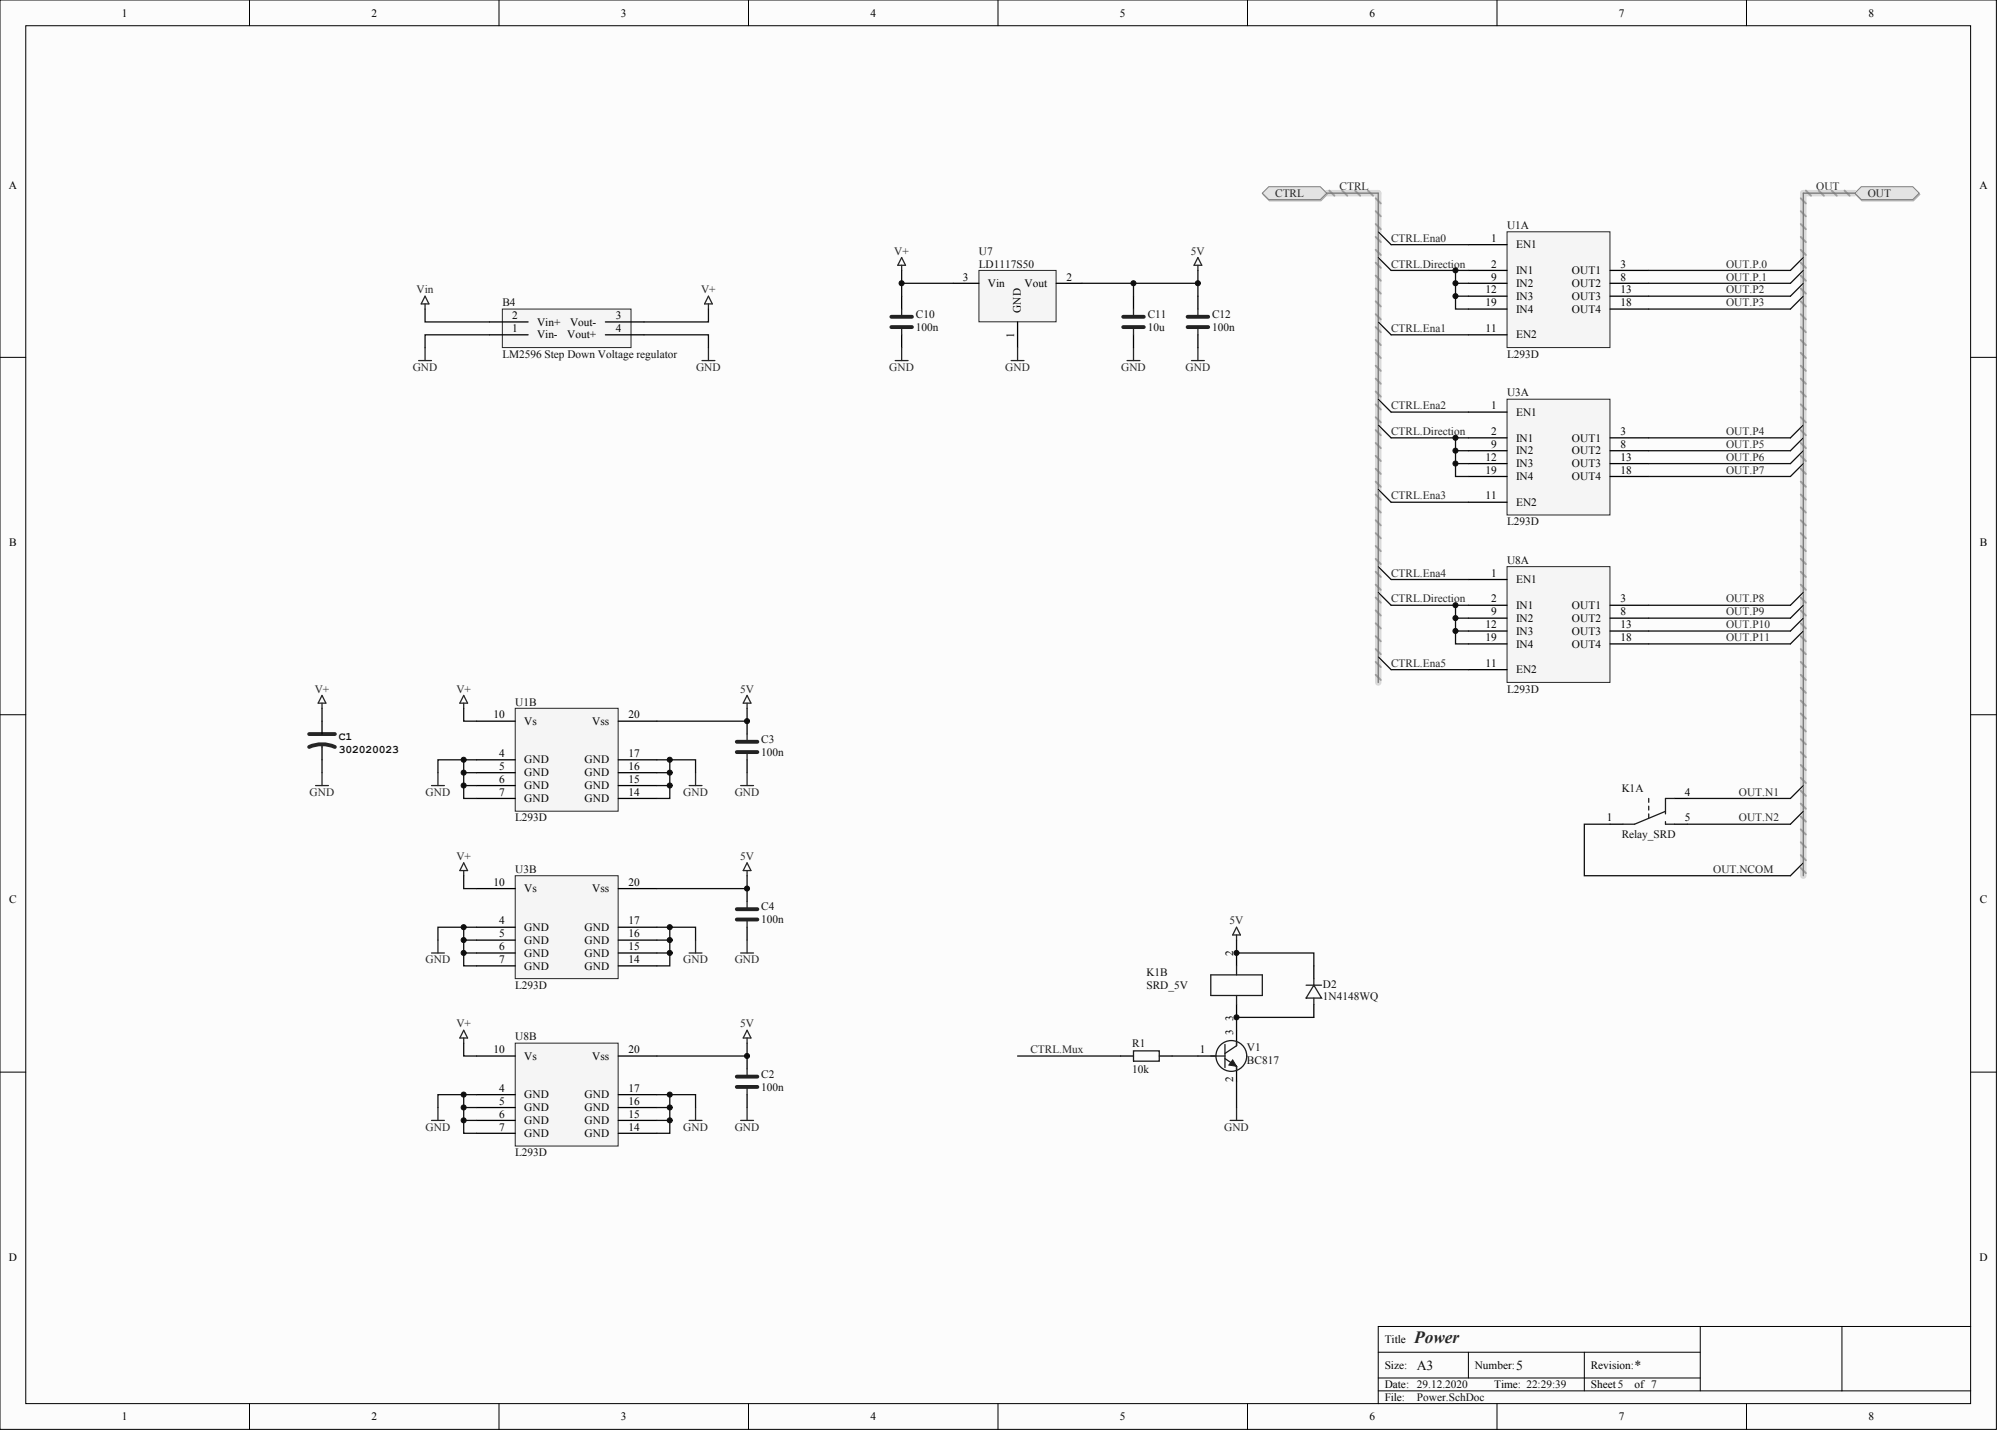
[picture p53: page 3]

B4 LM2596 Step Down Voltage regulator
Vin-
Vout+

Power

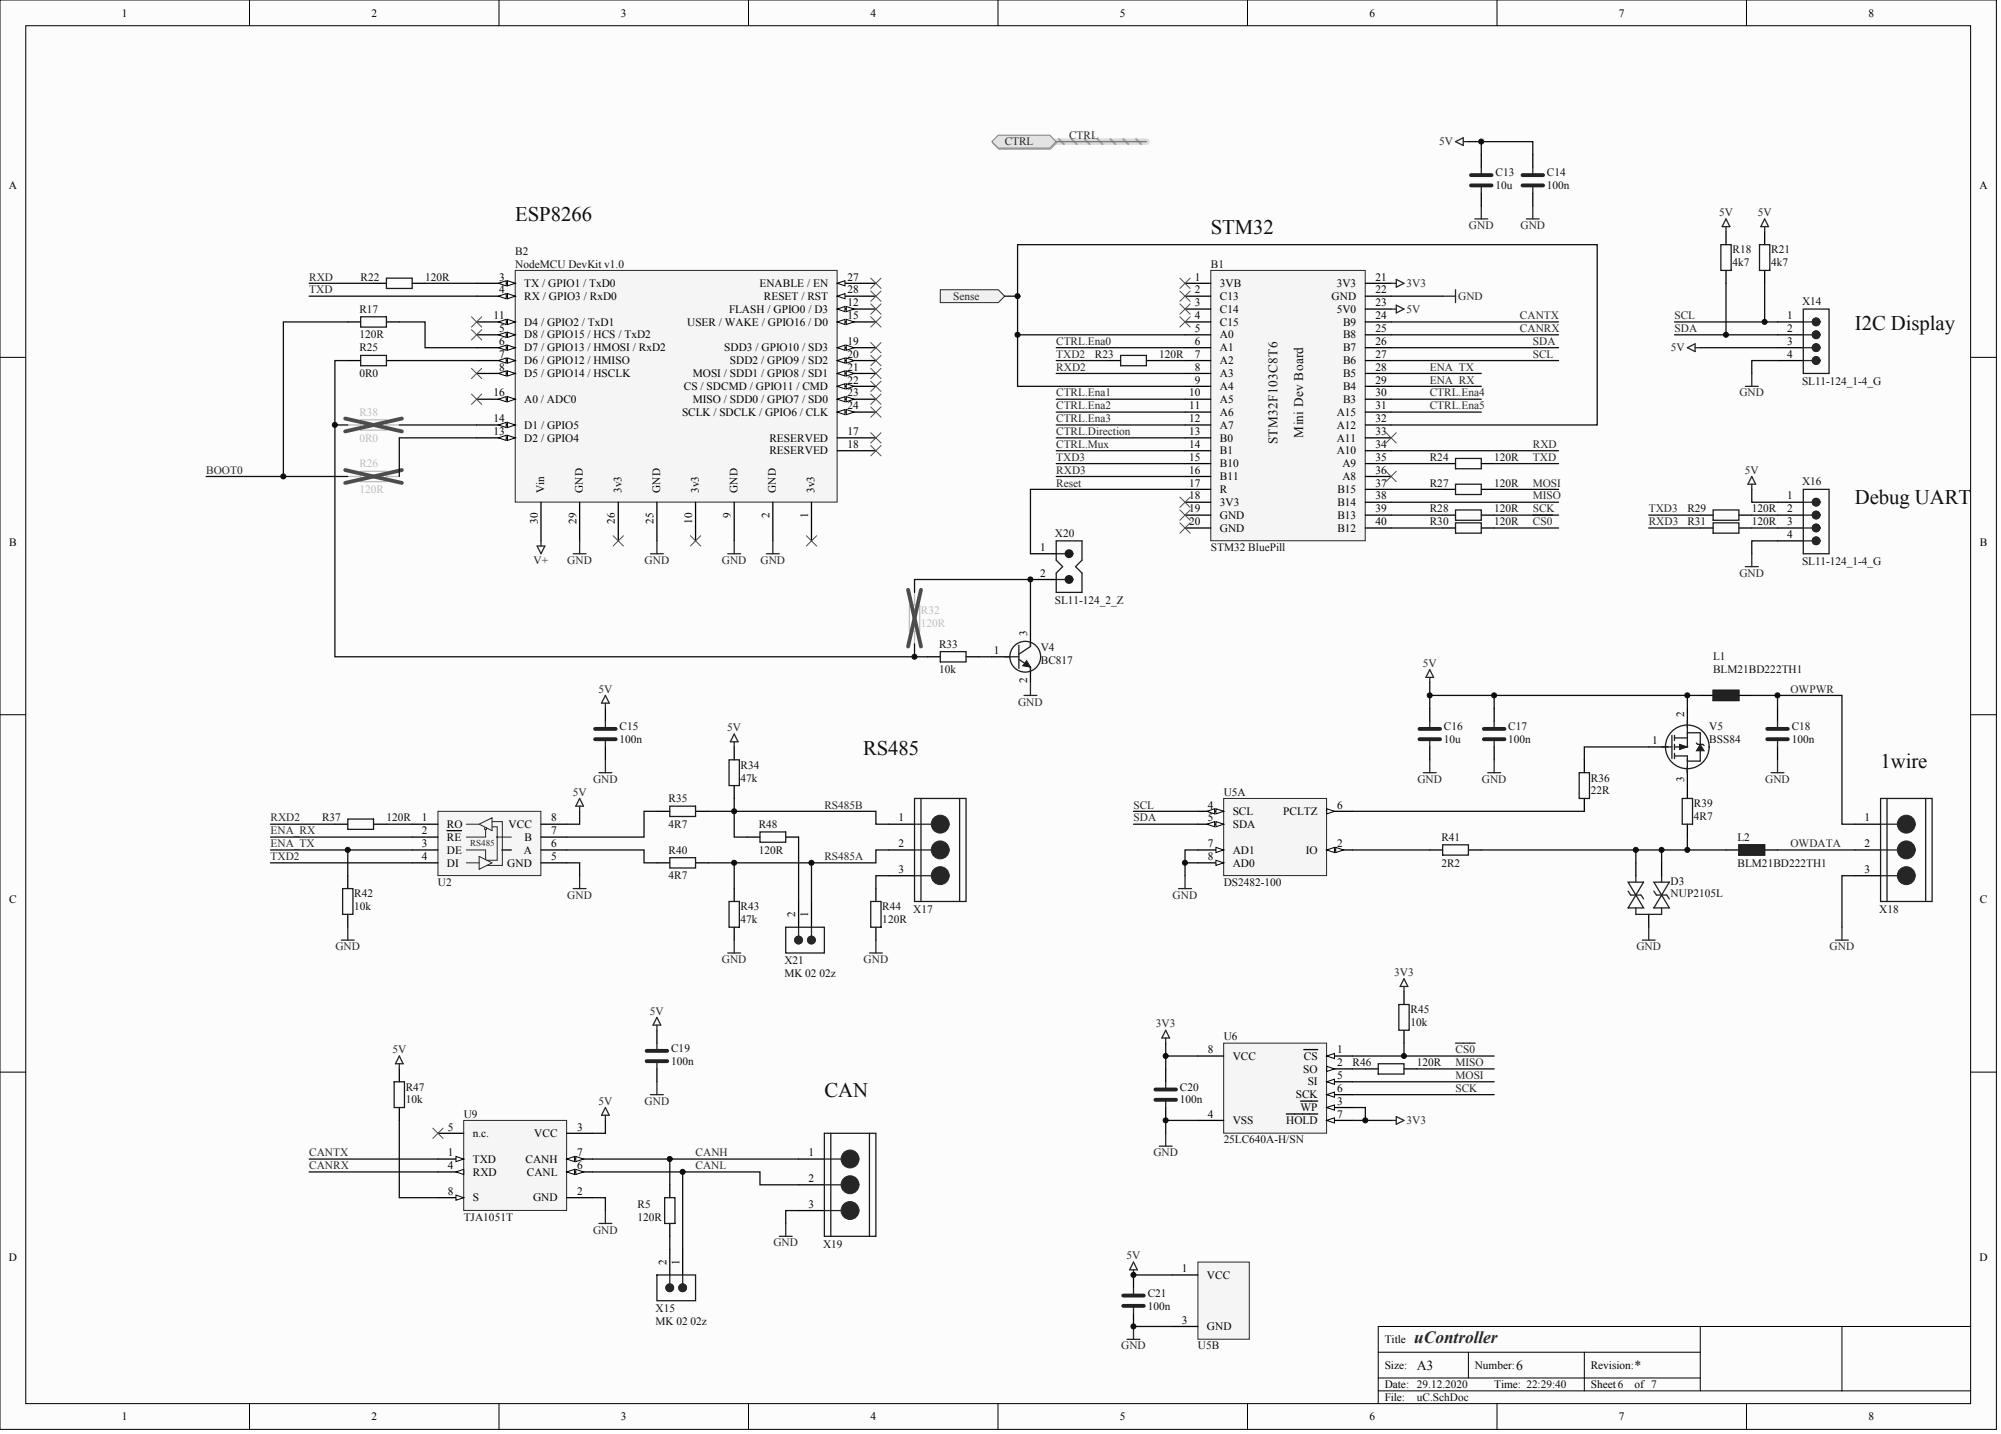
[picture p54: page 4]

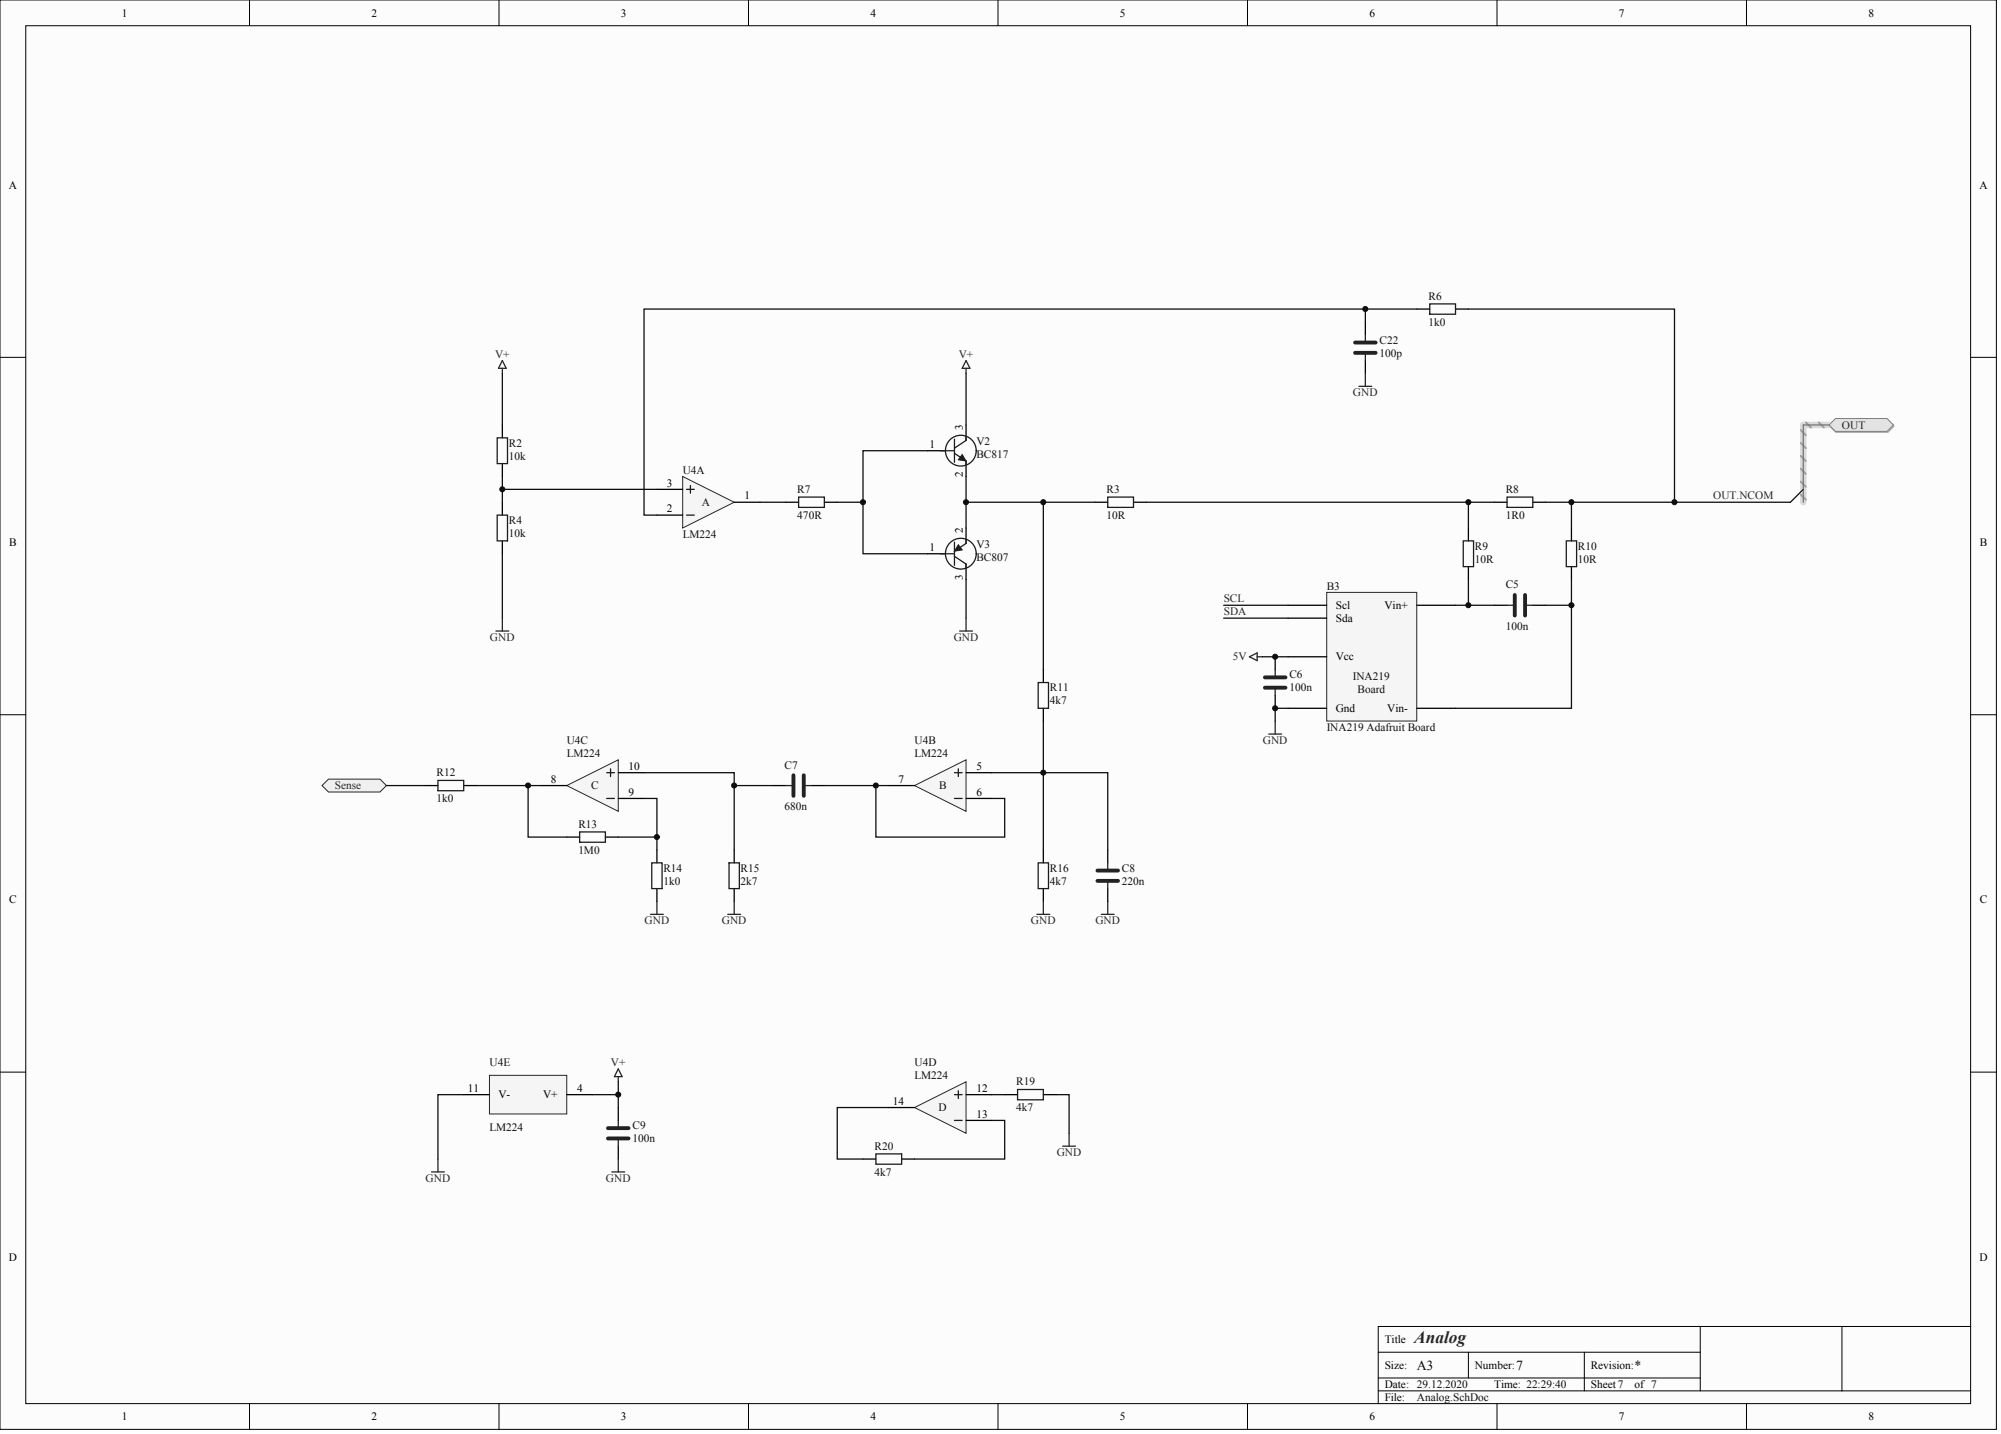
[picture p55: page 5]
