Lenti84/VdMot_Controller/software_stm32/src/main.cpp

/**HEADER*******************************************************************
  project : VdMot Controller
  author : Lenti84
  Comments:
  Version :
  Modifcations :
***************************************************************************
*
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
**************************************************************************
  This program is free software: you can redistribute it and/or modify
  it under the terms of the GNU General Public License as published by
  the Free Software Foundation, either version 3 of the License.
  See the GNU General Public License for more details.
  You should have received a copy of the GNU General Public License
  along with this program.  If not, see <http://www.gnu.org/licenses/>.
  Copyright (C) 2021 Lenti84  https://github.com/Lenti84/VdMot_Controller
*END************************************************************************/

#include <Arduino.h>
#include "hardware.h"
#include <Wire.h>
//#include <LiquidCrystal_PCF8574.h>
#include "motor.h"
#include "app.h"
#include "terminal.h"
#include "communication.h"
#include "temperature.h"
#include "eeprom.h"
#include "otasupport.h"
#include "STM32TimerInterrupt.h"      
#ifdef useCan
  #include "mycan.h"
#endif
#ifdef useRS485
  #include "rs485.h"
#endif

//using Matthias Hertel driver https://github.com/mathertel/LiquidCrystal_PCF8574
//LiquidCrystal_PCF8574 lcd(0x27);  // set the LCD address to 0x27 for a 16 chars and 2 line display

// info
// changes in arduino core lib
// .platformio\packages\framework-arduinoststm32\cores\arduino/HardwareSerial.h:44:4:
// --> increased tx buffer size from default 64 to 1024

// Init STM32 timer TIM2
STM32Timer ITimer1(TIM2);

void setup_system();
void loop_system();


void setup() {
  BootSetup();
}


void loop() {

  BootLoop();

  if (bootstate) {
    setup_system() ;

    while(1) {
      loop_system();
    }
  }
}


void setup_system() {

  //JumpToBootloader();

  Wire.begin();
  Wire.setSDA(I2C_SDA_PIN); // 
  Wire.setSCL(I2C_SCL_PIN); // 

  // while(1){
  // Wire.beginTransmission(0x71);
  // Wire.write('v');
  // Wire.endTransmission();
  // delay(1000);
  // }

  // power enable for valves
  pinMode(POWER_ENA, OUTPUT_OPEN_DRAIN);
  digitalWrite(POWER_ENA, 1);   // high to disable valve PSU

  // status led
  pinMode(LED, OUTPUT);

  // button 
  pinMode(BUTTON, INPUT_PULLUP);

  // analog inputs
  analogReadResolution(12);
  pinMode(ANINCURRENT, INPUT_ANALOG);
  pinMode(ANINREFHALF, INPUT_ANALOG);

  // terminal for debug
  Terminal_Init();

  // serial communication to ESP32
  communication_setup();

  // LCD
  // lcd.begin(16,2);  
  // lcd.setBacklight(255);
  // lcd.setCursor(0, 0);
  // lcd.print("Menu 4.x LCD");
  // lcd.setCursor(0, 1);
  // lcd.print("r-site.net");
  delay(500);

  // EEPROM
  eepromsetup();
  eeprom_read_layout (&eep_content);
 
  // setup onewire temperature sensor at DS2482
  temperature_setup();


  // valve app setup
  app_setup();
  valve_setup();

  #ifdef useCan
    // can
    //mycan_setup();          // can hardware testcode setup
  #endif
  
  #ifdef useRS485
    // rs485
    //rs485_setup();          // rs485 hardware testcode setup
  #endif

  // hardware timer for motor loop
  if (ITimer1.attachInterruptInterval(10 * 1000, valve_loop))
  {
    #ifdef motDebug 
        COMM_DBG.print(F("Starting ITimer1 OK, millis() = ")); COMM_DBG.println(millis());
    #endif
  }
  else {
    #ifdef motDebug
      COMM_DBG.println(F("Can't set ITimer1. Select another freq. or timer"));
    #endif
  }
}


void loop_system() {
  //static int x = 0;
  static int time10s = 0;
  static uint32_t loop_10ms = 0;
  static uint32_t loop_100ms = 0;
  static uint32_t loop_1000ms = 0;

  static uint8_t buttontest = 0;
  static uint8_t ledTimer = 0;

  int16_t recvcmd;
  

  // 1000 ms loop
  if ((millis()-loop_1000ms) > (uint32_t) 1000 ) {  
    loop_1000ms = millis();

    if(time10s>=10) {
      time10s = 0;
      app_10s_loop();
      // todo sync with comm COMM_SER.println("STMalive ");   // send alive to ESP32
    }
    else time10s++;

    //digitalWrite(LED, !digitalRead(LED));   // toggle LED    
    eepromloop();

  }


  // 100 ms loop
  if ((millis()-loop_100ms) > (uint32_t) 100 ) {  
    loop_100ms = millis();  
    ledTimer++;
    if (ledTimer==30) {
      digitalWrite(LED,LOW);  
    }
    if (ledTimer==31) {
      digitalWrite(LED,HIGH);
      ledTimer=0;  
    }
    recvcmd = Terminal_Serve();
    
    // button test
    if (digitalRead(BUTTON) > 0 && buttontest == 0) 
    {
      buttontest = 1;
      COMM_DBG.println("Button pressed");
    }
    else buttontest = 0;
      
  }


  // 10 ms loop
  if ((millis()-loop_10ms) > (uint32_t) 10 ) {  
    loop_10ms = millis();  
    
    app_loop();  
    communication_loop();
    temperature_loop();
  }
}
