Lenti84/VdMot_Controller/software_esp32/src/stmApp.cpp

/**HEADER*******************************************************************
  project : VdMot Controller

  author : SurfGargano, Lenti84

  Comments:

  Version :

  Modifcations :


***************************************************************************
*
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
  Copyright (C) 2021 Lenti84  https://github.com/Lenti84/VdMot_Controller

*END************************************************************************/




#include "globals.h"
#include <ArduinoJson.h>
#include <Arduino.h>
#include "stmApp.h"
#include <WiFi.h>
#include <Syslog.h>
#include <WiFiUdp.h>
#include "VdmNet.h"
#include "VdmSystem.h"
#include "VdmConfig.h"
#include "VdmTask.h"
#include "stm32.h"
#include "Queue.h"
#include "Messenger.h"

#define     MAX_CMD_LEN     10
#define     MAX_ARG_LEN     120

static const char* commCmds [] = 
               {APP_PRE_SETTARGETPOS,APP_PRE_GETONEWIRECNT,APP_PRE_GETONEWIREDATA,
                APP_PRE_SETONEWIRESEARCH,APP_PRE_SETALLVLVOPEN,APP_PRE_GETVLVDATA,
                APP_PRE_SETVLLEARN,APP_PRE_GETVERSION,APP_PRE_GETHWINFO,APP_PRE_GETTARGETPOS,
                APP_PRE_SETMOTCHARS,APP_PRE_GETMOTCHARS,APP_PRE_SETVLVSENSOR,
                APP_PRE_GETONEWIRESETT,APP_PRE_SETLEARNMOVEM,APP_PRE_GETLEARNMOVEM,
                APP_PRE_GETVLSTATUS,APP_PRE_SETDETECTVLV,APP_PRE_MATCHSENS,
                APP_PRE_SOFTRESET,NULL};


CStmApp StmApp;

CStmApp::CStmApp() 
{
    settarget_check =false;
    tempIndex=0;
    checkTempsCount = 0;
    cmd_buffer = "";
    found = false;
    bufptr = buffer;
    buflen = 0;
    argcnt = 0;
    tempsPrivCount=0;
    tempsCount=0;
    setTempIdxActive=false;
    waitForFinishQueue=false;
    setMotorCharsActive=false;
    motorChars.startOnPower=0;
    fastQueueMode=false;
    stmStatus=STM_NOT_READY;
    getindex = 0;
    memset(cmd,0x0,sizeof(cmd));
    appState=APP_IDLE;
    timeout = 0;
    retry = 0;
    cnt_alive = COMM_ALIVE_CYCLE;
    appRetry=0;
    appTimeOuts=0;
    commstate=COMM_IDLE;
    matchSensorRequest=false;
    waitEEPFinished=false;
    stmInitState=STM_INIT_NOT_STARTED;
    fastGetOneWire=false;
    oneWireAllRead=false;
    
}

void  CStmApp::app_setup() {
    UART_STM32.setRxBufferSize (2000);
    UART_STM32.begin(115200, SERIAL_8N1, STM32_RX, STM32_TX, false, 20000UL); 
    
    for (uint8_t x = 0;x<ACTUATOR_COUNT;x++) {
        actuators[x].actual_position = 0;
        actuators[x].target_position = 0;
        actuators[x].meancurrent = 0;
        actuators[x].state = VLV_STATE_START; //VLV_STATE_IDLE;
        actuators[x].temp1 = -500;
        actuators[x].temp2 = -500;
        actuators[x].tIdx1 = 0;
        actuators[x].tIdx2 = 0;
        actuators[x].lastState = actuators[x].state;
        actuators[x].worked = false;
        actuators[x].calibRetries = 0;
   }

    for (uint8_t x = 0; x<ACTUATOR_COUNT; x++) {
        target_position_mirror[x] = actuators[x].target_position;
    }
    commstate=COMM_IDLE;
    appState=APP_IDLE;
    #ifdef EnvDevelop
        UART_DBG.println("application setup finished");
    #endif
    if (VdmConfig.configFlash.netConfig.syslogLevel>=VISMODE_ATOMIC) {
        syslog.log(LOG_DEBUG, "stmApp: application setup finished");
    }
    UART_STM32.println("123456"); // dummy send
}

void  CStmApp::setupStartPosition(uint8_t thisStartPosition) 
{
    for (uint8_t x = 0;x<ACTUATOR_COUNT;x++) {
        actuators[x].target_position = thisStartPosition;
        target_position_mirror[x] = actuators[x].target_position;
    }
    #ifdef EnvDevelop
        UART_DBG.println("application setup start position finished");
    #endif
}


int16_t CStmApp::ConvertCF(int16_t cValue)
{
    if (VdmConfig.configFlash.systemConfig.celsiusFahrenheit==0) {
        return (cValue);
    } else {
        float F=((float) cValue)/10 * 1.8 + 32;
        return (int16_t(F*10+0.5));
    }
} 

int16_t CStmApp::getTOffset(uint8_t tIdx)
{
    int16_t result = 0;
    if (tIdx>0) {
        result = VdmConfig.configFlash.tempsConfig.tempConfig[tIdx].offset;
    } 
    return (result); 
}

bool CStmApp::checkNewTarget() {
    for (uint8_t i=0; i<ACTUATOR_COUNT; i++) {
        if (VdmConfig.configFlash.valvesConfig.valveConfig[i].active) {
            // check if target has changed
            if(target_position_mirror[i] != actuators[i].target_position) return (true);
        }
    }
    return (false);
}

void CStmApp::valvesCalibration(uint8_t index)
{
    app_cmd(APP_PRE_SETVLLEARN,String(index));
    time_t now;
    time (&now);
    VdmConfig.miscValues.lastCalib=now;
    VdmConfig.writeMiscValues();
}

void CStmApp::valvesAssembly(uint8_t index)
{
    app_cmd(APP_PRE_SETALLVLVOPEN, String(index));
}

void CStmApp::valvesDetect()
{
    app_cmd(APP_PRE_SETDETECTVLV, "255");
}


void CStmApp::getParametersFromSTM()
{
    stmInitState=STM_INIT_STARTED;
    fastQueueMode=true;  
    app_cmd(APP_PRE_GETVERSION);
    app_cmd(APP_PRE_GETHWINFO);
    app_cmd(APP_PRE_GETMOTCHARS);
    app_cmd(APP_PRE_GETLEARNMOVEM);
    app_cmd(APP_PRE_GETONEWIRECNT,String(255));
    app_cmd(APP_PRE_GETONEWIRESETT,String(255));
    app_cmd(APP_PRE_GETVLSTATUS);
    fastGetOneWire=true;
}

// soft reset of STM32 ensures that eeprom content is saved before restart
void CStmApp::softReset()
{   
    if (VdmConfig.configFlash.netConfig.syslogLevel>=VISMODE_DETAIL) {
        syslog.log(LOG_DEBUG, "stmApp: soft reset of STM32");
    }
    #ifdef EnvDevelop
        UART_DBG.println("stmApp: send soft reset command");
    #endif
    app_cmd(APP_PRE_SOFTRESET);
}

void CStmApp::scanTemps()
{
    tempsCount=0;
    for (uint8_t i=0;i<TEMP_SENSORS_COUNT;i++) {
        memset(tempsId[i].id,0x0,sizeof(tempsId[i].id));
    }
    app_cmd(APP_PRE_SETONEWIRESEARCH);
}

void CStmApp::matchSensors()
{
    if (VdmConfig.configFlash.netConfig.syslogLevel>=VISMODE_DETAIL) {
        syslog.log(LOG_DEBUG, "stmApp: send match sensor request");
    }
    #ifdef EnvDevelop
        UART_DBG.println("stmApp: send match sensor request");
    #endif
    app_cmd(APP_PRE_MATCHSENS);      
}

void CStmApp::setTempIdx()
{
    String s1;
    String s2;
    uint8_t tIdx1;
    uint8_t tIdx2;
    
    for (uint8_t i=0;i<ACTUATOR_COUNT;i++) {
        tIdx1=StmApp.actuators[i].tIdx1;
        tIdx2=StmApp.actuators[i].tIdx2;
        s1=APP_PRE_UNDEFSENSOR;
        s2=APP_PRE_UNDEFSENSOR;
        if (tIdx1>0) {
            if (strlen(VdmConfig.configFlash.tempsConfig.tempConfig[tIdx1-1].ID)>0) {
                s1=VdmConfig.configFlash.tempsConfig.tempConfig[tIdx1-1].ID;
            }   
        }
        if (tIdx2>0) {
            if (strlen(VdmConfig.configFlash.tempsConfig.tempConfig[tIdx2-1].ID)>0) {
                s2=VdmConfig.configFlash.tempsConfig.tempConfig[tIdx2-1].ID; 
            }
        }
        
        waitForFinishQueue=true;
        fastQueueMode=true;
        waitEEPFinished=true;
        UART_DBG.println("tIdx : "+String(i+1)+"="+String(tIdx1)+":"+s1+","+String(tIdx2)+s2);
        app_cmd(APP_PRE_SETVLVSENSOR,String(i)+ARG_DELIMITER+s1+ARG_DELIMITER+s2);

        fastQueueMode=true;

        if (VdmConfig.configFlash.netConfig.syslogLevel>=VISMODE_DETAIL) {
            syslog.log(LOG_DEBUG,"stmApp: "+String(APP_PRE_SETVLVSENSOR)+" "+String(i)+ARG_DELIMITER+s1+ARG_DELIMITER+s2);
        }
    }
    fastQueueMode=true;
}

void CStmApp::setLearnAfterMovements()
{
    waitForFinishQueue=true;
    waitEEPFinished=true;
    app_cmd(APP_PRE_SETLEARNMOVEM,String(learnAfterMovements));
    fastQueueMode=true;   
}

void CStmApp::setMotorChars()
{
    waitForFinishQueue=true;
    waitEEPFinished=true;
    app_cmd(APP_PRE_SETMOTCHARS,String(motorChars.maxLowCurrent)+ARG_DELIMITER+String(motorChars.maxHighCurrent)+
        ARG_DELIMITER+String(motorChars.startOnPower)+ARG_DELIMITER+String(motorChars.noOfMinCount)+ARG_DELIMITER+String(motorChars.maxCalReps));   
    fastQueueMode=true;
}

void  CStmApp::app_loop() 
{
    static int match_counter = 0;

    app_check_data();
    appHandler();

    // maybe find a better place for this code
    if(matchSensorRequest == true) {
        match_counter++;
        if (match_counter > 30) {
            match_counter = 0;
            matchSensorRequest = false;
            matchSensors();
        }
    }
}

bool CStmApp::checkCmdIsAvailable (String thisCmd)
{   
    uint8_t i=0;
    while (commCmds[i] != NULL) {
        if (memcmp((const char*) &thisCmd,commCmds[i],5)==0) {
            return(true);
        }
        i++;
    }
    #ifdef EnvDevelop
        UART_DBG.println("Command not found "+String(thisCmd));
    #endif
    return (false);
}

void  CStmApp::app_cmd(String command,String args) 
{    
    if (checkCmdIsAvailable(command)) {
        String s=command+ARG_DELIMITER;
        if (args!="") s+=args+ARG_DELIMITER;
        #ifdef EnvDevelop
            UART_DBG.println("push "+s);
        #endif
        Queue.push(s);
    }
    else {
        if (VdmConfig.configFlash.netConfig.syslogLevel>=VISMODE_ATOMIC) {
            syslog.log(LOG_DEBUG, "STMApp: app_cmd - command not found");
        }
    }
}

int8_t CStmApp::findTempID(char* ID) 
{
    for (uint8_t i=0;i<TEMP_SENSORS_COUNT;i++) {
        if (strlen(VdmConfig.configFlash.tempsConfig.tempConfig[i].ID)>0) {
            if (strncmp(ID,VdmConfig.configFlash.tempsConfig.tempConfig[i].ID,sizeof(VdmConfig.configFlash.tempsConfig.tempConfig[i].ID))==0) {
            return (i);
            }
        }
    }
    return -1;
}

int8_t CStmApp::findTempIdxInValve (uint8_t tempIdx)
{
  uint8_t idx=0;
  for (uint8_t i=0;i<ACTUATOR_COUNT;i++) {
    if ((StmApp.actuators[i].tIdx1==tempIdx+1) || (StmApp.actuators[i].tIdx2==tempIdx+1)) return (i);
  }
  return (-1);
}


void CStmApp::setSensorIndex(uint8_t valveIndex,char* sensor1,char* sensor2)
{
    int8_t sensorIdx;
    sensorIdx=findTempID(sensor1);
    if (sensorIdx>=0) actuators[valveIndex].tIdx1=sensorIdx+1; else actuators[valveIndex].tIdx1=0;
    sensorIdx=findTempID(sensor2);
    if (sensorIdx>=0) actuators[valveIndex].tIdx2=sensorIdx+1; else actuators[valveIndex].tIdx2=0;
}

void  CStmApp::app_check_data() 
{
    static int errorcnt = 0;
    int availcnt;
    uint8_t noToken;
    uint8_t val8;

    #ifdef STMSimulation
        #warning STMSimulation active
        appState=APP_IDLE;  
        stmStatus=STM_READY; 
        cmd_buffer=""; 
        return;
    #endif

    availcnt = UART_STM32.available();
    found=false;
 
    if (availcnt > 0) {

        for (int c = 0; c < availcnt; c++)
        {           
            *bufptr++ = (char) UART_STM32.read();
            buflen++;  
        }
        if (buflen>=sizeof(buffer)-1) {
            *bufptr='\r';
        }        
    }  

    // if there is a little in the buffer
    if(buflen >= 5) 
    {
        for (uint16_t c = 0; c < buflen; c++)
        {     
            if (buffer[c] == '\r') {
                errorcnt = 0;
                buffer[c] = '\0';
                found = true;
                buflen = 0;         // reset counter
                bufptr = buffer;    // reset ptr    
                UART_STM32.read();  // read possible \n
                if (VdmConfig.configFlash.netConfig.syslogLevel>=VISMODE_ATOMIC) {
                    syslog.log(LOG_DEBUG, "STMApp:found new data packet: >" + String(buffer) + "<");
                }
            }
        }
        
        // timeout incomplete recv sequences
        if (!found) errorcnt++;
        if (errorcnt > 5) {
            syslog.log(LOG_DEBUG, "incomplete buffer : >" + String(buffer) + "<");

            errorcnt = 0;
            buflen = 0;
            bufptr = buffer;            
        }
    }
   
    if(!found) 
    {
        //syslog.log(LOG_DEBUG, "incomplete buffer : >" + String(buffer) + "<");
    }
    else 
    {
        found = false;

        if (stmStatus==STM_NOT_READY) stmStatus=STM_READY;
         
        // devide buffer into command and data
		// ****************************************

        cmdptr = buffer;
        argcnt = 0;
        noToken = 0;
        //UART_DBG.println("cmdbuffer "+String(cmdptr));

        // Returns first token
        char *token = strtok(cmdptr, " ");
        strncpy(cmd,token,sizeof(cmd)-1);		// command
        // Keep get tokens while one of the
        // delimiters present in buffer.
        //UART_DBG.println("token1 "+String(token));
        while (token != NULL)
        {
            if (noToken>0) { 
                //UART_DBG.println("token "+String(token));
                memset (argptr[noToken-1],0x0,argSize[noToken-1]);
                strncpy(argptr[noToken-1],token,argSize[noToken-1]-1); 
                argcnt++;
            }
            token = strtok(NULL, " ");
            noToken++;
            if (noToken>noOfArgs) break;
        }

		// get actual values
		// ++++++++++++++++++++++++++++++++++++++++++++++++++++++++++++++++++++++++
		if(memcmp(APP_PRE_GETACTUALPOS,cmd,5) == 0) {
            if(argcnt == 2) {
                if (VdmConfig.configFlash.netConfig.syslogLevel>=VISMODE_DETAIL) {
                    syslog.log(LOG_DEBUG,"STMApp:actual position answer "+String(argptr[0])+" : "+String(argptr[1]));
                }
                actuators[atoi(argptr[0])].actual_position = atoi(argptr[1]);
            }
            appState=APP_IDLE;
        }

        // get mean current 
		// ++++++++++++++++++++++++++++++++++++++++++++++++++++++++++++++++++++++++
		else if(memcmp(APP_PRE_GETMEANCURR,cmd,5) == 0) {
            if(argcnt == 2) {
                if (VdmConfig.configFlash.netConfig.syslogLevel>=VISMODE_DETAIL) {
                    syslog.log(LOG_DEBUG,"STMApp:mean current answer "+String(argptr[0])+" : "+String(argptr[1]));  
                }
                actuators[atoi(argptr[0])].meancurrent = atoi(argptr[1]);
            }
            appState=APP_IDLE;
        }
    
        // get valve status
		// ++++++++++++++++++++++++++++++++++++++++++++++++++++++++++++++++++++++++
		else if(memcmp(APP_PRE_GETVLSTATUS,cmd,5) == 0) { 
            if(argcnt == 2) {
                if (VdmConfig.configFlash.netConfig.syslogLevel>=VISMODE_DETAIL) {
                    syslog.log(LOG_DEBUG,"STMApp:valve status "+String(argptr[1]));
                }
                uint8_t nActuators = atoi(argptr[0]);
                char* cmdptr;
                char* ps=argptr[1];
                for (uint8_t idx=0; idx<nActuators;idx++) {
                    if ((cmdptr=strchr(ps,','))!=NULL) *cmdptr='\0';
                    val8 = atoi(ps);
                    actuators[idx].state = (val8 & 0x7f);
                    actuators[idx].calibration =  (val8>=0x80);
                    if (cmdptr!=NULL) ps=cmdptr+1;
                    idx++;
                }  
                stmStatus=STM_READ_ALL_FROM_QUEUE;  
                if (stmInitState==STM_INIT_STARTED) stmInitState=STM_INIT_FINISHED ;
            }
            appState=APP_IDLE;
        }

        // get set target answer
		// ++++++++++++++++++++++++++++++++++++++++++++++++++++++++++++++++++++++++
		else if(memcmp(APP_PRE_SETTARGETPOS,cmd,5) == 0) {
            if(argcnt == 0) {
                settarget_check = true; 
            }
            if (memcmp(cmd,(const void*) &cmd_buffer,5) ==0) cmd_buffer="";
            appState=APP_IDLE;
        }
        // get target position
            // ++++++++++++++++++++++++++++++++++++++++++++++++++++++++++++++++++++++++
            else if(memcmp(APP_PRE_GETTARGETPOS,cmd,5) == 0) {
                if(argcnt == 2) {
                    actuators[atoi(argptr[0])].target_position = atoi(argptr[1]);
                }
                appState=APP_IDLE;
            }

        // get data values
		// ++++++++++++++++++++++++++++++++++++++++++++++++++++++++++++++++++++++++
		else if(memcmp(APP_PRE_GETVLVDATA,cmd,5) == 0) {
            if(argcnt >= 6) {
                uint8_t idx=atoi(argptr[0]);
                if(idx < ACTUATOR_COUNT) {
                    actuators[idx].actual_position = atoi(argptr[1]);
                    actuators[idx].meancurrent = atoi(argptr[2]);
                    val8 = atoi(argptr[3]);
                    actuators[idx].state = (val8 & 0x7f);
                    actuators[idx].calibration = (val8>=0x80);
                    actuators[idx].temp1 = ConvertCF(atoi(argptr[4]))+getTOffset(actuators[idx].tIdx1);
                    actuators[idx].temp2 =  ConvertCF(atoi(argptr[5]))+getTOffset(actuators[idx].tIdx2);
                    if (argcnt >= 10) {
                        actuators[idx].movements = atoi(argptr[6]);   
                        actuators[idx].opening_count = atoi(argptr[7]);
                        actuators[idx].closing_count = atoi(argptr[8]);
                        actuators[idx].deadzone_count = atoi(argptr[9]); 
                    }
                    if (argcnt >= 11) {
                        actuators[idx].calibRetries = atoi(argptr[10]); 
                    }
                    if (VdmConfig.configFlash.netConfig.syslogLevel>=VISMODE_DETAIL) {
                        syslog.log(LOG_DEBUG, "STMApp:got valve data #"+String(argptr[0])+" pos:"+String(argptr[1])+
                        " mean:"+String(argptr[2])+" state:"+String(argptr[3])+" t1:"+String(argptr[4])+" t2:"+String(argptr[5]));
                    }

                    if (actuators[idx].state!=actuators[idx].lastState) {
                        switch (actuators[idx].state) {
                            case VLV_STATE_OPENING:
                            case VLV_STATE_CLOSING:
                            {
                                actuators[idx].worked = true;
                                break;    
                            }
                            case VLV_STATE_FAILED:
                            {
                                if (VdmConfig.configFlash.messengerConfig.reason.reasonFlags.valveFailed) {
                                    String title = String(VdmConfig.configFlash.systemConfig.stationName) + " : Valve" ;
                                    String s = "Valve "+String(idx+1)+" failed";
                                    Messenger.sendMessage (title.c_str(),s.c_str());
                                }
                                break;
                            }
                            case VLV_STATE_OPENCIR:
                            {
                                if ((actuators[idx].worked) && (VdmConfig.configFlash.valvesConfig.valveConfig[idx].active)) { // has previous worked correctly
                                    if (VdmConfig.configFlash.messengerConfig.reason.reasonFlags.notDetect) {
                                        String title = String(VdmConfig.configFlash.systemConfig.stationName) + " : Valve" ;
                                        String s = "Valve "+String(idx+1)+" is not connected";
                                        Messenger.sendMessage (title.c_str(),s.c_str());
                                    }
                                }
                                break;
                            }
                            case VLV_STATE_BLOCKS:
                            {
                                if (VdmConfig.configFlash.messengerConfig.reason.reasonFlags.valveBlocked) {
                                    String title = String(VdmConfig.configFlash.systemConfig.stationName) + " : Valve" ;
                                    String s = "Valve "+String(idx+1)+" is blocked";
                                    Messenger.sendMessage (title.c_str(),s.c_str());
                                }
                                break;
                            }
                        } 
                    }
                    actuators[idx].lastState=actuators[idx].state;
                }
            } 
            appState=APP_IDLE;
        }

        // get onewire data answer
		// ++++++++++++++++++++++++++++++++++++++++++++++++++++++++++++++++++++++++
        
        else if(memcmp(APP_PRE_GETONEWIRECNT,cmd,5) == 0) {
            if(argcnt == 1) {
                tempsPrivCount= atoi(argptr[0]); 
                if (tempsPrivCount!=tempsCount) app_cmd(APP_PRE_GETONEWIRECNT,String(255));
                if (VdmConfig.configFlash.netConfig.syslogLevel>=VISMODE_DETAIL) {
                    syslog.log(LOG_DEBUG,"STMApp:one wire count "+String(tempsPrivCount));
                }       
            }
            if(argcnt == 2) {
                if (VdmConfig.configFlash.netConfig.syslogLevel>=VISMODE_DETAIL) {
                    syslog.log(LOG_DEBUG,"STMApp:one wire data "+String(argptr[1]));
                } 
                tempsPrivCount= atoi(argptr[0]);
                if (tempsPrivCount>0) {
                    char* cmdptr;
                    char* ps=argptr[1];
                    for (uint8_t idx=0; idx<tempsPrivCount;idx++) {
                        if ((cmdptr=strchr(ps,','))!=NULL) *cmdptr='\0';
                        strncpy(tempsId[idx].id,ps,sizeof(tempsId[idx].id));
                        ps=cmdptr+1;
                        idx++;
                    }
                }
                tempsCount=tempsPrivCount;
            }
            if (tempsPrivCount==0) {
                fastGetOneWire=false;
               // oneWireAllRead=true;
            }
            appState=APP_IDLE;
        }

		else if(memcmp(APP_PRE_GETONEWIREDATA,cmd,5) == 0) {
            if(argcnt == 2) {
                if (VdmConfig.configFlash.netConfig.syslogLevel>=VISMODE_DETAIL) {
                    syslog.log(LOG_DEBUG,"STMApp:one wire data "+String(argptr[0])+":"+String(argptr[1]));
                } 
                strncpy(tempsId[tempIndex].id,argptr[0],sizeof(tempsId[tempIndex].id));

                int8_t idx=findTempID(argptr[0]);
                if (idx>=0) {
                    memset(temps[idx].id,0x0,sizeof(temps[idx].id)); 
                    strncpy(temps[idx].id,argptr[0],sizeof(temps[idx].id));
                    int16_t cValue=atoi(argptr[1]);
                    temps[idx].temperature=ConvertCF(cValue)+VdmConfig.configFlash.tempsConfig.tempConfig[idx].offset;
                } 
                tempIndex++;
                
                if (tempIndex>=tempsCount) {  // all temp sensors read
                    tempIndex=0;
                    fastGetOneWire=false;
                    if (VdmTask.piTaskInitiated) oneWireAllRead=true;
                }
                #ifdef AppDebug
                    UART_DBG.println("read onwire "+String(tempIndex)+":"+String(fastGetOneWire));
                #endif
            }
            // handle incomplete messages to not block 1-wire request cycle
            else if(argcnt == 1) {
                if (VdmConfig.configFlash.netConfig.syslogLevel>=VISMODE_DETAIL) {
                    syslog.log(LOG_DEBUG,"STMApp:one wire data - only 1 arg");
                }
                tempIndex++;
                if (tempIndex>=tempsCount) {  // all temp sensors read
                    tempIndex=0;
                    fastGetOneWire=false;
                    if (VdmTask.piTaskInitiated) oneWireAllRead=true;
                }
            }
            appState=APP_IDLE;
        }

        else if(memcmp(APP_PRE_GETVERSION,cmd,5) == 0) {
            if(argcnt > 0) {
                VdmSystem.stmVersion=argptr[0]; 
                VdmSystem.stmBuild=0;
            }
            if(argcnt > 1) {
                 VdmSystem.stmBuild=atoi(argptr[1]);
            }
            if (memcmp(cmd,(const void*) &cmd_buffer,5) ==0) cmd_buffer="";
            appState=APP_IDLE;
        }

        else if(memcmp(APP_PRE_GETHWINFO,cmd,5) == 0) {
            if(argcnt > 0) {
                VdmSystem.stmID=atoi(argptr[0]); 
            }
            if (memcmp(cmd,(const void*) &cmd_buffer,5) ==0) cmd_buffer="";
            appState=APP_IDLE;
        }

        else if(memcmp(APP_PRE_GETONEWIRESETT,cmd,5) == 0) {
            if(argcnt == 3) {
                setSensorIndex(atoi(argptr[0]),argptr[1],argptr[2]);
            }
            if(argcnt == 2) {
                if (VdmConfig.configFlash.netConfig.syslogLevel>=VISMODE_DETAIL) {
                    syslog.log(LOG_DEBUG,"STMApp:one wire settings data "+String(argptr[0])+" : "+String(argptr[1]));
                }   
                uint8_t nItems= atoi(argptr[0]);
                if (nItems>0) {
                    char* cmdptr;
                    char* ps=argptr[1];
                    
                    for (uint8_t idx=0; idx<nItems;idx++) {
                        if ((cmdptr=strchr(ps,','))!=NULL) *cmdptr='\0';
                        strncpy(argptr[4],ps,argSize[4]);
                        if (cmdptr!=NULL) ps=cmdptr+1;
                        if ((cmdptr=strchr(ps,','))!=NULL) *cmdptr='\0';
                        strncpy(argptr[5],ps,argSize[5]); 
                        setSensorIndex(idx,argptr[4],argptr[5]);
                        if (cmdptr!=NULL) ps=cmdptr+1;
                        
                    }
                }
                
            }  
            appState=APP_IDLE;
        }
        
        else if(memcmp(APP_PRE_SETONEWIRESEARCH,cmd,5) == 0) {
            appState=APP_IDLE;
        }

        else if(memcmp(APP_PRE_SETLEARNMOVEM,cmd,5) == 0) {
            appState=APP_IDLE;
        }

        else if(memcmp(APP_PRE_GETLEARNMOVEM,cmd,5) == 0) {
            if(argcnt == 1) {
                learnAfterMovements=atoi(argptr[0]);
            }
            appState=APP_IDLE;
        }

        else if(memcmp(APP_PRE_SETVLVSENSOR,cmd,5) == 0) {
            appState=APP_IDLE;
        }

        else if(memcmp(APP_PRE_SETALLVLVOPEN,cmd,5) == 0) {
            appState=APP_IDLE;
        }

        else if(memcmp(APP_PRE_SETVLLEARN,cmd,5) == 0) {
            appState=APP_IDLE;
        }
        
        else if(memcmp(APP_PRE_SETDETECTVLV,cmd,5) == 0) {
            appState=APP_IDLE;
        }

        else if(memcmp(APP_PRE_SETMOTCHARS,cmd,5) == 0) {
            appState=APP_IDLE;
        }

        else if(memcmp(APP_PRE_GETMOTCHARS,cmd,5) == 0) {
            if(argcnt >= 2) {
                motorChars.maxLowCurrent=atoi(argptr[0]);
                motorChars.maxHighCurrent=atoi(argptr[1]);
            }
            if(argcnt >= 3) {
                motorChars.startOnPower=atoi(argptr[2]);
                setupStartPosition(motorChars.startOnPower);
            }
            if(argcnt >= 4) {
                motorChars.noOfMinCount=atoi(argptr[3]);
            }
            if(argcnt == 5) {
                motorChars.maxCalReps=atoi(argptr[4]);
            }
            appState=APP_IDLE;
        }
        else if(memcmp(APP_PRE_EEPSTATE,cmd,5) == 0) {
            if(argcnt == 1) {
                bool getEEState=atoi(argptr[0]);
                #ifdef EnvDevelop
                    UART_DBG.println("get eeprom state "+ String(getEEState));
                #endif
                if ((eepState==EEP_REQUEST) && (getEEState)) eepState=EEP_DONE; 
            }
            appState=APP_IDLE;
        }

        // match sensors request
		// ++++++++++++++++++++++++++++++++++++++++++++++++++++++++++++++++++++++++
		else if(memcmp(APP_PRE_MATCHSENS,&cmd[0],5) == 0) {			
            if (VdmConfig.configFlash.netConfig.syslogLevel>=VISMODE_DETAIL) {
                syslog.log(LOG_DEBUG, "stmApp: got match sensor answer");
            }
            appState=APP_IDLE;
		}

        // very important to reset to idle if no valid command was found
        else {
            if (VdmConfig.configFlash.netConfig.syslogLevel>=VISMODE_DETAIL) {
                syslog.log(LOG_DEBUG, "unknown command: >" + String(cmd) + "<");
            }
            appState=APP_IDLE;
        }

        cmd_buffer="";
        buffer[0] = '\0';
    }
}


void CStmApp::appHandler()
{
    switch (appState) {
        case APP_IDLE: 
            appRetry=0;   
            app_comm_machine();
            break;
        
        case APP_PENDING: 
            appRetry ++;
            if (VdmConfig.configFlash.netConfig.syslogLevel>=VISMODE_DETAIL) {		
                syslog.log(LOG_DEBUG,"STMApp:App retries "+String(appRetry)+String(":")+String(commstate));
            }
            if (appRetry>maxAppRetries) {
                appState=APP_TIMEOUT;
                appRetry=0;
                if (VdmConfig.configFlash.netConfig.syslogLevel>=VISMODE_DETAIL) {		
                    syslog.log(LOG_DEBUG,"STMApp:Max app retries reached, set app to timeout");
                }
            }
            break;
        
        case APP_TIMEOUT:
            appTimeOuts++;
            if (appTimeOuts>maxAppTimeOuts) {
                if (VdmConfig.configFlash.netConfig.syslogLevel>=VISMODE_DETAIL) {		
                    syslog.log(LOG_DEBUG,"STMApp:Max app timeouts reached, reset STM");
                } 
                VdmSystem.setSystemState(systemStateError,systemMsgSTMReset);
                appTimeOuts=0; 
                Stm32.ResetSTM32(true);
                Messenger.sendMessage ("STM failed","STM failed: max app timeouts reached, reset STM"); 
                appState=APP_IDLE; 
            } else {
                commstate = COMM_GETDATA;
                app_comm_machine();   
            } 
            break;
        
        default:    
            appState=APP_IDLE;
            break;
    }
}

void CStmApp::app_comm_send(String thisAppCmd,uint8_t * value1,uint8_t * value2) 
{
    char valbuffer[20];
    memset(sendbuffer,0x0,sizeof(sendbuffer));
    strncat(sendbuffer,thisAppCmd.c_str(),sizeof(sendbuffer) - strlen (sendbuffer) - 1);
    strncat(sendbuffer," ",sizeof(sendbuffer) - strlen (sendbuffer) - 1);
    if (value1!=NULL) {
        itoa(*value1, valbuffer, 10);
        strncat(sendbuffer,valbuffer,sizeof(sendbuffer) - strlen (sendbuffer) - 1);
        strncat(sendbuffer," ",sizeof(sendbuffer) - strlen (sendbuffer) - 1);
        if (value2!=NULL) {
            itoa(*value2, valbuffer, 10);
            strncat(sendbuffer,valbuffer,sizeof(sendbuffer) - strlen (sendbuffer) - 1);
            strncat(sendbuffer," ",sizeof(sendbuffer) - strlen (sendbuffer) - 1);
        }
    }
    UART_STM32.println(sendbuffer);   
}

void  CStmApp::app_comm_machine()
{
    char valbuffer[10];

    switch(commstate) {

        case COMM_IDLE: 
                appState=APP_IDLE;
                if (checkNewTarget()) {
                    commstate = COMM_SENDTARGET;
                } else {
                    commstate = COMM_GETDATA;
                }
                break;

        // send target position values
        case COMM_SENDTARGET:
                commstate = COMM_GETDATA;
                
                for (uint8_t x=0; x<ACTUATOR_COUNT; x++) {
                    if (VdmConfig.configFlash.valvesConfig.valveConfig[x].active) {
                        // check if target has changed
                        if(target_position_mirror[x] != actuators[x].target_position)
                        {
                            target_position_mirror[x] = actuators[x].target_position;
                            if (VdmConfig.configFlash.netConfig.syslogLevel>=VISMODE_DETAIL) {
                                syslog.log(LOG_DEBUG, "STMApp:valve position has changed : "+String(VdmConfig.configFlash.valvesConfig.valveConfig[x].name)+"(#"+String(x+1)+") = "+String(actuators[x].target_position));
                            }
                            settarget_check=false;
                           
                            app_comm_send(APP_PRE_SETTARGETPOS,&x, &(actuators[x].target_position));
                            #ifdef EnvDevelop
                                UART_DBG.println("valve position has changed : "+String(x)+" = "+String(actuators[x].target_position));
                            #endif
                            // break loop, next valve will be served in next cycle
                            appState=APP_PENDING;
                            break;

                            timeout = 10;
                        }   
                    }
                }
                
                break;

        // check correct transmission of target value
        case COMM_CHECKTARGET:
                if (timeout>0) timeout--;
                else {
                    // answer received
                    if (settarget_check) {                        
                        commstate = COMM_GETDATA; 
                    }
                    else {
                        if (retry>0) retry--;
                        else commstate = COMM_GETDATA; 
                        commstate = COMM_SENDTARGET;
                    }
                }
                
                break;

        case COMM_GETDATA:  
                if (eepState!=EEP_IDLE) {
                    commstate =  COMM_GETEEPSTATE;
                } else {
                    commstate =  COMM_GETONEWIRECOUNT;
                }
                // walk through all valves, one per cycle
                if (getindex<ACTUATOR_COUNT-1) getindex++; else getindex=0;
               
                app_comm_send(APP_PRE_GETVLVDATA,&getindex);

                if (VdmConfig.configFlash.netConfig.syslogLevel>=VISMODE_DETAIL) {
                    syslog.log(LOG_DEBUG, "STMApp cmd = "+String(sendbuffer));
                }
                appState=APP_PENDING;
                break;

        case COMM_GETEEPSTATE :
            #ifdef EnvDevelop
                UART_DBG.println("request eeprom state");
            #endif
            app_comm_send(APP_PRE_EEPSTATE);
            appState=APP_PENDING;
            break;

        case COMM_GETONEWIRECOUNT:
                if (tempsPrivCount>0) {
                    commstate = COMM_GETONEWIRE;
                } else {
                    commstate =  COMM_HANDLEQUEUE;   
                }
                if (checkTempsCount==0) {
                    app_comm_send(APP_PRE_GETONEWIRECNT);
                    checkTempsCount=20;
                    appState=APP_PENDING;

                    if (VdmConfig.configFlash.netConfig.syslogLevel>=VISMODE_DETAIL) {
                        syslog.log(LOG_DEBUG,"get one wire count");
                    } 
                }    
                checkTempsCount--;
                break;

        case COMM_GETONEWIRE:
            if (!fastGetOneWire) commstate = COMM_HANDLEQUEUE;
                if (tempsPrivCount>0) {
                    app_comm_send(APP_PRE_GETONEWIREDATA,&tempIndex);
                    appState=APP_PENDING;

                    if (VdmConfig.configFlash.netConfig.syslogLevel>=VISMODE_DETAIL) {
                        syslog.log(LOG_DEBUG,"get one wire data: " + String(sendbuffer));
                    } 
                }
                break;

        case COMM_HANDLEQUEUE:
                if ((cmd_buffer=="") && (Queue.available()>0) && (stmStatus>=STM_READY)) {
                    memset(&cmd_buffer,0x0,sizeof(cmd_buffer));
                    cmd_buffer=Queue.pop();
                    #ifdef EnvDevelop
                        UART_DBG.println("pop "+String(cmd_buffer));
                    #endif
                    UART_STM32.println(cmd_buffer);
                    appState=APP_PENDING;
                }
                if (fastQueueMode) {
                    if (Queue.available()==0) {
                        fastQueueMode=false;
                        commstate = COMM_IDLE;
                    }
                } else commstate =COMM_IDLE;
                
                break;
        
        default:    
                commstate = COMM_IDLE;
                break;
    }
}
