Lenti84/VdMot_Controller/software_esp32/include/stmApp.h

/**HEADER*******************************************************************
  project : VdMot Controller

  author : SurfGargano, Lenti84

  Comments:

  Version :

  Modifcations :


***************************************************************************
*
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
  Copyright (C) 2021 Lenti84  https://github.com/Lenti84/VdMot_Controller

*END************************************************************************/


#include "globals.h"

#pragma once

typedef struct  {
	uint8_t   actual_position;      // from controller
  uint8_t   target_position;      // to controller
  uint8_t   state;                // from controller
  uint16_t  meancurrent;          // from controller
  uint8_t   tIdx1;
  int       temp1;                // temperature of 1st assigned sensor
  uint8_t   tIdx2;
  int       temp2;                // temperature of 2nd assigned sensor
  uint8_t   lastState;
  bool      worked;
  bool      calibration;
  uint32_t  movements;
  uint32_t  opening_count;
  uint32_t  closing_count;
  int32_t   deadzone_count;
  uint8_t   calibRetries;
} ACTUATOR_STRUC;

typedef struct  {
  int16_t   temperature;          // temperature of assigned sensor
  char id[25];
} TEMP_STRUC;

typedef struct  {
  char id[25];
} TEMPID_STRUC;

typedef struct {
  uint16_t maxHighCurrent;
  uint16_t maxLowCurrent;
  uint8_t startOnPower;
  uint16_t noOfMinCount;
  uint8_t maxCalReps;
} MOTOR_CHARS;


#define APP_PRE_SETTXENA			      "stxen"   // not used in stm
#define APP_PRE_GETSUPPLYSENS		    "gspst"   // not used in stm
#define APP_PRE_SETSENSORINDEX		  "stsnx"   // not used in stm


#define APP_PRE_SETTARGETPOS       	"stgtp"			
#define APP_PRE_GETONEWIRECNT		    "gonec"			
#define APP_PRE_GETONEWIREDATA		  "goned"	
#define APP_PRE_SETONEWIRESEARCH    "stons"		
#define APP_PRE_SET1STSENSORINDEX	  "stsnx"   		
#define APP_PRE_SET2NDSENSORINDEX	  "stsny"			
#define APP_PRE_SETALLVLVOPEN		    "staop"			
#define APP_PRE_GETONEWIRESETT		  "gvlon"	  	
#define APP_PRE_GETVLVDATA			    "gvlvd"			
#define APP_PRE_SETVLLEARN          "staln"   // one valve
#define APP_PRE_SETLEARNMOVEM       "stlnm" 
#define APP_PRE_GETLEARNMOVEM       "gtlnm"
#define APP_PRE_GETVLSTATUS         "gvlst"   

#define APP_PRE_GETVERSION			    "gvers"
#define APP_PRE_GETHWINFO 			    "ghwin"   
#define APP_PRE_GETTARGETPOS       	"gtgtp"			

#define APP_PRE_SETMOTCHARS         "smotc"
#define APP_PRE_GETMOTCHARS         "gmotc"

#define APP_PRE_GETACTUALPOS       	"gactp"   // not used in stm
#define APP_PRE_GETMEANCURR        	"gmenc"   // not used in stm
#define APP_PRE_GETSTATUS          	"gstat"   // not used in stm

#define APP_PRE_SETVLVSENSOR        "stvls"
#define APP_PRE_SETDETECTVLV        "stdet"     

#define APP_PRE_MATCHSENS           "masns"     
#define APP_PRE_SOFTRESET           "reset"     
#define APP_PRE_EEPSTATE            "eepst"     // new eeprom state : 1 = ready, 0 = write pending

#define APP_PRE_UNDEFSENSOR         "00-00-00-00-00-00-00-00"

#define VLV_STATE_START       0x00
#define VLV_STATE_IDLE        0x01 // nothing to do
#define VLV_STATE_OPENING     0x02 // opens
#define VLV_STATE_CLOSING     0x03 // closes
#define VLV_STATE_FAILED      0x04 // failed (e.g jump away)
#define VLV_STATE_UNKNOWN     0x05 // initial state
#define VLV_STATE_OPENCIR     0x06 // open circuit detected, no valve connected
#define VLV_STATE_FULLOPEN    0x07 // go directly full open
#define VLV_STATE_CONNECTED   0x08 // valve is connected
#define VLV_STATE_BLOCKS      0x09 // valve is blocked


#define COMM_ALIVE_CYCLE      30        // send "Alive" cycle in 100 ms cycles

#define ARG_DELIMITER       String(" ")

enum COMM_STATE {COMM_IDLE,COMM_SENDTARGET,COMM_CHECKTARGET,COMM_GETDATA,
                  COMM_GETONEWIRE,COMM_GETONEWIRECOUNT,COMM_GETEEPSTATE,COMM_HANDLEQUEUE};

enum STM_START_PROC {STM_NOT_READY,STM_READY,STM_READ_ALL_FROM_QUEUE};

enum STM_INIT_STATE {STM_INIT_NOT_STARTED,STM_INIT_STARTED,STM_INIT_FINISHED};

enum APP_STATE {APP_IDLE,APP_PENDING,APP_TIMEOUT};
enum EEP_STATE {EEP_IDLE,EEP_REQUEST,EEP_DONE};

#define maxAppRetries 100
#define maxAppTimeOuts 10

class CStmApp
{
public:
  CStmApp();
  void app_setup();
  void  setupStartPosition(uint8_t thisStartPosition);
  void app_loop();
  void app_check_data();
  void app_cmd(String command, String args="");
  bool checkCmdIsAvailable (String thisCmd);
  void valvesCalibration(uint8_t index);
  void valvesAssembly(uint8_t index);
  void valvesDetect();
  void scanValves();
  void scanTemps();
  void matchSensors();
  void setTempIdx();
  void setLearnAfterMovements();
  void setMotorChars();
  void getParametersFromSTM();
  void softReset();
  int8_t findTempID(char* ID);
  int8_t findTempIdxInValve (uint8_t tempIdx);
  
  ACTUATOR_STRUC actuators[ACTUATOR_COUNT];
  TEMP_STRUC temps[TEMP_SENSORS_COUNT];
  TEMPID_STRUC tempsId[TEMP_SENSORS_COUNT];
  uint8_t tempsCount;
  bool setTempIdxActive;
  bool waitForFinishQueue;
  MOTOR_CHARS motorChars;
  bool setMotorCharsActive;
  uint32_t learnAfterMovements;
  volatile STM_START_PROC stmStatus;
  volatile STM_INIT_STATE stmInitState;
  bool matchSensorRequest;
  EEP_STATE eepState;
  bool waitEEPFinished;
  bool oneWireAllRead;
  
private:
  void appHandler();
  void app_comm_machine();
  void app_comm_send(String thisAppCmd,uint8_t * value1=NULL,uint8_t * value2=NULL);
  void app_web_cmd_check();
  void setSensorIndex(uint8_t valveIndex,char* sensor1,char* sensor2); 
  int16_t ConvertCF(int16_t cValue);
  int16_t getTOffset(uint8_t tIdx);
  bool checkNewTarget();

  bool fastQueueMode;

  bool settarget_check;
  uint8_t target_position_mirror[ACTUATOR_COUNT];
  uint8_t getindex;

  uint8_t timeout;
  uint8_t retry;
  uint8_t cnt_alive;
  uint8_t appRetry;
  uint8_t appTimeOuts;

  APP_STATE appState;
  COMM_STATE commstate;    
  uint8_t tempIndex;
  uint8_t checkTempsCount;
  uint8_t tempsPrivCount;
  String cmd_buffer;
  
  char buffer[1200];
  char sendbuffer[50];
  char *bufptr;
  uint16_t buflen;
  int16_t availcnt;
  bool found;
  bool stmInitated;
  bool fastGetOneWire;
  
  char*   cmdptr;
  char*	  cmdptrend;

  #define noOfLargeArgs 2
  #define noOfSmallArgs 10
  #define noOfArgs noOfLargeArgs+noOfSmallArgs
  #define cmdSize 50
  #define largeArgSize 1200
  #define smallArgSize 30

  char  cmd[cmdSize];
  char	arg0[largeArgSize],	
        arg1[largeArgSize],		
        arg2[smallArgSize],
        arg3[smallArgSize],
        arg4[smallArgSize],
        arg5[smallArgSize],
        arg6[smallArgSize],
        arg7[smallArgSize],
        arg8[smallArgSize],
        arg9[smallArgSize],
        arg10[smallArgSize],
        arg11[smallArgSize];


  char *argptr[noOfArgs]={arg0,arg1,arg2,arg3,arg4,arg5,arg6,arg7,arg8,arg9,arg10,arg11};
  uint16_t argSize[noOfArgs]={sizeof(arg0),sizeof(arg1),sizeof(arg2),sizeof(arg3),sizeof(arg4),sizeof(arg5),sizeof(arg6),sizeof(arg7),sizeof(arg8),sizeof(arg9),sizeof(arg10),sizeof(arg11)};

	uint8_t	argcnt;
  
};

extern CStmApp StmApp;
