Lenti84/VdMot_Controller/software_esp32/src/ServerServices.cpp

/**HEADER*******************************************************************
  project : VdMot Controller

  author : SurfGargano, Lenti84

  Comments:

  Version :

  Modifcations :


***************************************************************************
*
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
  Copyright (C) 2021 Lenti84  https://github.com/Lenti84/VdMot_Controller

*END************************************************************************/


#include <stdint.h>
#include <VdmNet.h>
#include <WiFi.h>
#include <WiFiClient.h>

#include "globals.h"
#include "WT32AsyncOTA.h"

#include "web.h"
#include "tfs.h"

#include "time.h"

#include "stm32.h"
#include "stm32ota.h"
#include <ESPmDNS.h>
#include <WiFiUdp.h>
#include "ServerServices.h"
#include "VdmSystem.h"
#include "VdmTask.h"
#include "Services.h"
#include "stmApp.h"
#include "PIControl.h"
#include "Messenger.h"
#include "mqtt.h"

#include <FS.h>
#ifdef USE_LittleFS
  #define SPIFFS LittleFS
  #include <LITTLEFS.h> 
#else
  #include <SPIFFS.h>
#endif 

extern "C" {
  #include "tfs_data.h"
}


#include <AsyncJson.h>
#include <ArduinoJson.h>

AsyncWebServer server(80);

CServerServices ServerServices;

#define aj  "application/json"
#define tp  "text/plain"
#define th  "text/html"
#define gz  "Content-Encoding : gzip"

#define resOk "{\"res\":\"ok\"}"

// server handles --------------------------------------------------


void restart (JsonObject doc)
{  
  Services.restartSystem(false);
}

void writeConfig (JsonObject doc)
{  
  VdmConfig.writeConfig(true);
}

void resetConfig (JsonObject doc)
{  
  VdmConfig.resetConfig(true);
}

void restoreConfig (JsonObject doc)
{  
  VdmConfig.restoreConfig(true);
}

void setClearFS (JsonObject doc)
{  
  VdmTask.startClearFS();
}

void setGetFS (JsonObject doc)
{  
  VdmTask.startGetFS();
}

void fileDelete (JsonObject doc)
{  
  if (!doc["file"].isNull()) {
    VdmSystem.fileDelete(doc["file"]);
  }
}

void scanTSensors (JsonObject doc)
{  
  StmApp.scanTemps();
}

void valvesCalibration (JsonObject doc)
{  
  uint8_t index=255;
  if (!doc["valve"].isNull()) {
    index=(doc["valve"].as<uint8_t>());
    if (index!=255) index--;
  }
  StmApp.valvesCalibration(index);
}

void valvesAssembly (JsonObject doc)
{  
  uint8_t index=255;
  if (!doc["valve"].isNull()) {
    index=(doc["valve"].as<uint8_t>());
    if (index!=255) index--;
  }
  StmApp.valvesAssembly(index);
}

void valvesDetect (JsonObject doc)
{  
  StmApp.valvesDetect();
}

void writeValvesControl (JsonObject doc)
{  
  VdmConfig.writeValvesControlConfig(false,VdmTask.restartPiTask);
}

void mqttReconnect (JsonObject doc)
{  
  Mqtt.disconnect();
}

void sysLogSave (JsonObject doc)
{  
  VdmConfig.writeSysLogValues();
  VdmNet.syslogStarted=false;
  VdmNet.startSysLog();
}

void CServerServices::postSetValve (JsonObject doc)
{
  uint8_t index;
  if (!doc["valve"].isNull()) {
    index=(doc["valve"].as<uint8_t>())-1;
    if (index<ACTUATOR_COUNT) {
      if (VdmConfig.configFlash.valvesConfig.valveConfig[index].active) {
        if (!doc["value"].isNull()) StmApp.actuators[index].target_position = doc["value"];
      }
      if (VdmConfig.configFlash.valvesControlConfig.valveControlConfig[index].controlFlags.active) {
        if (VdmConfig.configFlash.valvesControlConfig.valveControlConfig[index].valueSource==3) {
          if (!doc["ctrlValue"].isNull()) PiControl[index].value = doc["ctrlValue"];
          #ifdef EnvDevelop
            UART_DBG.println("ctrlValue : "+String(PiControl[index].value));
          #endif
          jsonSetValveReceived=true;
        }
        if (VdmConfig.configFlash.valvesControlConfig.valveControlConfig[index].targetSource==1) {
          if (!doc["ctrlTarget"].isNull()) {
            PiControl[index].target = doc["ctrlTarget"];
            #ifdef EnvDevelop
            UART_DBG.println("ctrlTarget : "+String(PiControl[index].target));
            #endif
            jsonSetValveReceived=true;
          }
          if (!doc["ctrlDynOffs"].isNull()) PiControl[index].dynOffset = doc["ctrlDynOffs"];
        }
      }
    }
  }
}

String getContentType(String filename) 
{ // convert the file extension to the MIME type
  if (filename.endsWith(".html")) return th;
  else if (filename.endsWith(".css")) return "text/css";
  else if (filename.endsWith(".js")) return "application/javascript";
  else if (filename.endsWith(".ico")) return "image/x-icon";
  else if (filename.endsWith(".gz")) return "application/x-gzip";
  return tp;
}

int8_t checkEntry (String url) 
{
  int8_t i = 0;
  TFS_DIR_ENTRY *entry = (TFS_DIR_ENTRY*) tfs_data;
  String thisUrl=url;
  if (url=="/") thisUrl = "/index.html";
 
  while (entry->NAME != NULL) {
      if (thisUrl == String(entry->NAME)) {
        return(i);
      }
      entry++;
      i++;
  }
  
  return(-1);
}

void handleRoot(AsyncWebServerRequest *request) 
{
  int8_t index;
  
  index=checkEntry(request->url());
  if (index>=0) {
    AsyncWebServerResponse *response = request->beginResponse_P(200, getContentType (tfs_data[index].NAME), 
                                      tfs_data[index].DATA, tfs_data[index].SIZE);
    response->addHeader("Content-Encoding", "gzip");
    request->send(response);
  } else {
    String message = "File "+request->url()+" Not Found\n\n"; 
    request->send(404, tp, message);
  }
}


void handleWebPageStmUpdate(AsyncWebServerRequest *request) 
{
  int8_t index;
  String thisUrl = request->url();
  if (!thisUrl.endsWith(".html")) thisUrl+=".html";
  index=checkEntry(thisUrl);
  if (index>=0) {
    AsyncWebServerResponse *response = request->beginResponse_P(200, getContentType (tfs_data[index].NAME), 
                                      tfs_data[index].DATA, tfs_data[index].SIZE);
    response->addHeader("Content-Encoding", "gzip");
    request->send(response);
  } else {
    String message = "File "+request->url()+" Not Found\n\n"; 
    request->send(404, tp, message);
  }
}

void handleNotFound(AsyncWebServerRequest *request)
{
  if (checkEntry(request->url())>=0) {
    handleRoot(request); 
  } else {

    String message = "File Not Found\n\n";

    message += "URI: ";
    //message += server.uri();
    message += request->url();
    message += "\nMethod: ";
    message += (request->method() == HTTP_GET) ? "GET" : "POST";
    message += "\nArguments: ";
    message += request->args();
    message += "\n";

    for (uint8_t i = 0; i < request->args(); i++) {
      message += " " + request->argName(i) + ": " + request->arg(i) + "\n";
    }
    request->send(404, tp, message);
  }
}

void handleValves(AsyncWebServerRequest *request)
{
  request->send(200,aj,Web.getValvesStatus());
}

void handleTemps(AsyncWebServerRequest *request)
{
  request->send(200,aj,Web.getTempsStatus(VdmConfig.configFlash.tempsConfig));
}

void handleNetInfo(AsyncWebServerRequest *request) 
{ 
  request->send(200,aj,Web.getNetInfo(VdmNet.networkInfo));
}

void handleNetConfig(AsyncWebServerRequest *request)
{
  request->send(200,aj,Web.getNetConfig(VdmConfig.configFlash.netConfig));
}

void handleProtConfig(AsyncWebServerRequest *request)
{
  request->send(200,aj,Web.getProtConfig(VdmConfig.configFlash.protConfig));
}

void handleValvesConfig(AsyncWebServerRequest *request)
{
  request->send(200,aj,Web.getValvesConfig (VdmConfig.configFlash.valvesConfig));
}

void handleMotorConfig(AsyncWebServerRequest *request)
{
  request->send(200,aj,Web.getMotorConfig (StmApp.motorChars));
}

void handleValvesControlConfig(AsyncWebServerRequest *request)
{
  request->send(200,aj,Web.getValvesControlConfig (VdmConfig.configFlash.valvesControlConfig));
}

void handleTempsConfig(AsyncWebServerRequest *request)
{
  request->send(200,aj,Web.getTempsConfig (VdmConfig.configFlash.tempsConfig));
}

void handleTempSensorsID(AsyncWebServerRequest *request)
{
  request->send(200,aj,Web.getTempSensorsID ());
}

void handleSysInfo(AsyncWebServerRequest *request) 
{ 
  request->send(200,aj,Web.getSysInfo());
}

void handleSysDynInfo(AsyncWebServerRequest *request) 
{ 
  request->send(200,aj,Web.getSysDynInfo());
}

void handleGetSysConfig(AsyncWebServerRequest *request) 
{ 
  request->send(200,aj,Web.getSysConfig(VdmConfig.configFlash.systemConfig));
}

void handleGetMsgConfig(AsyncWebServerRequest *request) 
{ 
  request->send(200,aj,Web.getMsgConfig(VdmConfig.configFlash.messengerConfig));
}

void handleGetStm(AsyncWebServerRequest *request) 
{ 
  // generate callback with request parameter
  // send request answer after getting from stm 
}

void handleGetFSDir(AsyncWebServerRequest *request) 
{ 
  request->send(200,aj,Web.getFSDir());
}

void handleStmUpdStatus(AsyncWebServerRequest *request) 
{ 
  request->send(200,aj,Web.getStmUpdStatus());
}


bool handleCmd(JsonObject doc) 
{ 
  typedef void (*fp)(JsonObject doc);
  fp  fpList[] = {&restart,&writeConfig,&resetConfig,&restoreConfig,&fileDelete,&setGetFS,
                  &setClearFS,&scanTSensors,&valvesCalibration,&valvesAssembly,&valvesDetect,&writeValvesControl,&mqttReconnect,&sysLogSave} ;

  char const *names[]=  {"reboot", "saveCfg","resetCfg","restoreCfg","fDelete","getFS",
                        "clearFS","scanTempSensors","vCalib","vAssembly","valvesDetect","vCtrlSave","mqttReconnect","sysLogSave",NULL};
  char const **p;
  bool found = false;

  if (!doc["action"].isNull()) {
    const char* d=doc["action"].as<const char*>();
    uint8_t i=0;
  
    for (p=names; *p!=NULL; p++) {
      if (strcmp(d, *p)==0) {
        fpList[i](doc);
        found=true;
        break;
      }
      i++;
    }
  }
  return (found);
}

void handleUploadFile(AsyncWebServerRequest *request, const String& filename, size_t index, 
            uint8_t *data, size_t len, bool final)
{
  if(!index){
    String thisFileName = filename;
    // open the file on first call and store the file handle in the request object
    #ifdef EnvDevelop
      UART_DBG.println("file has arguments : "+String(request->args()));
    #endif
    if (request->args()) {
        #ifdef EnvDevelop      
          UART_DBG.println("file has argument "+request->arg("dir"));
        #endif
        thisFileName = "/"+filename; 
    }
    #ifdef EnvDevelop
      UART_DBG.println("filename : "+thisFileName);
    #endif
    request->_tempFile = SPIFFS.open(thisFileName, "w");
  }
  if(len) {
    // stream the incoming chunk to the opened file
    request->_tempFile.write(data,len);
  }
  if(final){
    // close the file handle as the upload is now done
    request->_tempFile.close();
    request->send(200, aj, Web.getFSDir()); 
    #ifdef EnvDevelop
      UART_DBG.println("upload finished");
    #endif
  }
  
}

CServerServices::CServerServices()
{
  jsonSetValveReceived=false;
}

void CServerServices::stmDoUpdate(JsonObject doc)
{

  if (!doc["file"].isNull()) {
    if (!doc["cmd"].isNull()) {
    String thisFileName = doc["file"].as<const char*>();
    if (!thisFileName.startsWith("/")) thisFileName = "/"+thisFileName;
    uint8_t command = doc["cmd"];
    #ifdef EnvDevelop
      UART_DBG.println("file : "+thisFileName + " Command "+ String(command));
    #endif
    if (command==0) VdmTask.startStm32Ota(STM32OTA_START,thisFileName);
    if (command==1) VdmTask.startStm32Ota(STM32OTA_STARTBLANK,thisFileName);
  }
  }
}

void  CServerServices::initServer() 
{
  // define on events
  server.on("/", HTTP_GET, [](AsyncWebServerRequest * request) {handleRoot(request);});
  server.onNotFound(handleNotFound);
  server.on("/valves",HTTP_GET,[](AsyncWebServerRequest * request) {handleValves(request);});
  server.on("/temps",HTTP_GET,[](AsyncWebServerRequest * request) {handleTemps(request);});
  server.on("/netinfo",HTTP_GET,[](AsyncWebServerRequest * request) {handleNetInfo(request);});
  server.on("/netconfig",HTTP_GET,[](AsyncWebServerRequest * request) {handleNetConfig(request);});
  server.on("/protconfig",HTTP_GET,[](AsyncWebServerRequest * request) {handleProtConfig(request);});
  server.on("/valvesconfig",HTTP_GET,[](AsyncWebServerRequest * request) {handleValvesConfig(request);});
  server.on("/motorconfig",HTTP_GET,[](AsyncWebServerRequest * request) {handleMotorConfig(request);});
  server.on("/valvesctrlconfig",HTTP_GET,[](AsyncWebServerRequest * request) {handleValvesControlConfig(request);});
  server.on("/tempsconfig",HTTP_GET,[](AsyncWebServerRequest * request) {handleTempsConfig(request);});
  server.on("/sysinfo",HTTP_GET,[](AsyncWebServerRequest * request) {handleSysInfo(request);});
  server.on("/sysdyninfo",HTTP_GET,[](AsyncWebServerRequest * request) {handleSysDynInfo(request);});
  server.on("/fsdir",HTTP_GET,[](AsyncWebServerRequest * request) {handleGetFSDir(request);});
  server.on("/stmupdate", HTTP_GET, [](AsyncWebServerRequest * request) {handleWebPageStmUpdate(request);});
  server.on("/stmupdstatus", HTTP_GET, [](AsyncWebServerRequest * request) {handleStmUpdStatus(request);});
  server.on("/tempsensorsid", HTTP_GET, [](AsyncWebServerRequest * request) {handleTempSensorsID(request);});
  server.on("/sysconfig", HTTP_GET, [](AsyncWebServerRequest * request) {handleGetSysConfig(request);});
  server.on("/msgconfig", HTTP_GET, [](AsyncWebServerRequest * request) {handleGetMsgConfig(request);});
  server.on("/stm?", HTTP_GET, [](AsyncWebServerRequest * request) {handleGetStm(request);});
  
  server.on("/fupload", HTTP_POST, [](AsyncWebServerRequest *request) {},
      [](AsyncWebServerRequest *request, const String& filename, size_t index, uint8_t *data,
                    size_t len, bool final) {handleUploadFile(request, filename, index, data, len, final);}
  );

  AsyncCallbackJsonWebHandler* stmDoUpdateHandler = new AsyncCallbackJsonWebHandler("/stmdoupdate", [](AsyncWebServerRequest *request, JsonVariant &json) {
    if (json.is<JsonObject>()) {
      JsonObject&& jsonObj = json.as<JsonObject>();
      ServerServices.stmDoUpdate (jsonObj);
      request->send(200, aj, resOk);
    } else request->send(400, tp, "Not an object");
  });
  server.addHandler(stmDoUpdateHandler);

  AsyncCallbackJsonWebHandler* setValveHandler = new AsyncCallbackJsonWebHandler("/setvalve", [](AsyncWebServerRequest *request, JsonVariant &json) {
    if (json.is<JsonObject>()) {
      JsonObject&& jsonObj = json.as<JsonObject>();
      ServerServices.postSetValve (jsonObj);
      request->send(200, aj, resOk);
    } else request->send(400, tp, "Not an object");
  });
  server.addHandler(setValveHandler);

  AsyncCallbackJsonWebHandler* netCfgHandler = new AsyncCallbackJsonWebHandler("/netconfig", [](AsyncWebServerRequest *request, JsonVariant &json) {
    if (json.is<JsonObject>()) {
      JsonObject&& jsonObj = json.as<JsonObject>();
      VdmConfig.postNetCfg (jsonObj);
      request->send(200, aj, resOk);
    } else request->send(400, tp, "Not an object");
  });
  server.addHandler(netCfgHandler);

  AsyncCallbackJsonWebHandler* sysLogCfgHandler = new AsyncCallbackJsonWebHandler("/sysLogCfg", [](AsyncWebServerRequest *request, JsonVariant &json) {
    if (json.is<JsonObject>()) {
      JsonObject&& jsonObj = json.as<JsonObject>();
      VdmConfig.postSysLogCfg (jsonObj);
      request->send(200, aj, resOk);
    } else request->send(400, tp, "Not an object");
  });
  server.addHandler(sysLogCfgHandler);  
  
  AsyncCallbackJsonWebHandler* protCfgHandler = new AsyncCallbackJsonWebHandler("/protconfig", [](AsyncWebServerRequest *request, JsonVariant &json) {
    if (json.is<JsonObject>()) {
      JsonObject&& jsonObj = json.as<JsonObject>();
      VdmConfig.postProtCfg (jsonObj);
      request->send(200, aj, resOk);
    } else request->send(400, tp, "Not an object");
  });
  server.addHandler(protCfgHandler);

  AsyncCallbackJsonWebHandler* valvesCfgHandler = new AsyncCallbackJsonWebHandler("/valvesconfig", [](AsyncWebServerRequest *request, JsonVariant &json) {
    if (json.is<JsonObject>()) {
      JsonObject&& jsonObj = json.as<JsonObject>();
      VdmConfig.postValvesCfg (jsonObj);
      request->send(200, aj, resOk);
    } else request->send(400, tp, "Not an object");
  });
  server.addHandler(valvesCfgHandler);
  
AsyncCallbackJsonWebHandler* valvesControlCfgHandler = new AsyncCallbackJsonWebHandler("/valvesctrlconfig", [](AsyncWebServerRequest *request, JsonVariant &json) {
    if (json.is<JsonObject>()) {
      JsonObject&& jsonObj = json.as<JsonObject>();
      VdmConfig.postValvesControlCfg (jsonObj);
      request->send(200, aj, resOk);
    } else request->send(400, tp, "Not an object");
  });
  server.addHandler(valvesControlCfgHandler);
  
  
  AsyncCallbackJsonWebHandler* tempsCfgHandler = new AsyncCallbackJsonWebHandler("/tempsconfig", [](AsyncWebServerRequest *request, JsonVariant &json) {
    if (json.is<JsonObject>()) {
      JsonObject&& jsonObj = json.as<JsonObject>();
      VdmConfig.postTempsCfg (jsonObj);
      request->send(200, aj, resOk);
    } else request->send(400, tp, "Not an object");
  });
  server.addHandler(tempsCfgHandler);

  AsyncCallbackJsonWebHandler* tempsAuthHandler = new AsyncCallbackJsonWebHandler("/auth", [](AsyncWebServerRequest *request, JsonVariant &json) {
    if (json.is<JsonObject>()) {
      JsonObject&& jsonObj = json.as<JsonObject>();
      String auth=VdmConfig.handleAuth (jsonObj);
      request->send(200, aj, auth);
    } else request->send(400, tp, "Not an object");
  });
  server.addHandler(tempsAuthHandler);

  AsyncCallbackJsonWebHandler* cmdHandler = new AsyncCallbackJsonWebHandler("/cmd", [](AsyncWebServerRequest *request, JsonVariant &json) {
    if (json.is<JsonObject>()) {
      JsonObject&& jsonObj = json.as<JsonObject>();
      if (handleCmd (jsonObj))
        request->send(200, aj, resOk);
      else request->send(200, tp, "Cmd not found");
    } else request->send(400, tp, "Not an object");
  });
  server.addHandler(cmdHandler);

  AsyncCallbackJsonWebHandler* sysCfgHandler = new AsyncCallbackJsonWebHandler("/sysconfig", [](AsyncWebServerRequest *request, JsonVariant &json) {
    if (json.is<JsonObject>()) {
      JsonObject&& jsonObj = json.as<JsonObject>();
      VdmConfig.postSysCfg (jsonObj);
      request->send(200, aj, resOk);
    } else request->send(400, tp, "Not an object");
  });
  server.addHandler(sysCfgHandler);
  
AsyncCallbackJsonWebHandler* msgCfgHandler = new AsyncCallbackJsonWebHandler("/msgconfig", [](AsyncWebServerRequest *request, JsonVariant &json) {
    if (json.is<JsonObject>()) {
      JsonObject&& jsonObj = json.as<JsonObject>();
      VdmConfig.postMessengerCfg (jsonObj);
      request->send(200, aj, resOk);
    } else request->send(400, tp, "Not an object");
  });
  server.addHandler(msgCfgHandler);

AsyncCallbackJsonWebHandler* testPOHandler = new AsyncCallbackJsonWebHandler("/testPO", [](AsyncWebServerRequest *request, JsonVariant &json) {
    if (json.is<JsonObject>()) {
      JsonObject&& jsonObj = json.as<JsonObject>();
      Messenger.testPO(jsonObj);
      request->send(200, aj, resOk);
    } else request->send(400, tp, "Not an object");
  });
  server.addHandler(testPOHandler);  

AsyncCallbackJsonWebHandler* testEmailHandler = new AsyncCallbackJsonWebHandler("/testEmail", [](AsyncWebServerRequest *request, JsonVariant &json) {
    if (json.is<JsonObject>()) {
      JsonObject&& jsonObj = json.as<JsonObject>();
      Messenger.testEmail(jsonObj);
      request->send(200, aj, resOk);
    } else request->send(400, tp, "Not an object");
  });
  server.addHandler(testEmailHandler);  

  WT32AsyncOTA.begin(&server);    // Start WT32OTA
  server.begin();
}
