Lenti84/VdMot_Controller/software_esp32/src/Services.cpp

/**HEADER*******************************************************************
  project : VdMot Controller

  author : SurfGargano, Lenti84

  Comments:

  Version :

  Modifcations :


***************************************************************************
*
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
  Copyright (C) 2021 Lenti84  https://github.com/Lenti84/VdMot_Controller

*END************************************************************************/


#include "Services.h"
#include "globals.h"
#include "VdmTask.h"
#include "VdmConfig.h"
#include "VdmSystem.h"
#include "VdmNet.h"
#include "stmApp.h"
#include "Queue.h"
#include "Messenger.h"
#include "PIControl.h"
#include "stmApp.h"


CServices Services;

CServices::CServices()
{
  serviceValvesStarted=false;
  for (uint8_t x = 0;x<TEMP_SENSORS_COUNT;x++) 
    tempStates[x].timeOut=0;  
}

void CServices::checkServiceValves()
{
  struct tm timeinfo;
  //UART_DBG.println("checkServiceValves");
  if (VdmNet.sntpActive) {
    if (VdmSystem.getLocalTime(&timeinfo)) {
      uint8_t i = 1<<timeinfo.tm_wday;
      time_t now;
      time (&now);
        
      if ((VdmConfig.configFlash.valvesConfig.dayOfCalib & i) !=0) { // day fits
        if (VdmConfig.configFlash.valvesConfig.hourOfCalib==timeinfo.tm_hour) { // hour fits
            if (!serviceValvesStarted) {
              serviceValvesStarted=true;
              // start service valves
              StmApp.valvesCalibration(255);
            }
        } else serviceValvesStarted=false;
      }
    }
  }
}

void CServices::checkDS18()
{
  int8_t tempIdx;
  int8_t valveIdx;
  bool messengerToSend=false;
  String title = String(VdmConfig.configFlash.systemConfig.stationName) + " : SYSTEM" ;
  String s = "DS18 sensor failed for room\r\n";

  for (uint8_t x = 0;x<StmApp.tempsCount;x++) {
    tempIdx=StmApp.findTempID(StmApp.temps[x].id);  // starts with 0 
    if (tempIdx>=0) {
      if (VdmConfig.configFlash.tempsConfig.tempConfig[tempIdx].active) {
        tempStates[tempIdx].tempFailed=(StmApp.temps[x].temperature<=-500);
        if (tempStates[tempIdx].tempFailed) {
            tempStates[tempIdx].timeOut++;
            if (tempStates[tempIdx].timeOut>4) {
              if (!tempStates[tempIdx].messengerSent) {
                s+=String(VdmConfig.configFlash.tempsConfig.tempConfig[tempIdx].name)+"\r\n";
                tempStates[tempIdx].messengerSent=true;
                messengerToSend=true;
              }
              tempStates[tempIdx].timeOut=0;
              if (VdmConfig.configFlash.protConfig.mqttConfig.flags.timeoutDSActive) {
                valveIdx=StmApp.findTempIdxInValve (tempIdx);
                if ((valveIdx>=0) && (valveIdx<ACTUATOR_COUNT)) {
                  if (((StmApp.actuators[valveIdx].tIdx1 > 0) && (VdmConfig.configFlash.valvesControlConfig.valveControlConfig[valveIdx].valueSource==1)) ||
                    ((StmApp.actuators[valveIdx].tIdx2 > 0) && (VdmConfig.configFlash.valvesControlConfig.valveControlConfig[valveIdx].valueSource==2)))
                  {
                      PiControl[valveIdx].setFailed(VdmConfig.configFlash.protConfig.mqttConfig.toPos);
                  }
                }
              }
            }
        }
      }
      if (!tempStates[tempIdx].tempFailed) {
        tempStates[tempIdx].messengerSent= false;
        tempStates[tempIdx].timeOut=0;
      }
    }
  }
  if (VdmConfig.configFlash.messengerConfig.reason.reasonFlags.ds18Failed) {
    if (messengerToSend) Messenger.sendMessage (title.c_str(),s.c_str());
  }
}

void CServices::checkGetNtp()
{
  // check if time is 3:05 am
  if (VdmNet.sntpActive) {
    VdmNet.sntpReachable=VdmNet.checkSntpReachable();
    #ifdef EnvDevelop
        UART_DBG.println("checkGetNtp : "+String(VdmNet.sntpReachable));
      #endif
    if (VdmNet.sntpReachable) {
      if (VdmSystem.getLocalTime(&VdmNet.startTimeinfo)) {
        if ((VdmNet.startTimeinfo.tm_hour==getNtpHour) && (VdmNet.startTimeinfo.tm_min==getNtpMin)) {
          VdmNet.setupNtp();
        }
      }
    }
    else 
    {
      VdmNet.setupNtp(); 
    }
  }
}

void CServices::servicesLoop()
{
  checkServiceValves();  
  checkGetNtp();
  VdmNet.checkWifi();
  checkDS18();
}

void CServices::runOnce() 
{
    StmApp.getParametersFromSTM();
}

void CServices::runOnceDelayed10()
{
  VdmTask.startApp();
  VdmNet.startBroker();
  checkGetNtp();
}

void CServices::runOnceDelayed60()
{
  VdmTask.startPIServices();
  VdmTask.piTaskInitiated=true;
}

void CServices::restartSystem(bool waitQueueFinished) {
  #ifdef EnvDevelop
    UART_DBG.println("restart System ");
  #endif
  
  if (StmApp.waitEEPFinished) {
    StmApp.eepState=EEP_REQUEST; 
  }
  if (StmApp.waitForFinishQueue || StmApp.waitEEPFinished) {
        #ifdef EnvDevelop
          UART_DBG.println("wait for finish queue");
        #endif
        VdmTask.taskIdResetSystem = taskManager.scheduleOnce(60*1000, [] {
                #ifdef EnvDevelop
                  UART_DBG.println("wait for finish queue timeout, restart now");
                #endif
                delay (1000);
                ESP.restart();
            });
        VdmTask.taskIdwaitForFinishQueue = taskManager.scheduleFixedRate(500, [] {
          int restartNow = 0;
          if (StmApp.waitForFinishQueue) restartNow=Queue.available();
          if (StmApp.waitEEPFinished) {
            if ((StmApp.eepState!=EEP_DONE) && (StmApp.eepState!=EEP_IDLE)) restartNow++; 
            #ifdef EnvDevelop
              UART_DBG.println("waiting eep finished "+String(StmApp.eepState));
            #endif
          } 
          if (restartNow==0) {
              #ifdef EnvDevelop
                UART_DBG.println("queue/eeprom finished, restart now");
              #endif
              StmApp.eepState=EEP_IDLE;
                VdmTask.taskIdResetSystem = taskManager.scheduleOnce(3000, [] {
                  ESP.restart();
                });
                VdmTask.deleteTask(VdmTask.taskIdwaitForFinishQueue);
          }
        });
    } else {
      #ifdef EnvDevelop
        UART_DBG.println("normal restart");
      #endif
      VdmTask.taskIdResetSystem = taskManager.scheduleOnce(2000, [] {
              ESP.restart();
            });
    }
}

void CServices::restartStmApp(uint32_t ms) {
      VdmTask.restartStmApp = taskManager.scheduleOnce(ms, [] {
                VdmTask.startApp();
            });
}
