Lenti84/VdMot_Controller/software_esp32/src/tfs_data.c

#include <tfs.h>

extern const TFS_DIR_ENTRY tfs_data[];

static const unsigned char tfs____web_pages_blank_png[] = {
	/* ../web_pages/blank.png */
	0x1f, 0x8b, 0x08, 0x08, 0xdd, 0x55, 0x4b, 0x65, 0x02, 0x03,
	0x62, 0x6c, 0x61, 0x6e, 0x6b, 0x2e, 0x70, 0x6e, 0x67, 0x00,
	0xeb, 0x0c, 0xf0, 0x73, 0xe7, 0xe5, 0x92, 0xe2, 0x62, 0x60,
	0x60, 0xe0, 0xf5, 0xf4, 0x70, 0x09, 0x62, 0x60, 0x60, 0x62,
	0x00, 0x61, 0x0e, 0x36, 0x20, 0xf5, 0xa5, 0xe2, 0xca, 0x2f,
	0x20, 0xc5, 0x59, 0xe0, 0x11, 0x59, 0x0c, 0x94, 0xbf, 0x0e,
	0xc2, 0x8c, 0x4e, 0x1a, 0xb3, 0x2b, 0x80, 0x82, 0xb2, 0x99,
	0x21, 0x11, 0x25, 0xc1, 0xf9, 0x69, 0x25, 0xe5, 0x89, 0x45,
	0xa9, 0x0c, 0x20, 0x50, 0x5e, 0x5e, 0xae, 0x97, 0x99, 0x97,
	0x5d, 0x9c, 0x9c, 0x58, 0x90, 0xaa, 0x97, 0x5f, 0x94, 0xfe,
	0xa6, 0x2b, 0x7a, 0x23, 0x03, 0x03, 0x0b, 0xbf, 0xa7, 0x8b,
	0x63, 0x48, 0xc5, 0xad, 0xb7, 0x07, 0x0d, 0x19, 0x81, 0x8a,
	0x0e, 0x2d, 0xf8, 0xea, 0x9f, 0xcb, 0x9e, 0xbf, 0x80, 0x61,
	0x14, 0x8c, 0x82, 0x51, 0x30, 0xe2, 0xc0, 0x03, 0x73, 0xa6,
	0x0f, 0x0c, 0x8c, 0xfa, 0xb7, 0x0e, 0x78, 0x83, 0x78, 0x9e,
	0xae, 0x7e, 0x2e, 0xeb, 0x9c, 0x12, 0x9a, 0x00, 0x44, 0xd7,
	0x04, 0x82, 0x86, 0x04, 0x00, 0x00
};

static const unsigned char tfs____web_pages_favicon_ico[] = {
	/* ../web_pages/favicon.ico */
	0x1f, 0x8b, 0x08, 0x08, 0x8d, 0x5b, 0x24, 0x64, 0x02, 0x03,
	0x66, 0x61, 0x76, 0x69, 0x63, 0x6f, 0x6e, 0x2e, 0x69, 0x63,
	0x6f, 0x00, 0xed, 0x5a, 0x4d, 0x4c, 0x1b, 0x47, 0x14, 0x7e,
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
	0x0e, 0x72, 0x1d, 0x2b, 0xc9, 0xd7, 0xe7, 0x73, 0x4c, 0xa7,
	0x8f, 0xfe, 0xf4, 0x7c, 0x72, 0x04, 0xed, 0x60, 0x37, 0x1b,
	0x71, 0xf7, 0xec, 0x8a, 0x13, 0xb1, 0xf3, 0x0b, 0xf2, 0x11,
	0xfb, 0x88, 0x71, 0xf4, 0xe0, 0xa3, 0xab, 0x1f, 0x6f, 0xa8,
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
};

const TFS_DIR_ENTRY tfs_data[] = {
	{ "/blank.png", 0, (unsigned char*)tfs____web_pages_blank_png, sizeof(tfs____web_pages_blank_png) },
	{ "/favicon.ico", 0, (unsigned char*)tfs____web_pages_favicon_ico, sizeof(tfs____web_pages_favicon_ico) },
	{ "/index.html", 0, (unsigned char*)tfs____web_pages_index_html, sizeof(tfs____web_pages_index_html) },
	{ "/stmupdate.html", 0, (unsigned char*)tfs____web_pages_stmupdate_html, sizeof(tfs____web_pages_stmupdate_html) },
	{ "/warning_red.png", 0, (unsigned char*)tfs____web_pages_warning_red_png, sizeof(tfs____web_pages_warning_red_png) },
	{ "/warning_yellow.png", 0, (unsigned char*)tfs____web_pages_warning_yellow_png, sizeof(tfs____web_pages_warning_yellow_png) },
	{ "/window_close.png", 0, (unsigned char*)tfs____web_pages_window_close_png, sizeof(tfs____web_pages_window_close_png) },
	{ "/window_gray.png", 0, (unsigned char*)tfs____web_pages_window_gray_png, sizeof(tfs____web_pages_window_gray_png) },
	{ "/window_open.png", 0, (unsigned char*)tfs____web_pages_window_open_png, sizeof(tfs____web_pages_window_open_png) },
	{ 0, 0, 0, 0 }
};
