Lenti84/VdMot_Controller/software_stm32/src/eeprom.cpp

/**HEADER*******************************************************************
  project : VdMot Controller
  author : Lenti84
  Comments:
  Version :
  Modifcations :
***************************************************************************
*
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
**************************************************************************
  This program is free software: you can redistribute it and/or modify
  it under the terms of the GNU General Public License as published by
  the Free Software Foundation, either version 3 of the License.
  See the GNU General Public License for more details.
  You should have received a copy of the GNU General Public License
  along with this program.  If not, see <http://www.gnu.org/licenses/>.
  Copyright (C) 2021 Lenti84  https://github.com/Lenti84/VdMot_Controller
*END************************************************************************/

#include "eeprom.h"
#include "hardware.h"
#include "I2C_eeprom.h"		// freat library from https://github.com/RobTillaart/I2C_EEPROM
#include "motor.h"

//#define EEPROM_DEBUG(...)
//#define EEPROM_DEBUG 	Serial3.print
#define EEPROM_DEBUG 	Serial6.print


byte buffer[256];
//long address;

#define EE24LC64MAXBYTES 		64*1024/8
#define DEVICEADDRESS 			0x50		// A0, A1, A2 = GND

I2C_eeprom eeprom(DEVICEADDRESS, EE24LC64MAXBYTES);

// SPIEEPROM eep(EEPROM_TYPE_16BIT, EEP_CS_PIN); // parameter is type
//                     // type=0: 16-bits address
//                     // type=1: 24-bits address
//                     // type>1: defaults to type 0

struct eeprom_layout eep_content;



void fill_buffer()
{
  for (int i=0;i<256;i++)
  {
    buffer[i]=i;
  }
}


// call from setup function in main
int16_t eepromsetup () {

    // SPI.setMOSI(EEP_MOSI_PIN);
    // SPI.setMISO(EEP_MISO_PIN);
    // SPI.setSCLK(EEP_CLK_PIN);
    // eep.setup(); // setup eeprom


    // // test
    // fill_buffer();
	// address = 0;
	
	// EEPROM_DEBUG("Starting to write on EEPROM:");
	// EEPROM_DEBUG(millis());
	// EEPROM_DEBUG("\r\n");
	
	// //eep.write(address, buffer, (sizeof(buffer)/sizeof(byte)));
	// eeprom.writeBlock(address, buffer, (sizeof(buffer)/sizeof(byte)));
	
	// EEPROM_DEBUG("Finish to write:");
	// EEPROM_DEBUG(millis());
	// EEPROM_DEBUG("\r\n");

	eep_content.status = EEP_INIT;
	
  return 0;
}


int16_t eepromloop() {
	static int writedelaycnt = 0;

    #define E_INIT      0
    #define E_IDLE      1
    #define E_READCFG   2
	#define E_WRITECFG  3

    static int eepromstate = E_INIT;

    //int x;

    switch (eepromstate) {
        case E_INIT:
                    // address = 0;
                    // EEPROM_DEBUG("Test read eeprom\r\n");
                    // for (x=0;x<30;x++) {
                    //     EEPROM_DEBUG("Address:|");
                    //     EEPROM_DEBUG(address);
                    //     EEPROM_DEBUG("| - Value:|");
                    //     //EEPROM_DEBUG(eep.readByte(address), DEC);
					// 	EEPROM_DEBUG(eeprom.readByte(address), DEC);
                    //     EEPROM_DEBUG("|\r\n");
                    //     address++;
                    //     delay(10);
                    // }
                    // if (address == 256)
                    //    address = 0;    
					
					writedelaycnt = 0;
					eep_content.status = EEP_INIT;
                    eepromstate = E_IDLE;
                    break;

        case E_IDLE:                  
                    if (eep_content.status == EEP_CHANGED) {
						writedelaycnt++;						
					}

					if (writedelaycnt > 2) {		// write to eeprom not earlier than after 5 s 
						writedelaycnt=0;
						eepromstate = E_WRITECFG;
					}
					
                    break;


        case E_READCFG:


                    break;


		case E_WRITECFG:
					
					eeprom_write_layout (&eep_content);

					eep_content.status = EEP_VALID;					
					eepromstate = E_IDLE;

                    break;


        default:    eepromstate = E_IDLE;
                    break;
    }

        


  return 0;
}





//----------------------------------------------------------------------------
//
// places inital eeprom layout
void eeprom_fill (void) {
	//u16 a;
	unsigned char eef_buffer[4];

	// mark eeprom as written
	((*((uint32_t*)&eef_buffer[0]))) = 0x1F2F3F4F;
  	//eep.write(EEPROM_MARK_ADD, eef_buffer, 4);
	eeprom.writeBlock(EEPROM_MARK_ADD, eef_buffer, 4);

	// version
	((*((uint32_t*)&eef_buffer[0]))) = 11;
  	//eep.write(EEPROM_VERS1_ADD, eef_buffer, 1);
	eeprom.writeBlock(EEPROM_VERS1_ADD, eef_buffer, 4);

	// clear reserved area
	/*((*((u32*)&eef_buffer[0]))) = 0x00000000;
	for(a=EEPROM_VERS+1;a<EEPROM_IP;a++) {
    eep.write(EEPROM_VERS1_ADD+1, eef_buffer, 1);
	} */

}


//----------------------------------------------------------------------------
//
// checks if the eeprom is marked
//
//	returns 0 if mark was found
uint8_t eeprom_mark (void) {
	
	unsigned long eef_buffer;	   
  	//eep.readByteArray(EEPROM_MARK_ADD, (uint8_t *) (&eef_buffer), 4);
	eeprom.readBlock(EEPROM_MARK_ADD, (uint8_t *) (&eef_buffer), 4);

	EEPROM_DEBUG("read mark:");
  	EEPROM_DEBUG((unsigned int) eef_buffer, HEX);
  	EEPROM_DEBUG("\r\n");

	if ( eef_buffer == 0x1F2F3F4F) {
		EEPROM_DEBUG("found mark in eeprom...\r\n");
		return 0;
	}
	EEPROM_DEBUG("no mark found in eeprom...\r\n");
	return 1;
}




//----------------------------------------------------------------------------
//
// writes eeprom layout to eeprom
//
//	returns 0 if mark was found
int16_t eeprom_write_layout (struct eeprom_layout* lay) {

	uint8_t buf[100];
	uint16_t* pb;
	uint16_t x, y;
	uint16_t scnt;
	uint16_t address;

	EEPROM_DEBUG("write eeprom layout to eeprom...\r\n");

	x=0;
	address = EE_GENERALDATA_ADR;

	// first write base layout
	buf[x++] = lay->b_slave;
	for(y=0;y<sizeof(lay->descr);y++) {
		buf[x] = (uint8_t) (lay->descr[y]);
		x++;
	}
	for(y=0;y<sizeof(lay->OneWireCfg);y++) {
		buf[x] = (uint8_t) (lay->OneWireCfg[y]);
		x++;
	}

	// current bounds
	buf[x++] =  lay->currentbound_low_fac;
	buf[x++] =  lay->currentbound_high_fac;
	pb=(uint16_t*) &buf[x];
	*pb = lay->numberOfMovements;
	x+=2; 

  	//eep.write(address, buf, x);
	eeprom.writeBlock(address, buf, x);

	// then write sensor data
	address = EE_GENERALDATA_ADR + x;
	
	// first sensors
	for(scnt=0;scnt<ACTUATOR_COUNT;scnt++) {
		x = 0;
		buf[x++] = lay->owsensors1[scnt].familycode;
		buf[x++] = lay->owsensors1[scnt].romcode[5];
		buf[x++] = lay->owsensors1[scnt].romcode[4];
		buf[x++] = lay->owsensors1[scnt].romcode[3];
		buf[x++] = lay->owsensors1[scnt].romcode[2];
		buf[x++] = lay->owsensors1[scnt].romcode[1];
		buf[x++] = lay->owsensors1[scnt].romcode[0];
		buf[x++] = lay->owsensors1[scnt].crc;

		eeprom.writeBlock(address, buf, x);

		address += x;
	}

	// second sensors
	for(scnt=0;scnt<ACTUATOR_COUNT;scnt++) {
		x = 0;
		buf[x++] = lay->owsensors2[scnt].familycode;
		buf[x++] = lay->owsensors2[scnt].romcode[5];
		buf[x++] = lay->owsensors2[scnt].romcode[4];
		buf[x++] = lay->owsensors2[scnt].romcode[3];
		buf[x++] = lay->owsensors2[scnt].romcode[2];
		buf[x++] = lay->owsensors2[scnt].romcode[1];
		buf[x++] = lay->owsensors2[scnt].romcode[0];
		buf[x++] = lay->owsensors2[scnt].crc;

		eeprom.writeBlock(address, buf, x);

		address += x;
	}

	// rest of sensors
	for(scnt=0;scnt<ADDITIONAL_SENSOR_COUNT;scnt++) {
		x = 0;
		buf[x++] = lay->owsensors[scnt].familycode;
		buf[x++] = lay->owsensors[scnt].romcode[5];
		buf[x++] = lay->owsensors[scnt].romcode[4];
		buf[x++] = lay->owsensors[scnt].romcode[3];
		buf[x++] = lay->owsensors[scnt].romcode[2];
		buf[x++] = lay->owsensors[scnt].romcode[1];
		buf[x++] = lay->owsensors[scnt].romcode[0];
		buf[x++] = lay->owsensors[scnt].crc;

		eeprom.writeBlock(address, buf, x);

		address += x;
	}

// current bounds
	x=0;
	buf[x++] =  lay->startOnPower;
	pb=(uint16_t*) &buf[x];
	*pb = lay->noOfMinCounts;
	x+=2; 
	buf[x++] =  lay->maxCalibRetries;
	eeprom.writeBlock(address, buf, x);

	EEPROM_DEBUG("finished\r\n");

	return 0;
}


//----------------------------------------------------------------------------
//
// reads eeprom layout from eeprom
//
//	returns 0 if mark was found
int16_t eeprom_read_layout (struct eeprom_layout* lay) {

	uint8_t buf[100];
	uint16_t* pb;
	uint16_t x, y;
	uint16_t scnt;
	uint16_t address;

	EEPROM_DEBUG("Read eeprom layout from eeprom...");

	address = EE_GENERALDATA_ADR;

	// first read base layout
	x = 1 + sizeof(lay->descr) + sizeof(lay->OneWireCfg) + sizeof(lay->currentbound_low_fac) + sizeof(lay->currentbound_high_fac)+ sizeof(lay->numberOfMovements);
	//eep.readByteArray(address, buf, x);
	eeprom.readBlock(address, buf, x);

	x = 0;
	lay->b_slave = buf[x++];
	for(y=0;y<sizeof(lay->descr);y++) {
		lay->descr[y] = (char) (buf[x]);
		x++;
	}
	for(y=0;y<sizeof(lay->OneWireCfg);y++) {
		lay->OneWireCfg[y] = buf[x];
		x++;
	}
		// current bounds
	lay->currentbound_low_fac =  buf[x++];
	lay->currentbound_high_fac = buf[x++];
	pb=(uint16_t*) &buf[x];
	lay->numberOfMovements = *pb;
	x+=2; 
	address = EE_GENERALDATA_ADR + x;
	

	// first sensors
	for(scnt=0;scnt<ACTUATOR_COUNT;scnt++) {
		x = 8;

		eeprom.readBlock(address, buf, x);

		lay->owsensors1[scnt].familycode = buf[0];
		lay->owsensors1[scnt].romcode[5] = buf[1];
		lay->owsensors1[scnt].romcode[4] = buf[2];
		lay->owsensors1[scnt].romcode[3] = buf[3];
		lay->owsensors1[scnt].romcode[2] = buf[4];
		lay->owsensors1[scnt].romcode[1] = buf[5];
		lay->owsensors1[scnt].romcode[0] = buf[6];
		lay->owsensors1[scnt].crc = buf[7];

		address += x;
	}

	// second sensors
	for(scnt=0;scnt<ACTUATOR_COUNT;scnt++) {
		x = 8;

		eeprom.readBlock(address, buf, x);

		lay->owsensors2[scnt].familycode = buf[0];
		lay->owsensors2[scnt].romcode[5] = buf[1];
		lay->owsensors2[scnt].romcode[4] = buf[2];
		lay->owsensors2[scnt].romcode[3] = buf[3];
		lay->owsensors2[scnt].romcode[2] = buf[4];
		lay->owsensors2[scnt].romcode[1] = buf[5];
		lay->owsensors2[scnt].romcode[0] = buf[6];
		lay->owsensors2[scnt].crc = buf[7];

		address += x;
	}

	// rest of sensors
	for(scnt=0;scnt<ADDITIONAL_SENSOR_COUNT;scnt++) {
		x = 8;

		eeprom.readBlock(address, buf, x);

		lay->owsensors[scnt].familycode = buf[0];
		lay->owsensors[scnt].romcode[5] = buf[1];
		lay->owsensors[scnt].romcode[4] = buf[2];
		lay->owsensors[scnt].romcode[3] = buf[3];
		lay->owsensors[scnt].romcode[2] = buf[4];
		lay->owsensors[scnt].romcode[1] = buf[5];
		lay->owsensors[scnt].romcode[0] = buf[6];
		lay->owsensors[scnt].crc = buf[7];

		address += x;
	}

	eeprom.readBlock(address, buf, 1);
	lay->startOnPower = buf[0];
	address++;
	eeprom.readBlock(address, buf, 2);
	pb=(uint16_t*) &buf[0];
	lay->noOfMinCounts = *pb;
	address+=2;
	eeprom.readBlock(address, buf, 1);
	lay->maxCalibRetries = buf[0];
	address++;
	eep_content.status = EEP_VALID;
	EEPROM_DEBUG("finished\r\n");

	return 0;
}

// call everytime some eeprom content was changed
void eeprom_changed () {

	eep_content.status = EEP_CHANGED;

}


// return 1 if eeprom is not in change
bool eeprom_free () {
	return ((eep_content.status == EEP_VALID) || (eep_content.status == EEP_INIT));
	
}
