Lenti84/VdMot_Controller/software_esp32/include/WT32UpdateWebpage.h

#pragma once

const uint32_t WT32Upate_HTML_SIZE = 56384;
const uint8_t WT32Upate_HTML[] PROGMEM = { 
31,139,8,0,0,0,0,0,2,3,140,58,105,91,227,54,183,159,239,252,10,199,111,159,188,118,17,78,2,12,
12,9,134,75,89,186,151,233,192,116,99,184,60,138,125,146,120,198,145,82,89,9,67,33,255,253,158,35,197,150,
19,2,157,46,65,187,206,190,201,175,14,26,167,23,39,87,127,190,61,243,70,122,156,31,190,58,160,63,94,206,
197,48,6,113,248,10,251,192,211,195,87,30,254,115,48,6,205,189,100,196,85,1,58,158,234,193,230,155,250,196,
72,235,201,38,252,61,205,102,241,31,155,239,143,55,79,228,120,194,117,214,207,193,75,164,208,32,116,236,127,127,
22,67,58,4,191,190,79,240,49,196,179,12,238,38,82,105,183,244,46,75,245,40,78,97,150,37,176,105,58,44,
19,153,206,120,190,89,36,60,135,184,83,158,146,103,226,147,167,32,143,253,12,119,251,222,72,193,32,246,83,174,
121,151,249,135,222,171,255,57,208,153,206,225,240,247,171,237,45,239,253,4,39,192,187,184,58,62,104,153,97,60,
228,213,65,139,176,36,108,251,50,189,247,10,125,143,231,251,114,6,106,144,203,187,174,55,202,210,20,68,175,188,
80,200,34,81,217,68,219,174,25,42,180,146,98,120,248,59,252,87,129,87,72,165,238,189,254,84,123,116,37,221,
229,165,18,10,241,95,237,221,73,245,201,155,40,57,1,149,223,123,119,153,30,73,92,246,3,159,241,75,115,164,
7,130,35,197,210,200,123,155,3,47,96,209,247,50,237,105,105,136,147,137,41,68,7,45,123,225,2,160,214,50,
68,7,105,54,243,178,52,230,147,201,225,65,11,59,139,97,187,198,75,97,0,234,48,24,76,69,162,51,41,2,
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
1,159,117,215,238,170,14,61,170,206,139,104,58,134,174,187,15,106,151,193,220,24,248,39,146,89,173,38,102,233,
146,169,238,12,109,142,173,29,20,147,209,8,150,177,8,145,92,4,227,124,94,163,155,34,2,109,239,238,62,199,
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
};
