Lenti84/VdMot_Controller/software_esp8266/src/app.cpp

/*
	Changelog :
	5.11.2021 (Surfgargano)
		change this
			if (millis() > (uint32_t) 100 + timer) {
		to 
			if ((millis()- timer) > (uint32_t) 100) {
		to prevent a 42 day delay in case of wrap around

*/

#include "main.h"
#include <ArduinoJson.h>
#include <Arduino.h>
#include "app.h"
#include "telnet.h"
#include <ESP8266WiFi.h>
#include <Syslog.h>
#include <WiFiUdp.h>

#define     MAX_CMD_LEN     10
#define     MAX_ARG_LEN     120


actuator_str    actuators[ACTUATOR_COUNT];

char mqtt_maintopic[30];

int  cmd_buffer = APP_CMD_NONE;

unsigned char target_position_mirror[ACTUATOR_COUNT];

int settarget_check = 0;

// A UDP instance to let us send and receive packets over UDP
WiFiUDP udpClient;

// Create a new empty syslog instance
Syslog syslog(udpClient, SYSLOG_PROTO_IETF);


char calc_checksum (char *dataptr);
void app_check_data();
void app_cmd(int command);
void app_comm_machine();

void app_setup() {

    for (unsigned int x = 0;x<ACTUATOR_COUNT;x++) {
        actuators[x].actual_position = 100;
        actuators[x].target_position = 0;
        actuators[x].meancurrent = 342;
        actuators[x].state = 1;
        actuators[x].temperature = -500;
    }

    for(unsigned int x = 0; x<ACTUATOR_COUNT; x++)
    {
        target_position_mirror[x] = actuators[x].target_position;
    }

    // prepare syslog configuration here (can be anywhere before first call of 
    // log/logf method)
    syslog.server(SYSLOG_SERVER, SYSLOG_PORT);
    syslog.deviceHostname(DEVICE_HOSTNAME);
    syslog.appName(APP_NAME);
    syslog.defaultPriority(LOG_KERN);

}


void app_loop() {

    DynamicJsonDocument doc(1024);
    String testjson;
    static uint32_t timer = 0;
    static uint32_t timer100ms = 0;
    //char sendbuffer[30];
    //char valbuffer[10];

    app_check_data();
//char checksum;

// doc["sensor"] = "gps";
// doc["time"]   = 1351824120;
// doc["data"][0] = 48.756080;
// doc["data"][1] = 2.302038;

// serializeJson(doc, testjson);

// Serial.println("JSON");
// Serial.println(testjson);
    
//    doc.clear();
//    testjson.clear();


    // 100 ms task
	if ((millis()- timer) > (uint32_t) 100) {
        timer = millis();

        app_comm_machine(); 
        
    }


    // 1000 ms task
    if ((millis()-timer100ms) > (uint32_t) 1000 ) {
        timer100ms = millis();

        //for (unsigned int x = 0;x<ACTUATOR_COUNT;x++) {
        for (unsigned int x = 0;x<4;x++) {
            doc["vlv"][x]["tar"] = actuators[x].target_position;
            doc["vlv"][x]["act"] = actuators[x].actual_position;
            doc["vlv"][x]["mean"] = actuators[x].meancurrent;
            doc["vlv"][x]["st"] = actuators[x].state;
        }
        serializeJson(doc, testjson);
        //Serial.println(testjson);

        syslog.log(LOG_INFO, "App loop");
        syslog.log(LOG_INFO, testjson);

       
        

        // switch (cmd_buffer) {
        //         case APP_CMD_SETTARGET:
        //                     Serial.println(APP_PRE_SETTARGET + testjson);
        //                     break;
        //         case APP_CMD_GETACTUAL:

        //                     break;

        //         default:    break;
        // }            
    }
    cmd_buffer = APP_CMD_NONE;
}


void app_cmd(int command) {
    cmd_buffer = command;
}



char calc_checksum (char *dataptr) {

    char result = 0;

    while(*dataptr != '\0') {
        result += *dataptr++;
    }

    return result;
}



void app_check_data() {

    static char buffer[300];
    static char *bufptr = buffer;
    static unsigned int buflen = 0;
    int availcnt;
    int found = 0;
    
    char*       cmdptr;
    char*	    cmdptrend;
    char        cmd[10];
    char		arg0[20];	
    char        arg1[20];		
    char        arg2[20];
    char        arg3[20];
    char        arg4[20];
	char*		arg0ptr = arg0;
	char*		arg1ptr = arg1;
    char*		arg2ptr = arg2;
    char*		arg3ptr = arg3;
    char*		arg4ptr = arg4;
	uint8_t		argcnt = 0;

    availcnt = Serial.available(); 
    if(availcnt>0)
    {    
        for (int c = 0; c < availcnt; c++)
        {           
            *bufptr++ = (char) Serial.read();
            buflen++;
        }
        if (buflen>=sizeof(buffer)) {
            buffer[sizeof(buffer)-1] = '\r';
        }
    }


    if(buflen > 4) 
    {
        for (unsigned int c = 0; c < buflen; c++)
        {           
            if(buffer[c] == '\r') 
            {
                buffer[c] = '\0';
                //Serial.print("recv "); Serial.println(buffer);
                found = 1;

                buflen = 0;           // reset counter
                bufptr = buffer;    // reset ptr
            }
        }

    }

    if (found)
    {

        // devide buffer into command and data
		// ****************************************
		cmdptr = buffer;

		for(int x=0;x<6;x++){
			cmdptrend = strchr(cmdptr,' ');
			if (cmdptrend!=NULL) {
				*cmdptrend = '\0';
				if(x==0) 		strncpy(cmd,cmdptr,sizeof(cmd)-1);		// command
				else if(x==1) { strncpy(arg0,cmdptr,sizeof(arg0)-1); argcnt=1;	} 	// 1st argument
				else if(x==2) {	strncpy(arg1,cmdptr,sizeof(arg1)-1); argcnt=2;	} 	// 2nd argument
                else if(x==3) {	strncpy(arg2,cmdptr,sizeof(arg2)-1); argcnt=3;	} 	// 3rd argument
                else if(x==4) {	strncpy(arg3,cmdptr,sizeof(arg3)-1); argcnt=4;	} 	// 4th argument
                else if(x==5) {	strncpy(arg4,cmdptr,sizeof(arg4)-1); argcnt=5;	} 	// 5th argument
				cmdptr = cmdptrend + 1;
			}
		}


        // help
		if(memcmp("help",cmd,4) == 0) {
			//Serial.println("Help:");
			//Serial.println("*********************");
			telnet_msg("help command received");
			//return CMD_HELP;
		}

		// get actual values
		// ++++++++++++++++++++++++++++++++++++++++++++++++++++++++++++++++++++++++
		else if(memcmp(APP_PRE_GETACTUALPOS,cmd,5) == 0) {
            telnet_msg("actual position answer");
            //app_cmd(APP_CMD_GETACTUAL);
            
            if(argcnt == 2) {
                //Serial.println("argcnt 2");
                //Serial.print("argcnt "); Serial.println(argcnt);
                //Serial.print("arg0 "); Serial.println(atoi(arg0ptr));
                //Serial.print("arg1 "); Serial.println(atoi(arg1ptr));
                actuators[atoi(arg0ptr)].actual_position = atoi(arg1ptr);
            }
        }

        // get mean current 
		// ++++++++++++++++++++++++++++++++++++++++++++++++++++++++++++++++++++++++
		else if(memcmp(APP_PRE_GETMEANCURR,cmd,5) == 0) {
            telnet_msg("mean current answer");
            //app_cmd(APP_CMD_GETMEANCURR);
            
            if(argcnt == 2) {
                actuators[atoi(arg0ptr)].meancurrent = atoi(arg1ptr);
            }
        }
    
        // get status
		// ++++++++++++++++++++++++++++++++++++++++++++++++++++++++++++++++++++++++
		else if(memcmp(APP_PRE_GETSTATUS,cmd,5) == 0) {
            telnet_msg("status answer");
            //app_cmd(APP_CMD_GETSTATUS);
            
            if(argcnt == 2) {
                actuators[atoi(arg0ptr)].state = atoi(arg1ptr);
            }
        }

         // get set target answer
		// ++++++++++++++++++++++++++++++++++++++++++++++++++++++++++++++++++++++++
		else if(memcmp(APP_PRE_SETTARGETPOS,cmd,5) == 0) {
            if(argcnt == 0) {
                settarget_check = 1;
            }
        }

        // get data values
		// ++++++++++++++++++++++++++++++++++++++++++++++++++++++++++++++++++++++++
		else if(memcmp(APP_PRE_GETVLVDATA,cmd,5) == 0) {
            telnet_msg("got data packet");
            //app_cmd(APP_CMD_GETACTUAL);
            
            if(argcnt == 5) {
                //Serial.println("argcnt 2");
                //Serial.print("argcnt "); Serial.println(argcnt);
                //Serial.print("arg0 "); Serial.println(atoi(arg0ptr));
                //Serial.print("arg1 "); Serial.println(atoi(arg1ptr));
                actuators[atoi(arg0ptr)].actual_position = atoi(arg1ptr);
                actuators[atoi(arg0ptr)].meancurrent = atoi(arg2ptr);
                actuators[atoi(arg0ptr)].state = atoi(arg3ptr);
                actuators[atoi(arg0ptr)].temperature = atoi(arg4ptr);

                syslog.log(LOG_DEBUG, "got full data packet");
            }

            
        }


    
    }

}



void app_comm_machine(){
    #define COMM_IDLE           0
    #define COMM_ALIVE          1
    #define COMM_SENDTARGET     2
    #define COMM_CHECKTARGET    3
    #define COMM_GETDATA        4

    static unsigned char commstate=0;
    char sendbuffer[30];
    char valbuffer[10];

    static unsigned int cnt_alive = COMM_ALIVE_CYCLE;
    static unsigned int getindex = 0;
        
    static unsigned int timeout = 0;
    static unsigned int retry = 0;

    switch(commstate) {

        case COMM_IDLE: 
                commstate = COMM_ALIVE;
                break;

        case COMM_ALIVE: 
                if (cnt_alive) {
                    cnt_alive = COMM_ALIVE_CYCLE;
                    Serial.println("ESPalive");
                    syslog.log(LOG_INFO, "ESPalive");
                }
                else cnt_alive--;

                retry = 5;
                commstate = COMM_SENDTARGET;

                break;

        // send target position values
        case COMM_SENDTARGET:
                commstate = COMM_GETDATA;
                
                //syslog.log(LOG_DEBUG, "checking valve positions");
                for(unsigned int x=0; x<ACTUATOR_COUNT; x++)
                {
                    // check if target has changed
                    if(target_position_mirror[x] != actuators[x].target_position)
                    {
                        sendbuffer[0] = '\0';
                        //Serial.println("sending new target value");
                        strcat(sendbuffer, APP_PRE_SETTARGETPOS);
                        strcat(sendbuffer, " ");

                        itoa(x, valbuffer, 10);
                        strcat(sendbuffer, valbuffer);
                        strcat(sendbuffer, " ");   

                        itoa(actuators[x].target_position, valbuffer, 10);      
                        strcat(sendbuffer, valbuffer);
                        strcat(sendbuffer, " ");

                        Serial.println(sendbuffer);
                        
                        // delay(10);
                        // Serial.println(sendbuffer);
                        // delay(10);
                        // Serial.println(sendbuffer);
                        
                        syslog.log(LOG_DEBUG, sendbuffer);

                        // break loop, next valve will be served in next cycle
                        x = ACTUATOR_COUNT;

                        timeout = 10;
                        commstate = COMM_CHECKTARGET;
                    }

                    
                }

                // update target position mirror - 
                for(unsigned int x = 0; x<ACTUATOR_COUNT; x++)
                {
                    target_position_mirror[x] = actuators[x].target_position;
                }
                //syslog.log(LOG_DEBUG, "updated position mirror");

                break;

        // check correct transmission of target value
        case COMM_CHECKTARGET:

                if(timeout>0) timeout--;
                else {
                    // answer received
                    if(settarget_check) {                        
                        commstate = COMM_GETDATA; 
                    }
                    else {
                        if(retry>0) retry--;
                        else commstate = COMM_GETDATA; 
                        commstate = COMM_SENDTARGET;
                    }
                }
                
                break;

        case COMM_GETDATA:  
                commstate = COMM_IDLE;
                
                // walk through all valves, one per cycle
                //if(getindex<ACTUATOR_COUNT-1) getindex++;
                if(getindex<1) getindex++;
                else getindex=0;

                sendbuffer[0] = '\0';
                
                strcat(sendbuffer, APP_PRE_GETVLVDATA);
                strcat(sendbuffer, " ");

                itoa(getindex, valbuffer, 10);
                strcat(sendbuffer, valbuffer);
                strcat(sendbuffer, " ");   

                Serial.println(sendbuffer);
                        
                //syslog.log(LOG_DEBUG, sendbuffer);

                break;

        default:    
                commstate = COMM_IDLE;
                break;
    }
}
