Lenti84/VdMot_Controller/software_esp32/src/VdmTask.cpp

/**HEADER*******************************************************************
  project : VdMot Controller

  author : SurfGargano, Lenti84

  Comments:

  Version :

  Modifcations :


***************************************************************************
*
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
  Copyright (C) 2021 Lenti84  https://github.com/Lenti84/VdMot_Controller

*END************************************************************************/


#include "VdmTask.h"
#include "VdmNet.h"
#include "stmApp.h"
#include "stm32ota.h"
#include "stm32.h"
#include "ServerServices.h"
#include "VdmConfig.h"
#include "VdmSystem.h"
#include <BasicInterruptAbstraction.h>
#include "PIControl.h"
#include "Messenger.h"

CVdmTask VdmTask;


CVdmTask::CVdmTask()
{
  taskIdCheckNet=TASKMGR_INVALIDID;
  taskIdMqtt=TASKMGR_INVALIDID;
  taskIdApp=TASKMGR_INVALIDID;
  taskIdStm32Ota=TASKMGR_INVALIDID;
  taskIdServices=TASKMGR_INVALIDID;
  taskIdSetFactoryCfgTimeOut=TASKMGR_INVALIDID;
  taskIdSetFactoryCfgInProgress=TASKMGR_INVALIDID;
  taskIdRunOnceClearFS=TASKMGR_INVALIDID;
  taskIdRunOnceGetFS=TASKMGR_INVALIDID;
  setFactoryCfgState=idle;
  for (uint8_t picIdx=0; picIdx<ACTUATOR_COUNT; picIdx++) {
            taskIdPiControl[picIdx]=TASKMGR_INVALIDID;
  }
  restartPiTask=true;
  sendMessenger = false;
}

void CVdmTask::init()
{
    if (taskIdCheckNet==TASKMGR_INVALIDID) {
        taskIdCheckNet = taskManager.scheduleFixedRate(1000, [] {            
            VdmNet.checkNet();           
        });
    }
}

void CVdmTask::startMqtt(uint32_t interval)
{
    uint32_t thisInterval = 100;
    if (taskIdMqtt==TASKMGR_INVALIDID) {
        if (interval >= 100) thisInterval = interval;
        VdmNet.mqttBroker();
        taskIdMqtt = taskManager.scheduleFixedRate(thisInterval, [] {
            VdmNet.mqttBroker();
        });
    }
}

void CVdmTask::startApp()
{
    if (taskIdStm32Ota!=TASKMGR_INVALIDID) {
        deleteTask (taskIdStm32Ota);
        delay (1000);       // wait to finish task; 
        taskIdStm32Ota=TASKMGR_INVALIDID; 
        Services.restartSystem(false);
    }
    if (taskIdApp==TASKMGR_INVALIDID) { 
        StmApp.app_setup();
        taskIdApp = taskManager.scheduleFixedRate(100, [] {
                StmApp.app_loop();
        });
    } else {
        taskManager.setTaskEnabled (taskIdApp,true);   
    }
}

void CVdmTask::startStm32Ota(uint8_t command,String thisFileName)
{
    taskManager.setTaskEnabled (taskIdApp,false);
    delay (1000);           // wait to finish task;
    Stm32.STM32ota_setup();
    Stm32.STM32ota_start(command,thisFileName);
    if (taskIdStm32Ota==TASKMGR_INVALIDID) {
        taskIdStm32Ota = taskManager.scheduleFixedRate(50, [] {         // 50 ms good for 115200 baud UART speed and blocksize of 256
            Stm32.STM32ota_loop();
        });
    } else {
        delay (100);         
    }
}

void CVdmTask::startServices()
{
    #ifdef EnvDevelop
        UART_DBG.println("Start services");
    #endif
    
    taskIdRunOnce = taskManager.scheduleOnce(1000, [] {
                Services.runOnce();
    });
    
    taskIdRunOnceDelayed10 = taskManager.scheduleOnce(10, [] {
                Services.runOnceDelayed10();
    },TIME_SECONDS);
    
    taskIdRunOnceDelayed60 = taskManager.scheduleOnce(60, [] {
                Services.runOnceDelayed60();
    },TIME_SECONDS);

    taskIdServices = taskManager.scheduleFixedRate(60, [] { 
        Services.servicesLoop();
    },TIME_SECONDS);  

    VdmSystem.sendResetReason();
}

void CVdmTask::stopPIServices()
{
    for (uint8_t picIdx=0; picIdx<ACTUATOR_COUNT; picIdx++) {
        if (taskIdPiControl[picIdx]!=TASKMGR_INVALIDID) {
            taskManager.cancelTask (taskIdPiControl[picIdx]);
            taskIdPiControl[picIdx]=TASKMGR_INVALIDID;
        }
    }
}

void CVdmTask::startPIServices(bool startTask)
{
    restartPiTask=false;
    #ifdef EnvDevelop
        UART_DBG.println("Start pi tasks "+String(startTask));
    #endif
    for (uint8_t picIdx=0; picIdx<ACTUATOR_COUNT; picIdx++) { 
        if (VdmConfig.configFlash.valvesControlConfig.valveControlConfig[picIdx].controlFlags.active) {
            if (VdmConfig.configFlash.valvesControlConfig.valveControlConfig[picIdx].link==0) { 
                PiControl[picIdx].valveIndex=picIdx;
                PiControl[picIdx].ti=VdmConfig.configFlash.valvesControlConfig.valveControlConfig[picIdx].ti;
                PiControl[picIdx].xp=VdmConfig.configFlash.valvesControlConfig.valveControlConfig[picIdx].xp;
                if (VdmConfig.configFlash.valvesControlConfig.valveControlConfig[picIdx].xp!=0)
                    PiControl[picIdx].kp=100.0/VdmConfig.configFlash.valvesControlConfig.valveControlConfig[picIdx].xp;
                else PiControl[picIdx].kp=1;
                PiControl[picIdx].offset=VdmConfig.configFlash.valvesControlConfig.valveControlConfig[picIdx].offset; 
                PiControl[picIdx].ki=VdmConfig.configFlash.valvesControlConfig.valveControlConfig[picIdx].ki; 
                PiControl[picIdx].scheme=VdmConfig.configFlash.valvesControlConfig.valveControlConfig[picIdx].scheme;
                PiControl[picIdx].startActiveZone=VdmConfig.configFlash.valvesControlConfig.valveControlConfig[picIdx].startActiveZone;
                PiControl[picIdx].endActiveZone=VdmConfig.configFlash.valvesControlConfig.valveControlConfig[picIdx].endActiveZone;
                if (StmApp.motorChars.startOnPower>100) StmApp.motorChars.startOnPower=0;
                PiControl[picIdx].startValvePos=StmApp.motorChars.startOnPower;
                if (startTask) {
                    if (VdmConfig.configFlash.valvesControlConfig.valveControlConfig[picIdx].ts>0) {
                        if (taskIdPiControl[picIdx]==TASKMGR_INVALIDID) {
                            //UART_DBG.println("Start pi tasks valve # "+String(picIdx)+":"+String(VdmConfig.configFlash.valvesControlConfig.valveControlConfig[picIdx].ts));
                            taskIdPiControl[picIdx] = taskManager.scheduleFixedRate(VdmConfig.configFlash.valvesControlConfig.valveControlConfig[picIdx].ts, &PiControl[picIdx], TIME_SECONDS);
                            //UART_DBG.println("Start pi tasks valve #"+String(picIdx)+":"+String(taskIdPiControl[picIdx]));
                        }
                    }
                }
            }
        }
    }
}


void CVdmTask::startClearFS()
{
    taskIdRunOnceClearFS = taskManager.scheduleOnce(100, [] {
                VdmSystem.clearFS();
    });
}

void CVdmTask::startGetFS()
{
    taskIdRunOnceGetFS = taskManager.scheduleOnce(100, [] {
                VdmSystem.getFSDirectory();
    });
}


void CVdmTask::deleteTask (taskid_t taskId)
{
  taskManager.cancelTask (taskId);
}

void CVdmTask::disOrEnableTask (taskid_t taskId,bool enabled)
{
    if (taskId=!TASKMGR_INVALIDID) taskManager.setTaskEnabled(taskId, enabled);
    //UART_DBG.println("task enable "+String(taskId)+":"+String(enabled));
}

bool CVdmTask::taskExists (taskid_t taskId)
{
   return (taskManager.getTask(taskId)!=NULL);
}

void CVdmTask::yieldTask (uint16_t ms)
{
    taskManager.yieldForMicros(ms*1000);
}
