Lenti84/VdMot_Controller/software_stm32/src/otasupport.cpp

/**HEADER*******************************************************************
  project : VdMot Controller
  author : Lenti84
  Comments:
  Version :
  Modifcations :
***************************************************************************
*
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
**************************************************************************
  This program is free software: you can redistribute it and/or modify
  it under the terms of the GNU General Public License as published by
  the Free Software Foundation, either version 3 of the License.
  See the GNU General Public License for more details.
  You should have received a copy of the GNU General Public License
  along with this program.  If not, see <http://www.gnu.org/licenses/>.
  Copyright (C) 2021 Lenti84  https://github.com/Lenti84/VdMot_Controller
*END************************************************************************/

#include <Arduino.h>
#include "hardware.h"
#include "otasupport.h"

void JumpToBootloader(void);
    
uint8_t bootstate = 0;

void BootSetup(void) {

  // LED
  pinMode(LED, OUTPUT);
  digitalWrite(LED, LOW);

  // UART to ESP32
  Serial1.setRx(PA10);			    //STM32F401 blackpill USART1 RX PA10
  Serial1.setTx(PA9);		        //STM32F401 blackpill USART1 TX PA9
  Serial1.begin(115200, SERIAL_8E1);
  while(!Serial1);
  delay(10);

  while (Serial1.available()) Serial1.read();

}


void BootLoop(void) {

  static unsigned int timer = 0;
  static int ledtimer = 0;
  static int state = 0;
  unsigned char buffer2[10];

  if (state == 0) {
    timer++;
    if(timer > 3000) state = 2;
  
    if (Serial1.available() >= 8) {        
      Serial1.readBytes(buffer2, 8);
      if(memcmp("DEADBEEF",&buffer2[0],8) == 0) {
        state = 1;
        digitalWrite(LED, LOW);
      }
    }

    if (ledtimer > 100) {
      digitalWrite(LED, !digitalRead(LED));   // toggle LED
      ledtimer=0;
    }
    else ledtimer++;

    delay(1);
  }
  else if(state == 1) {
      digitalWrite(LED, HIGH);
      delay(10);        // delay for init
      Serial1.println("BEEFIT");
      Serial1.flush();
      delay(200);        // wait for send
      JumpToBootloader();
      
  }
  else if (state == 2) {
      bootstate = 1;
  }

}


/**
 * Function to perform jump to system memory boot from user application
 *
 * Call function when you want to jump to system memory
 */
void JumpToBootloader(void) {
    void (*SysMemBootJump)(void);
    
    /**
     * Step: Set system memory address. 
     *       
     *       For STM32F429, system memory is on 0x1FFF 0000
     *       For other families, check AN2606 document table 110 with descriptions of memory addresses 
     */
    volatile uint32_t addr = 0x1FFF0000;
    
    /**
     * Step: Disable RCC, set it to default (after reset) settings
     *       Internal clock, no PLL, etc.
     */
#if defined(USE_HAL_DRIVER)
    HAL_RCC_DeInit();
#endif /* defined(USE_HAL_DRIVER) */
#if defined(USE_STDPERIPH_DRIVER)
    RCC_DeInit();
#endif /* defined(USE_STDPERIPH_DRIVER) */
    
    /**
     * Step: Disable systick timer and reset it to default values
     */
    SysTick->CTRL = 0;
    SysTick->LOAD = 0;
    SysTick->VAL = 0;
 
    /**
     * Step: Disable all interrupts
     */
    __disable_irq();
    
    /**
     * Step: Remap system memory to address 0x0000 0000 in address space
     *       For each family registers may be different. 
     *       Check reference manual for each family.
     *
     *       For STM32F4xx, MEMRMP register in SYSCFG is used (bits[1:0])
     *       For STM32F0xx, CFGR1 register in SYSCFG is used (bits[1:0])
     *       For others, check family reference manual
     */
    //Remap by hand... {
#if defined(STM32F4)
    SYSCFG->MEMRMP = 0x01;
#endif
#if defined(STM32F0)
    SYSCFG->CFGR1 = 0x01;
#endif
    //} ...or if you use HAL drivers
    //__HAL_SYSCFG_REMAPMEMORY_SYSTEMFLASH();    //Call HAL macro to do this for you
    
    /**
     * Step: Set jump memory location for system memory
     *       Use address with 4 bytes offset which specifies jump location where program starts
     */
    SysMemBootJump = (void (*)(void)) (*((uint32_t *)(addr + 4)));
    
    /**
     * Step: Set main stack pointer.
     *       This step must be done last otherwise local variables in this function
     *       don't have proper value since stack pointer is located on different position
     *
     *       Set direct address location which specifies stack pointer in SRAM location
     */
    __set_MSP(*(uint32_t *)addr);
    
    /**
     * Step: Actually call our function to jump to set location
     *       This will start system memory execution
     */
    SysMemBootJump();
    
    /**
     * Step: Connect USB<->UART converter to dedicated USART pins and test
     *       and test with bootloader works with STM32 Flash Loader Demonstrator software
     */
}
