Lenti84/VdMot_Controller/(commit log)

2020-12-30 Create b-sample_pcb_3D.PNG
    b-sample pcb 3D print
2020-12-30 Update README.md
    added 3D pcb image
2021-01-06 basic motor control
    valve moves open / close by command, basic valve learning
2021-01-26 slow turn on and mean current measurement
2021-02-07 added valve tests
2021-02-12 added testmode
    added testmode with fast cyclic output of motor current and position of valve
2021-02-12 move stm32 files
2021-02-12 rearranged repo for stm32 software
2021-10-10 Create bom.htm
    b-sample bom
2021-10-10 BOM link added
2021-10-15 c-sample 3d pcb
2021-10-30 changes for c-sample
    changed from STM32F103C8 (bluepill) to STM32F401CC (blackpill), OneWire sensors working, OneWire sensors can be linked to valves via terminal communication, changed to I2C eeprom, test of CAN via MCP2515 and Modbus via RS485, test code for analog current measurement instead of INA219
2021-11-01 some tests performed, STM32 changed
2021-11-07 declaration CWebOTA class (#6)
    Change delay functions to prevent a 42 day delay in case of wrap around
    [app.cpp, main.cpp, mqtt.cpp]
2021-11-08 C-samples ordered
2021-11-18 Added C-Sample schematic
2021-11-22 Changed from ESP8266 to ESP32
    Changed from ESP8266 to ESP32, first communication to STM32 established, simple web frontend working, simple logging implemented
2021-11-22 added status of ESP32 software
    some screenshots added
2021-12-01 pictures of c-sample PCB added
2021-12-05 Added THT assembly drawing
2021-12-07 some missing files added
    [VdmTask.cpp, VdmTask.h]
2021-12-09 Autodetection of eth or wifi added website improved app added, but not tested mqtt broker added, but not tested
    [VdmConfig.cpp, VdmConfig.h, VdmNet.cpp, VdmNet.h, VdmTask.cpp, VdmTask.h, mqtt.cpp]
2021-12-10 changes for c-sample support
    1-wire now via GPIO, current measurement via opamp, no INA219 needed, timeouts increased, enable/disable of valve psu,
2021-12-10 Update main.cpp
    info about changes to arduino core lib added
2021-12-10 description of STM32 OTA approach
2021-12-10 STM32 commands added
2021-12-15 website improved and bugfixes
    [Services.cpp, Services.h, VdmConfig.cpp, VdmConfig.h, VdmNet.cpp, VdmNet.h, VdmSystem.cpp, VdmSystem.h]
2021-12-16 commands added, clean up, 2nd 1-wire sensor per valve added
2021-12-22 Locking task stmApp und StmOta improved. Use VdmTask.yieldTask instead delay inside of a task if ssid or wifi pathword doesn't exists don't start wifi, switch to ETH instead
    [Services.cpp, Services.h, VdmNet.cpp, VdmTask.cpp, VdmTask.h, stm32.cpp, stm32.h, stmApp.cpp]
2021-12-22 factory restore handler added = IO pin 2
2021-12-22 fixed permanent reset of STM32 due to missing _setup call
    [VdmTask.cpp, main.cpp, stm32.cpp]
2022-01-02 cycletime STM32 ota task reduced
    active waiting for data packet eliminated with some extra states
2022-01-02 improved relay handling
    relay is switched off together with psu after 15s of inactivity, no unnecessary switching after each valve transaction
2022-01-04 command for 1-wire bus search added
    1-wire bus search can be triggered by terminal or by ESP command
2022-01-05 website improved , some bugfixes
    [Services.cpp, Services.h, VdmSystem.cpp, VdmSystem.h, VdmTask.cpp, communication.cpp, globals.h, mqtt.cpp]
2022-01-05 stm32 and stm32ota: classes added Website improved
2022-01-16 web site improved; add valves state in Status page. Add day select for learning valvesAssembly Add queue for command handling
2022-01-16 Bugfix : Sensor list
    [ServerServices.cpp, stmApp.cpp, stmApp.h, tfs_data.c, web.cpp]
2022-01-17 add missing files add motor movements and max current adjustable in config
    [Queue.cpp, Queue.h, ServerServices.cpp, Services.cpp, VdmConfig.cpp, VdmConfig.h, app.h, communication.cpp]
2022-01-17 2nd temperature sensor added to ESP struct of valves
2022-01-18 Bugfix website Mqtt : Topics for valves as defined in config valve name
    [Services.cpp, globals.h, helper.cpp, helper.h, mqtt.cpp, mqtt.h, tfs_data.c]
2022-01-19 TIdx in valve config added
2022-01-19 temp1 and temp2 added in valve config
2022-01-19 commands added, eeprom rework, current bound source changed
    [app.cpp, communication.cpp, eeprom.cpp, eeprom.h, hardware.h, main.cpp, motor.cpp, terminal.cpp]
2022-01-19 corrected sensor count
2022-01-20 some bug fixes TIdx added
    [ServerServices.cpp, Services.cpp, VdmConfig.cpp, VdmNet.cpp, VdmSystem.h, VdmTask.cpp, VdmTask.h, WT32AsyncOTA.cpp]
2022-01-21 new command and valve state detection added
2022-01-21 bugfix in stm : NumerofWireCount was always 0
    [Services.cpp, VdmConfig.cpp, communication.cpp, stmApp.cpp, stmApp.h]
2022-01-22 add set motorchars
2022-01-23 some bugfixes in stm. add sensors in valves table
    [app.cpp, app.h, communication.cpp, communication.h, eeprom.cpp, eeprom.h, hardware.h, motor.cpp]
2022-01-26 bugfixes in reading valves website improved
    [VdmNet.cpp, communication.cpp, main.cpp, stmApp.cpp, stmApp.h, tfs_data.c, web.cpp]
2022-01-26 MQTT Bugfix and Debug Support
    [motor.cpp, mqtt.cpp]
2022-02-03 Add defines for COMM_DBG.print Add delay at switching relay for settling
2022-02-03 info messages added, little debug rework
    [app.cpp, motor.cpp, temperature.cpp]
2022-02-05 Celsius/Fahrenheit added small bugfixes
    [VdmTask.cpp, VdmTask.h, app.cpp, motor.cpp, stmApp.cpp, stmApp.h, tfs_data.c]
2022-02-08 communication from/to STM32 improved, timeout handler added Reset STM in case of no answer over a long time and many retries
    [Services.cpp, Services.h, VdmConfig.cpp, VdmConfig.h, VdmNet.cpp, communication.cpp, communication.h, globals.h]
2022-02-08 bugfix current measurement
    ADC conversion is interfered by 1-wire sensor evaluation, so we stop 1-wire activities during valve movement --UNTESTED--
    [motor.cpp, temperature.cpp, temperature.h]
2022-02-09 bugfix: 1-wire pause lock fixed
    1-wire measurements now paused during moving valves -> less ADC interference
    [motor.cpp, temperature.cpp]
2022-02-12 reset config changed to very beginning debug log added in platformio.ini
    [VdmConfig.cpp, VdmConfig.h, VdmNet.cpp, VdmTask.cpp, VdmTask.h, globals.h, main.cpp]
2022-02-13 bug fix, new command
    new command for reset status of all valves, bugfix for command "set all valves open" / assembly position, lowered default current bounds
    [communication.cpp, communication.h, motor.cpp, stmApp.cpp, terminal.cpp]
2022-02-14 add scan valves
2022-02-14 Bugfix in website : display valve set button StmApp.cpp : read T-Idx for valves Button for detect valves added
    esp platformio.ini : simulation for valves added
    [ServerServices.cpp, communication.cpp, communication.h, motor.cpp, stmApp.cpp, stmApp.h, terminal.cpp]
2022-02-19 add missing APP_PRE_SETDETECTVLV return from stm
    [stmApp.cpp]
2022-02-25 add json valve control
2022-02-26 bugfix in VdmTask. Ki setting was missing
    [PIControl.cpp, PIControl.h, VdmTask.cpp, tfs_data.c]
2022-03-04 introduce active zone for valves
2022-03-04 add valvescontrol picture
2022-03-04 with reboot command resets STM also
    [ServerServices.cpp, Services.cpp]
2022-03-07 add valvescontrol.png in softeware.md
2022-03-15 bugfix timing problen in STMApp case COMM_SENDTARGET: update of target_position_mirror must done immediately after checking new data. otherwise the new data could be erased without sending to STM
    [PIControl.cpp, stmApp.cpp]
2022-03-15 bugfix valve state detection
    improvements for detection of valve state after startu and during operation, improved ESP32<>STM32 command interface
    [app.cpp, main.cpp, motor.cpp, stmApp.cpp]
2022-04-10 stm32 correct
2022-04-20 Added C2-Revision schematic
    C2-Revision of schematic with Variant V02 assembly
2022-04-20 Added C2-sample THT assembly drawing
    Assembly drawing for THT components for C2 revision
2022-04-20 Added C2 sample infos
2022-05-02 timeout for valve turning added, added new STM32 C2 sample software change
    added a timeout for normal valve turning, otherwise a broken wire or valve would have never escaped turning, for C2 hw revision a fix for a crossed logic level at MUXer pin is introduced
    [app.cpp, hardware.h, motor.cpp, terminal.cpp]
2022-06-07 added esp32 flash info and .bin files
2022-06-07 Added ESP32 flashing instructions
2022-06-07 fixed compile problem
    Details see: https://github.com/Lenti84/VdMot_Controller/issues/31
    [helper.cpp]
2022-08-20 Correct problem with strncat (warnings during compilation) Bug fix in eth initialisation. (Eth will not start after reset) Add checkbox for 'Publish all temps' in mqtt.
    [VdmConfig.cpp, VdmConfig.h, VdmNet.cpp, mqtt.cpp, tfs_data.c, web.cpp]
2022-08-21 bugfix mqtt : sending message
    [VdmSystem.cpp, VdmSystem.h, mqtt.cpp]
2022-10-18 added/corrected information about boards
    added board version info and fixed broken picture link
2022-10-18 OneWire lib update, added STM32F411
    compiles but untested!
2022-10-20 with the version v2.0 of spiffs the pseudo dir with "/" is not working any longer. So the implementation of "stm" directory is removed. Introduce format of spiffs ----------------------- BREAKING CHA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
    [ServerServices.cpp, VdmNet.cpp, VdmSystem.cpp, communication.cpp, otasupport.cpp, stm32.cpp, stm32.h]
2022-10-20 small STM32OTA changes
    prepared STM32F411 support - very experimental, fixed UI messages
    [stm32.cpp, stm32ota.cpp, web.cpp]
2022-11-09 OneWire and WiFi fixes
    Included OneWire library to change from push-pull output to open-drain out, fixed WiFi issue (no SoftAP anymore, only Station Mode), added some delays to STM32 flash routine
    [VdmNet.cpp, stm32.cpp, temperature.cpp]
2022-11-11 added await in onload function introduce timezone change format and getfsdir function to a task function, prevent tcp async watchdog timeout
    [ServerServices.cpp, Services.cpp, Services.h, VdmConfig.cpp, VdmConfig.h, VdmNet.cpp, VdmSystem.cpp, VdmSystem.h]
2022-11-14 Environment 411 for C1 Sample
2022-12-15 V1.06
    Bugfix:
    missing prefs.end in vdmconfig added
    don't start pi-control task, if ts = 0
    mqtt compare topics with non leading slash
    Changes:
    Introducing start valve position after power on
    start pi-control tasks delayed
    [PIControl.cpp, PIControl.h, Services.cpp, VdmConfig.cpp, VdmTask.cpp, VdmTask.h, communication.cpp, eeprom.cpp]
2022-12-18 Update assembly_kit.md
    made distinction between C1- and C2-sample
2023-01-04 V1.0.7 release - 1-wire improvements and new commands
    fixed 1-wire sensor issues (linking to valves); release versions will be marked as "release"; added new STM32 commands: STM32 software reset added (waits for eeprom to be written), match sensors;
    [Services.cpp, VdmConfig.cpp, app.cpp, app.h, communication.cpp, communication.h, compile_time.h, eeprom.cpp]
2023-01-16 added C3 sample info and STM32 flashing info
2023-01-16 added C3-sample info
2023-01-23 v 1.08 : Softreset timing changed. Still some problems with soft reset.
    [ServerServices.cpp, Services.cpp, Services.h, VdmConfig.cpp, VdmTask.cpp, WT32AsyncOTA.cpp, app.cpp, eeprom.cpp]
2023-01-23 bugfix calibration settings
2023-01-30 add debug info, correct build flag
    [stmApp.cpp]
2023-01-30 clean up
    removed double code, initialized more variables correctly, removed duplicate declaration
    [app.cpp, communication.cpp, eeprom.cpp, motor.cpp, temperature.cpp, terminal.cpp]
2023-02-19 Create c2-sample_pcb_soldered.jpg
    added picture of actual C2-sample PCB with soldered components
2023-02-19 added picture of c2-sample pcb
2023-02-23 added 3D pcb data
2023-02-28 added debugging support and test fixes
    modified software for debugging purposes and added some test fixes
    - ESP32: added Uptime counter, this value is published via mqtt topic /common/uptime
    - STM32: max read length for UART buffer is limited to 990 now, not unlimited anymore
    - STM32: valve_loop() is now colled via timer interrupt, this hopefully ensures correct motor drive and stopping during high system loads
    [VdmSystem.cpp, VdmSystem.h, VdmTask.cpp, VdmTask.h, communication.cpp, compile_time.h, main.cpp, motor.cpp]
2023-03-02 * Fixed buffer overflow by unbound memcpy (closes #75) * Removed redundant code * Reduced scope of `value`
    [mqtt.cpp]
2023-03-02 Update ESP32_firmware.bin
    update after merge of pr/78
2023-03-09 Version 1.1.0 ESP32: ### Changed - MQTT : publish esp32 reset reason - MQTT : publish esp32 uptime (in config activate/deactivate) - MQTT : don't set the actuators.target_position if valve is deactiv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
    [PIControl.cpp, ServerServices.cpp, ServerServices.h, Services.cpp, Services.h, VdmConfig.cpp, VdmConfig.h, VdmNet.cpp]
2023-03-10 V1.1.0 Beta 2 Remove forceHardreset, always hardreset except at power on small fixes in webui
    [ServerServices.cpp, Services.cpp, Services.h, VdmConfig.cpp, VdmTask.cpp, WT32AsyncOTA.cpp, compile_time.h, globals.h]
2023-03-12 small bugfix in config
    [PIControl.cpp, VdmConfig.cpp, VdmTask.cpp, compile_time.h]
2023-03-27 Show link# in website status if a valve is linked to another
2023-03-31 STM32 : define serial buffer size to 1024. Because stm is 32 bit mcu this should not an issue: buffer size > 256 bytes
    [communication.cpp, compile_time.h]
2023-04-18 ## [1.2.0] ### Breaking Changed - use LittleFS instead SPIFFS, all files will be removed with update. ### Added - messenger : pushover in case of errors ### Changed - CWT32AsyncOTA::restart() : direc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
    [Messenger.cpp, Messenger.h, PIControl.cpp, PushOver.cpp, PushOver.h, VdmConfig.cpp, VdmConfig.h, VdmNet.cpp]
2023-04-19 ## [1.2.0] ### Breaking Changed - use LittleFS instead SPIFFS, all files will be removed with update. ### Added - messenger : pushover and email support in case of errors ### Changed - CWT32AsyncOTA: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
    [Messenger.cpp, Messenger.h, ServerServices.cpp, VdmConfig.cpp, VdmConfig.h, VdmSystem.cpp, VdmTask.cpp, main.cpp]
2023-08-01 add valve moves
2023-08-06 ## [1.2.2] ### Added - status page : display valve movements and counts ### Fixed - hour time was not set correctly when only changed hour time
    [communication.cpp, stmApp.cpp, stmApp.h, tfs_data.c, web.cpp]
2023-08-09 display status even a login user exists, set valve checkbox is disabled in this case
2023-08-09 bugfix: movements not shown correctly
    [app.cpp, app.h, communication.cpp, compile_time.h, motor.cpp]
2023-08-09 set active valve slider to display none if a user login exists and not logged in
2023-09-24 Added C4 sample information
2023-09-24 added C4 sample schematic
2023-09-24 revert back to C2 revision
    I accidentially uploaded C4 over C2 sample schmeatic, now reverted
2023-09-24 added C4 hardware revision schematic
2023-10-27 V1.2.4 Window handling added, small bugfix in handling linked valves
    [PIControl.cpp, PIControl.h, VdmTask.cpp, VdmTask.h, mqtt.cpp]
2023-11-12 V1.3.0 Changes STM: ## [1.3.0] ### Fixed - calibration move numbers was not set from eeprom - calibration function was not correct ### Added - send calibration state to WTH32
    Changes WTH:
    ## [1.3.0]
    ### fixed
    - Issue #110 : MQTT sending uptime
    ### Added
    - window icon
    - Issue 111 : Automatic wifi reconnect if lost
    - MQTT : send calibration time/date of valve when calibration is in progress
    - MQTT : send link # of valve if exists
    - Website : display calibration info in status page when calibration is in progress
    [PIControl.cpp, PIControl.h, Services.cpp, VdmConfig.cpp, VdmConfig.h, VdmNet.cpp, VdmNet.h, VdmSystem.cpp]
2023-11-18 WTH32 ## [1.3.1] ### fixed - website : reload page remains on the actual page ### Added - website and mqtt : visualization of failed DS18 sensors - valve : timeout of mqtt received tValue : set valve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
    STM32
    ## [1.3.1]
    - next calibration : movements set to min. 50
    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
    [PIControl.cpp, PIControl.h, PushOver.cpp, PushOver.h, Services.cpp, Services.h, VdmConfig.cpp, VdmConfig.h]
2024-01-13 V1.3.3 ### Added - Website : Show chip and program size information More info during flashing on website - Syslog : added with ota STM32 ### Changed - OTA STM32 : more relaxed timing, replace infinit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
    [VdmSystem.cpp, VdmSystem.h, VdmTask.cpp, app.cpp, communication.cpp, communication.h, compile_time.h]
2024-01-17 faster current measurement and overcurrent detection
    measuring every 1 ms instead of 10 ms, over current detection in same cycle
2024-01-18 V1.3.4 stm - faster motor end detection
2024-01-27 V1.3.4 ### Changed - faster motor end detection ### Added - min. pulse in eeprom/website
2024-01-28 calibration retries if counts less than min. counts in config
2024-02-02 V1.3.4 ### Added - Website : min. couts max. calibration retries publish diag information - MQTT : counts in topic diag ### Breaking Change - MQTT : meancur is now in topic diag/meancurrent
2024-02-02 V1.3.4 Typo error fixed
    [VdmConfig.cpp, compile_time.h, mqtt.cpp, stmApp.cpp, stmApp.h, tfs_data.c, web.cpp]
2024-02-18 rework motor end detection
    changed filtering of motor current, no soft PWM for motor turn on anymore
    [compile_time.h, hardware.h, motor.cpp]
2024-03-10 1.3.6 WTH32: ### Fixed - System : fix bug if no network time exists ### Added - WebUI : show information on status bar ### Changed -platform.ini Board Info is now wt32-eth01
    STM32:
    - rework motor end detection (filtering of motor current, no soft PWM for motor turn on anymore)
    [Services.cpp, VdmConfig.cpp, VdmNet.cpp, VdmNet.h, VdmSystem.cpp, VdmSystem.h, communication.cpp, compile_time.h]
2024-07-13 V1.3.7 WTH32 ### Changed - System : increase DYNAMIC_JSON_DOCUMENT_SIZE to 4096 - WebUI : Config Assembly / Calibration select valve added STM32 ### Fixed - Config : fix bug valve 12 set tIdx1 and tI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
    [PushOver.cpp, ServerServices.cpp, Services.cpp, app.cpp, communication.cpp, compile_time.h, stmApp.cpp]
